kanuba0814/puzzle-arm/official_docs/README.md

# official_docs

该目录只放官方资料、论文原文和来源锁。不要把论坛总结、二手教程或未经核对的参数放入此目录。

- `competition/`：赛题原文
- `papers/`：ACT 与 LeRobot 论文
- `raspberry_pi/`：官方产品简报
- `datasheets/`：厂商规格书
- `INDEX.md`：人工阅读索引
- `sources.lock.json`：机器可读来源、版本、URL、哈希和状态

动态网页没有伪装成本地完整镜像。需要离线克隆的仓库必须在开发机上记录 commit 和 SHA256。
