kanuba0814/puzzle-arm/workspace/calibration/evidence/2026-07-31_first_hardware_motion/README.md

# 2026-07-31 首次真实硬件动作

同一台改装 SO-101 五轴机械臂完成了首次使能力矩与真实运动。全过程 Supervisor inactive，电磁铁保持关闭。

## 结果

1. 当前位置 bumpless hold：断力矩时先把五轴 `Goal_Position` 写成对应 `Present_Position`，再使能力矩 2 秒；五轴最大编码器漂移均为 0，随后断力矩。
2. 最小往返：`park → high_home → P上方60 mm → Q上方60 mm → P上方60 mm → high_home → park`。
3. 命令分辨率 1°、周期 0.1 s；观测到的最大跟随误差 `4.341246°`，低于本次 `6°` 中止阈值。
4. 各阶段最终最大误差 `2.637363°`；返回停放位最大误差 `1.054945°`。
5. production `MotionController` 随后完成 P高位（19/19 waypoints）、Q高位（7/7）、P返回（8/8）和 HOME（21/21），全部 `error_code=NONE`。
6. P 点随后完成 60/20/10/20/60 mm、每点停留 5 秒的低位观察；操作者确认 10 mm 过低或碰纸，因此拒绝作为自动安全高度。
7. P 点 20 mm 单独停留 10 秒后，操作者确认“高度合适，作为安全低位”；竞赛 PREGRASP/观察高度冻结为 20 mm，PICK 接触高度仍为 `UNKNOWN`。
8. 12 点快速巡航全部通过，但 5°/单样本到位门槛使终点在负载下提前判定，操作者观察到整体向机械臂方向缩 10–20 mm。
9. D 点精确保持将偏差显著缩小；随后使用“远离机械臂 3 mm、命令 pitch=-87.5°”负载补偿重复两次，实际姿态 `pitch=-90.03°`，操作者确认位置与垂直度均正常。
10. 最终已回到原停放区域并断力矩；未执行吸取或自动 Supervisor 流程。

## 现场教训

悬空阶段之间不能断力矩，否则重力会使关节下垂并破坏下一阶段的起点。实际 commissioning 应在一个受监控序列内持续保持力矩，最后先回到有支撑的停放位，再断力矩。

完整机器可读记录见本目录 JSON，特别是 `production_low_height_observation.json` 与 `production_precision_compensation.json`。数值来自舵机读回日志；低位和视觉对准结论包含明确标注的操作者现场观察。
