kanuba0814/puzzle-arm/docs/00_范围与冻结决策.md

# 00 范围与冻结决策

## 项目目标

在一次按键启动后，无人工干预地完成 E 题规定的碎片识别、搬运、拼接、结束指示，并适应正常室内照明。

## 赛题硬约束

- 工作面为纵向 A4 纸。
- 碎片初始位于上半区域，拼图在下半区域完成。
- 自备碎片为 4 片、同色、纯色、厚度不大于 2 mm。
- 现场碎片不大于 4 片，每片不大于 5 条边，每条边不小于 2 cm。
- 现场碎片由约 0.3 mm 镀锌薄铁片与纸片组成，总厚度不大于 2 mm、重量不大于 30 g。题面未进一步说明 30 g 是单片还是整组上限，工程验证按“任一被抓取碎片可达 30 g”这一保守条件执行。
- 目标矩形尺寸在 9 cm x 5 cm 至 12 cm x 9 cm 之间。
- 相邻碎片对应顶点距离均不大于 2 cm。
- 每项最长 2 分钟。
- 启动前摄像头被遮挡；移除遮挡并一键启动后全自动运行。
- 测试不得要求特殊照明。

## 已冻结架构

### 必做基线

- 顶置固定相机，eye-to-hand。
- OpenCV 完成标定、分割、轮廓、位姿、抓取点、放置复核。
- 几何/纹理拼图求解器输出目标位姿和顺序。
- SO-101 去掉夹爪后保留 5 个关节舵机。
- 机械臂大范围运动由 IK + 固定安全高度轨迹完成。
- 末端使用电磁吸头；电磁铁由独立 GPIO/MOSFET 状态机控制。
- 完成动作后重新拍照，失败则重新规划，不依赖开环假设。

### ACT 的固定职责

ACT 仅用于以下短程技能之一：

- 预抓取点附近最后几厘米的对准和下降；
- 预放置点附近的小范围位置与角度修正；
- 可选的失败恢复技能。

ACT 不负责：拼图求解、选择碎片、全局路径、电磁铁开关、安全限位、任务完成判定。

## 暂不采用

- SmolVLA 或更大 VLA 本地端到端控制；
- MoveIt 全套三维规划；
- 多相机首版；
- ACT 控制电磁铁开关；
- 首版复杂逆向退磁电路；
- 直接修改系统安装目录内的 LeRobot 源码。

## 关键决策门

1. 单片确定性抓放未达到 90% 成功率，不进入 ACT 数据采集。
2. 电磁铁在“纸层/结构形成的最坏有效间隙”下不能可靠吸取 30 g 保守测试片，立即换磁头或改末端。
3. Pi 5 上 ACT 推理 p95 延迟高于 500 ms、持续积压或造成控制不连续，比赛版本关闭 ACT。
4. 现场未知白色碎片几何求解未稳定，优先保证自备 50 分与现场白色 20 分，不牺牲已有功能追求花纹题。
