kanuba0814/puzzle-arm/docs/01_赛题需求追踪矩阵.md

# 01 赛题需求追踪矩阵

| 编号 | 题面要求 | 系统模块 | 验证方法 | 工程目标 |
|---|---|---|---|---|
| R1 | 自备 4 片从上半区移至下半区 | Vision、Planner、Control | 随机摆放后 20 次全流程 | 20/20 均完成搬运 |
| R2 | 自备碎片拼成正确矩形 | Template Solver、Placement | 20 次随机位置和角度 | 完整成功率 >= 95% |
| R3 | 相邻顶点距离 <= 2 cm | Vision Verify | 俯视测量顶点偏差 | 内部目标 <= 5 mm |
| R4 | 现场白色碎片不大于 4 片 | Geometry Solver | 多套模拟碎片盲测 | 20 套中 >= 18 套成功 |
| R5 | 现场扑克牌图案对应正确 | Texture Solver | 打印牌面碎片盲测 | 几何正确后纹理方案排名第一 |
| R6 | 单项 <= 2 分钟 | Supervisor、Trajectory | 统计端到端时长 | 目标 <= 90 s，预留 30 s |
| R7 | 一键启动、无人工干预 | Supervisor | 遮挡相机后启动 | 全流程无需键盘和鼠标 |
| R8 | 完成后声/光指示 | I/O | 完成与失败状态测试 | 明确区分成功、可恢复失败、终止失败 |
| R9 | 正常室内照明，无特殊照明 | Vision | 多个普通室内照明场景 | 不依赖临时补光或黑箱 |
| R10 | 碎片不重叠 | Solver、Verify | 多边形碰撞检测+图像复核 | 规划无重叠，落位后再检测 |
| R11 | 现场碎片每片至少一条外边 | Geometry Solver | 外边候选枚举 | 用于剪枝，不作为唯一假设 |
| R12 | 总厚度 <= 2 mm、重量 <= 30 g | End Effector | 等效测试片 | 通过纸层/间隙仍可靠吸放 |

## 评分优先级

1. 自备碎片搬运与拼接：50 分。
2. 现场白色碎片：20 分。
3. 现场扑克牌图案：30 分。
4. 设计报告：20 分。

任何后续功能不得破坏已经通过的上一层验收。

## 事实分类

- 表中“题面要求”来自正式 E 题 PDF。
- “工程目标”是项目内部验收阈值，不是组委会评分线。
- 对题面“重量不大于 30 g”的对象范围存在语义空间；硬件按单次抓取 30 g 的保守条件验证，最终解释仍以现场组委会为准。
