kanuba0814/puzzle-arm/docs/06_拼图求解器.md

# 06 拼图求解器

## 自备固定碎片

预先建立模板库：

- 标准轮廓与顶点顺序；
- 允许的等价旋转；
- 模板目标中心与目标角度；
- 推荐抓取点；
- 放置顺序。

运行时只做身份匹配和当前位姿估计，禁止用通用搜索替代已经确定的模板方案。

## 现场白色碎片

已知约束：碎片不大于 4 片、每片不大于 5 边、每条边不小于 2 cm、每片至少一条边属于目标矩形外边。规模很小，适合确定性枚举，而不是神经网络。

### 表示

每块碎片存储有向多边形：

- 顶点坐标；
- 边长；
- 内角/转角；
- 面积；
- 候选外边；
- 抓取点。

### 搜索

1. 枚举目标矩形尺寸候选，由总面积和边界组合约束剪枝。
2. 枚举碎片排列和离散朝向。
3. 将候选匹配边对齐，生成刚体变换。
4. 检查边长差、顶点误差、面积覆盖、碎片重叠和越界。
5. 检查所有碎片的外边约束。
6. 对完整方案按几何误差排序。

由于最多 4 片，分支限界或回溯足够，不需要近似大型优化器。

## 扑克牌图案

先生成几何可行候选，再计算纹理成本：

- 相邻边内侧窄条带的颜色/梯度差；
- 线条方向连续性；
- 花色轮廓和字符笔画连续性；
- 候选合成图的整体边界一致性。

不要首先依赖 ORB：白底牌面纹理稀疏，边缘窄条像素成本和轮廓连续性通常更直接。ORB 可作为补充证据。

## 放置顺序

- 优先放角块与边界明确的块。
- 优先放目标位置周围空间较大的块。
- 最后一块预留插入空间；如空间不足，采用从中心向外或先内部后边界的顺序。
- 每放一块重新识别，不沿用理想位姿。

## 求解器输出

每个 `PlacementPlan` 必须包含：

- `piece_id`
- `source: {frame: "table_mm", center_mm, yaw_deg}`
- `target: {frame: "table_mm", center_mm, yaw_deg}`（target yaw 为权威放置姿态）
- `order`、`geometry_score`、`texture_score`、`texture_status`
- `plan_confidence`、`source_timestamp_ns`、`equivalent_yaws_deg`
- `solver_version`

置信度不足时禁止机械臂动作。
