kanuba0814/puzzle-arm/docs/12_测试与验收计划.md

# 12 测试与验收计划

## 证据标签

- `synthetic-unit` / `synthetic-pixel`：程序生成或毫米几何测试，不能陈述为真机结果。
- `recorded-hardware`：带原始帧、标定 SHA256 的实拍回放。
- `pi5-benchmark`：仅 Pi 5 正式环境的延迟/RSS 记录。
- `blind-hardware`：冻结输入与独立 evaluator 的实体盲测。

## 分层测试

### T0 电气与通信

- 五个舵机 ID、方向、反馈、温度和电流读取。
- 电磁铁开启/关闭 100 次。
- GPIO 上电默认关闭。
- Pi、舵机和磁铁同时动作无重启、串口断连。

### T1 视觉

- 相机内参重投影误差记录。
- 20 个桌面网格点定位误差。
- 不同普通室内照明下的分割。
- 镀锌反光和白纸背景的最坏情况。

### T2 机械臂

- 确认拓扑为单台原 SO-101 follower 改装五轴，ID 1–5；拒绝 `gripper.pos`。
- 单独完成并备份 LeRobot 五轴电机 calibration 与 TCP/运动学 calibration。
- 运动学拟合至少 3 点，并保留至少 4 个未参与拟合的独立验收点。
- 内部工程门槛：holdout XY RMS <= 5 mm、XY max <= 8 mm、|Z|max <= 3 mm。
- 2026-07-31 accepted 基线实测为：XY RMS `2.480912 mm`、XY max `3.406456 mm`、|Z|max `2.458668 mm`；M/N/O/P 未参与拟合。
- production `MotionController` 已完成 HOME/P/Q 高位往返；P 点 60/20/10/20/60 mm 低位观察也已完成。
- 操作者确认 10 mm 过低或碰纸、20 mm 高度合适；竞赛 Z_SAFE=60 mm、PREGRASP=20 mm，PICK 接触高度仍为 `UNKNOWN`。
- 软限位采用同机机械端点内缩后的竞赛实用范围；完整自碰包络后置。
- 20 个网格点到达；任一路径点不可达时必须在首次发送前整体拒绝。
- 同点重复到达 30 次，保存目标与实际五轴读回；不能只记录目标寄存器。
- 每个低高度动作在电磁铁切换前必须连续稳定收敛或明确超时失败。
- 持片和空载轨迹分别验收。

### T3 电磁吸取

- 按 30 g 保守载荷和实物最坏有效磁隙制作等效结构；不得把“总厚度 2 mm”直接当成空气隙。
- 50 次连续抓取。
- 50 次连续释放。
- 偏心抓取和小碎片抓取。

### T4 单片闭环

- 随机位置和角度 40 次。
- 成功率目标 >= 95%。
- 记录抓取失败、掉落、释放失败、放置误差。

### T5 自备完整拼图

- 20 次随机不重叠摆放。
- 目标总时长 <= 90 s。
- 完整成功率目标 >= 95%。

### T6 现场白色模拟题

- 至少 20 套不同 2-4 片多边形。
- 几何求解与全流程分开统计。

### T7 扑克牌模拟题

- 多种牌面、切割和随机旋转。
- 先验证候选排序，再验证机械执行。

### T8 一键正式流程

- 摄像头遮挡。
- 随机摆片。
- 一键启动并移除遮挡。
- 无人工干预。
- 成功声光指示。

## 日志

每次测试保存：

- 原图、校正图、掩码、轮廓图；
- 求解候选和最终计划；
- 关节状态与动作；
- 磁铁事件；
- 状态机事件；
- 错误码；
- 总时间和各阶段时间。

## 冻结条件

正式版本冻结前至少完成：

- 自备完整流程连续 10 次成功；
- 现场白色模拟流程连续 5 次成功；
- 系统连续运行 1 小时无资源泄漏和温度异常；
- 断电重启后可恢复标定和配置；
- 所有关键文件有离线备份。
