kanuba0814/puzzle-arm/templates/dataset_episode_checklist.md

# ACT Episode 审查清单

- [ ] episode 起点属于定义的 PREGRASP/PREPLACE 分布
- [ ] 相机画面清晰、时间戳连续、无自动参数跳变
- [ ] 五轴字段顺序正确，无 `gripper.pos`
- [ ] action 与 observation 时间对齐
- [ ] 技能标签正确
- [ ] 完整成功，或明确归入 recovery 数据集
- [ ] 无人工遮挡、碰撞、串口异常和不可解释停顿
- [ ] 目标位置/角度覆盖信息已记录
- [ ] episode 不与验证集位置重复
- [ ] 数据集版本与标定 ID 已记录
