kanuba0814/puzzle-arm/.pi-subagents/artifacts/6ab54eb2-aecf-447e-8fad-cf6aa62a478c_reviewer_output.md

## Review

- **高：磁性 TCP 偏置/磁铁安装偏心。** 控制器验证的是关节和理论工具中心，不代表磁极中心到位。磁头相对腕轴偏心时，会产生稳定平面误差；若偏差方向随末端 yaw/腕部姿态旋转，基本可确认此项。
- **高：径向补偿或平面坐标变换存在符号、方向或重复补偿错误。** “固定向机械臂方向约 10 mm”具有明显的 `robot_base_mm` 径向特征，可能是 table→base 外参平移误差、轴方向约定错误，或补偿施加在错误坐标系。
- **中高：视觉参考点或 homography 局部偏差。** 检测轮廓质心不一定等于带铁中心；若视觉目标点本身已偏，则运动完全正确仍会落错。若误差随图像位置变化，应重点检查 homography、畸变矫正和标定平面高度；若仅不同形状变化，则优先检查“轮廓中心 vs 带铁中心”。

### 最快、可回退的单变量验证

仅在一次受控抓取中，将目标点沿“远离机械臂”的机器人基座径向平移 **10 mm**，其他变量全部保持不变，包括图像、姿态、接触高度、速度和磁铁时序。该偏移应作为有界、可置零的临时覆盖量，并先做 IK、路径及工作区检查。

- 若落点和吸附同时恢复：确认是平面定位链路的系统偏差，但尚不能区分 TCP、外参或径向补偿。
- 若误差方向随末端 yaw 改变：优先判定磁性 TCP/安装偏心。
- 若误差随工作区位置改变：优先判定 homography 或 table→base 变换。
- 若误差随纸片形状改变：优先判定视觉参考点错误。

### 推荐最小修复

先不要重做整套标定。将验证有效的偏移实现为**抓取专用、单位明确的 `robot_base_mm` 有界补偿**，默认可置零并记录日志。随后用少量不同位置/姿态落点区分根因：

1. 固定工具偏置：改为标定并应用磁极中心 TCP；
2. 固定基座径向偏差：修正 table→base 外参或补偿符号；
3. 图像位置相关：重标 homography/畸变；
4. 纸片相关：视觉直接输出带铁中心，不再使用轮廓质心。

本任务未提供或检查代码文件，因此文件路径和行号不适用；未修改文件、未运行命令。
