kanuba0814/puzzle-arm/.pi-subagents/artifacts/90ba758b-ad78-4d34-9417-3f001897be1d_advisor_output.md

All evidence gathered. Now let me pin down exact line numbers for citations before writing the report.
