kanuba0814/puzzle-arm/.pi-subagents/artifacts/2f1a0e34-86b2-4bc5-920d-480b2be4ca23_reviewer_output.md

## Review

- **Correct:** Production FK matches the fitter’s position formula and angle convention: physical angle is `direction * logical + zero_offset`, with identical cumulative shoulder/elbow/wrist pitch and tool-normal signs (`workspace/tools/fit_single_arm_kinematics.py:177-211`; `workspace/src/control/kinematics.py:219-258`).
- **Correct:** Holdout samples are excluded from parameter fitting and optimizer-start selection. `fit_model()` receives only `fit_points`, and candidate scoring uses only its residuals (`workspace/tools/fit_single_arm_kinematics.py:259-299, 319-322`). Holdouts are evaluated afterward (`:323-348`).
- **Correct:** The sheet/robot transform direction is algebraically sound. The fitted mapping is robot→sheet; the emitted primary transform correctly applies its transpose and inverse translation for sheet→robot (`workspace/tools/fit_single_arm_kinematics.py:215-243, 301-310, 400-432`). The JSON’s ±4.43177° rotations and translations are consistent.
- **Correct:** Fitter, report, calibration loader, and accepted artifact consistently use holdout limits of XY RMS ≤5 mm, XY max ≤8 mm, and |Z|max ≤3 mm (`workspace/tools/fit_single_arm_kinematics.py:26-28, 342-348, 466-471`; `workspace/src/control/calibration.py:14-16, 241-267`). Recorded holdout results pass them.
- **Correct:** J5’s fitted-contact median is used as the logical neutral. Given the frozen direction `-1`, offset `-82.153846°` makes the median logical J5 produce approximately zero physical roll, consistent with production semantics (`workspace/tools/fit_single_arm_kinematics.py:367-368`; accepted calibration `joint_mapping`).
- **Blocker:** The artifact is marked production `accepted` even though its own report explicitly labels four unresolved items as `non_metric_blockers_for_acceptance`, including unquantified hand-drawn placement uncertainty and a single magnet-extension measurement (`workspace/calibration/evidence/2026-07-31_single_arm_contacts_v2/fit_report.json:35-40`). The fitter nevertheless permits `--status accepted` based solely on the three metric thresholds (`workspace/tools/fit_single_arm_kinematics.py:342-348`) and the loader consequently authorizes real motion (`workspace/src/control/calibration.py:241-269`). Either these must be resolved, or reclassified as non-blocking limitations with a documented safety justification; as written, acceptance contradicts its own evidence.
- **Note:** Holdouts do not influence FK parameters or optimizer selection, but they are included when deriving production soft limits through `all_joints = fit + holdout` (`workspace/tools/fit_single_arm_kinematics.py:350-366`). Thus they are not completely untouched by final calibration generation, although this does not leak into the reported residuals.
- **Note:** The four holdouts are interior points from the same hand-drawn sheet and capture session. They demonstrate interpolation but do not quantify fixture/operator uncertainty or out-of-session repeatability (`workspace/calibration/evidence/2026-07-31_single_arm_contacts_v2/README.md:5-17, 29-31`).
- **Note:** Production tests verify loading and threshold gating, but do not replay the accepted artifact against the fitter report or verify evidence hashes (`workspace/tests/test_arm_calibration.py:54-66`). `require_accepted_geometry()` trusts embedded metrics rather than recomputing them.
