kanuba0814/puzzle-arm/.pi/todos/05ee3b2d.md

{
  "id": "05ee3b2d",
  "title": "完成通用拼图算法、Supervisor 与赛场 GUI 全栈",
  "tags": [
    "vision",
    "puzzle",
    "supervisor",
    "gui",
    "rpi",
    "safety"
  ],
  "status": "in_progress",
  "created_at": "2026-07-31T09:43:06.320Z"
}

以 `.taskman/plans/adopt-puzzle-vision-v2-2/{PLAN.md,context.md}` 为依据，使用隔离并行 worker：Terra:max 实现 vision/puzzle、Supervisor、部署；K3 实现 7 英寸正式 GUI。主控负责逐文件合并、审查、测试、Pi 部署与实机快速扫块。硬约束：红色基线不退化；PICK/PLACE UNKNOWN 时磁铁与自动抓放锁死；GPIO17/五轴顺序/accepted calibration 不变；generic/texture 默认关闭；不复制无许可证外部代码或素材。

## 里程碑 2026-07-31 全栈部署

- vision/puzzle/Supervisor/GUI/部署合同已合并；generic/texture 默认关闭，自动 PICK/PLACE 仍 fail-closed。
- 用户确认继电器控制链路已就绪：`/dev/gpiochip0`、BCM GPIO17、低电平触发；`magnet_enabled=true`，但 `automatic_pick_place_enabled=false` 且接触高度 UNKNOWN。
- Pi 软件自检 PASS；正式 GUI active/enabled，1024×600 三页与 fb0 像素检查通过，不持有串口/GPIO。
- 新鲜四片红块检测 PASS。
- 唯一一次磁铁关闭 `sweep-shortest` 未完成：Pi `xhci-hcd.1` 整个 USB host controller 死亡，机械臂串口返回 ENODEV 并消失；route 为空、magnet=false。证据：`workspace/calibration/evidence/2026-07-31_full_stack_deployment/`。
- 阻塞：现场先支撑机械臂并切断舵机电源，之后恢复 USB，先只读枚举/PARK 状态检查，再考虑重试巡检。不得自动重绑/重启/重试。

## 持久运动事故锁

- 用户已确认安装 `/etc/epuzzle/robot-motion.lock.json`（root:root 0644）。
- GUI/CLI 双层门禁：设备节点自行恢复也不解锁；巡检、PREGRASP、PARK、普通断力矩禁用，检测/Shadow/急停保留。
- Pi GUI/CLI 锁门禁测试 36/36；CLI `park` 实测 `FAIL / SUPERVISOR_LOCKED / magnet=false`。
- 解除锁必须完成 JSON 中 `clear_requires` 全部步骤并由现场操作者明确批准；程序无自动旁路。

## 恢复与巡检通过 2026-07-31 20:xx +08:00

- 现场操作者重启 Pi、补接舵机电源并手动删除事故锁，明确批准解除该次 xHCI 事故锁；程序未自动解锁。
- 只读恢复确认五轴枚举/校准一致；正式 PARK 生命周期 PASS，最终 Torque_Enable 五轴全 0。
- 首次恢复巡检因 deadline 时钟域混用 fail-closed；根因是 Supervisor `time.monotonic_ns()` 与 MotionController 默认 `time.time_ns()` 混用，已添加红绿回归并统一为 monotonic。
- PARK 过渡新增最终 4° 实际读回验收，途中 8° 跟随门槛不再能冒充正式 PARK 成功。
- 修复后 `sweep-shortest` PASS：路线 `red-1 -> red-2 -> red-0 -> red-3`，4 个中心均有实际五轴读回，最终 PARK 最大误差 3.516483°，magnet=false，USB 错误 0。
- 证据：`workspace/calibration/evidence/2026-07-31_usb_recovery_and_sweep/`。
- 剩余仍不解除：PICK/PLACE 接触高度 UNKNOWN、磁吸能力/热/带载验收、generic Gate C（concave/grid-4/盲测）。

## 部署自检与相机稳定路径收尾

- Sipeed MaixCAM identity 已按实机冻结：VID:PID `359f:2120`、serial `c9c28f4513595968`、capture index 0；`/dev/epuzzle-camera -> /dev/video0`。
- `detect_red_pieces.py` 与 Supervisor 默认改用 `/dev/epuzzle-camera`，仍兼容显式数字 index；稳定路径独立检测 4 片、1280×720 PASS。
- 完整 `epuzzle-selfcheck --json` 现为 `passed=true`。磁铁关闭巡检关键参数严格验收；37 个 deferred UNKNOWN 以 warning 保留，PICK/PLACE、磁吸带载、generic/texture 仍由对应门禁 fail-closed。
- GUI active、Supervisor inactive、magnet-safe active、串口/GPIO/camera 无 holder、当前启动 USB 错误 0。
