kanuba0814/puzzle-arm/.pi/todos/d45a43a8.md

{
  "id": "d45a43a8",
  "title": "重建单臂五轴确定性运动控制核心",
  "tags": [
    "control",
    "rpi",
    "safety"
  ],
  "status": "closed",
  "created_at": "2026-07-31T00:56:41.210Z"
}

按实际单臂（原 SO-101 follower 改装，ID1-5，无 gripper，电磁铁独立 GPIO17）完成确定性控制重建与实机验收。

## 完成项

- `MotionGoal(robot_base_mm) -> MotionResult` 深模块、配置驱动 FK/IK、全路径预检、实际位置收敛、严格五轴插件与标定质量门禁已完成。
- accepted 运动学、五轴电机标定、TCP、PARK、A4 homography 与 runtime manifest 已冻结并有证据哈希。
- bumpless 首次使能、PARK↔HOME 关节空间恢复、60/20 mm 高度、D 点精确补偿和红片中心巡检已实机验证。
- xHCI 故障后由现场操作者完成重启、供电恢复和事故锁人工解除；只读确认五轴与冻结标定一致。
- PARK 过渡新增最终 4° 实际读回门禁；MotionController deadline 统一为 `time.monotonic_ns()`，均有红绿回归。
- 修复后磁铁关闭 `sweep-shortest` 实机 PASS，路线 `red-1 -> red-2 -> red-0 -> red-3`，四个中心均有实际五轴读回。
- 最终 PARK 最大误差 3.516483°，Torque_Enable 五轴全 0，串口/GPIO无 holder，本次启动 USB 错误 0。
- 证据：`workspace/calibration/evidence/2026-07-31_usb_recovery_and_sweep/`。

PICK/PLACE 接触高度、磁吸带载/热验收和 generic Gate C 属于后续独立任务，不属于控制核心完成条件。
