kanuba0814/puzzle-arm/.taskman/plans/adopt-puzzle-vision-v2-2/context.md

# 外部拼图视觉算法吸收：规划上下文

## Intent

- 利用 `lvreng/puzzle-vision-simulator` 的优秀算法思想，补齐本项目尚未落地的通用视觉与拼图求解实现。
- 取其精华：圆角物理轮廓到虚拟直角、最多 4 片的确定性枚举、完整/部分边匹配、全局矩形评分、像素隔离测试。
- 去其糟粕：不搬运 1300 行单体脚本，不保留固定像素阈值、固定 10 cm×6 cm、运行时 `cut_mode`、静默纹理回退或缺少置信度的行为。
- 不破坏当前红色碎片检测、五轴控制、电磁铁安全和自备题确定性基线；新功能先离线、再 shadow、最后按 Gate C/E 启用。

## Decisions

- **独立重实现，不复制源码或素材。** 外部仓库标签 `v2.2.0-vision-rounded-card` 指向提交 `fbd9c1cbb9b621c0a54101cc421cc43d54926222`，仓库未提供 LICENSE；只吸收公开算法思想和经验证行为。
- **两个深模块、两个公共接口。** `vision.observe_pieces(...) -> VisionResult` 与 `puzzle.solve_puzzle(...) -> PuzzleSolveResult` 是调用方和测试共同使用的 seam；分割、圆角、边描述、候选搜索等保持私有实现。
- **统一在校正后的桌面尺度工作。** 形态学核、圆角弦长、边长容差等由 mm 或 `px_per_mm` 推导，不照搬外部像素常数。
- **同时保留物理轮廓和虚拟几何。** 物理轮廓用于抓取、纹理和诊断；虚拟直角多边形用于几何求解。不得用凸包无条件抹掉凹边。圆角虚拟化由显式材料 profile 控制，白色金属片 profile 默认关闭。
- **一个观察可携带多个显式坐标字段，但每个字段自行声明 frame/unit。** 顶层位姿使用 `table_mm`；物理轮廓使用嵌套的 `rectified_px` 对象，禁止让一个裸 `frame=table_mm` 暗示像素点也是毫米。
- **运行时不接收切割拓扑真值。** `cut_mode` 只允许测试生成器内部使用；生产求解器统一枚举完整边、端点锚定部分边、带有界连续偏移的内部部分边和合法图结构。
- **目标矩形尺寸必须推断或来自自备模板。** 现场题在官方 90×50 mm 至 120×90 mm 范围内搜索，不固定 100×60 mm。
- **几何先行，纹理只重排几何可行候选。** 未知现场牌面采用接缝窄条、颜色/梯度/线条连续性；已知自备牌面才允许启用独立的参考图特征配准 adapter。
- **不使用“完整牌面恰有 4 个圆角”作为硬选择规则。** 在扑克牌 profile 中它只能作为诊断或弱先验，不能把真实切割顶点强行改成圆角。
- **显式处理歧义。** 对等分矩形、对称碎片和最佳/次佳分数接近的情况返回等价类或 `SOLVER_AMBIGUOUS`，不得伪造唯一答案；最佳/次佳比较必须在等价类去重之后进行。
- **只允许 SE(2) 正旋转。** 禁止镜像解；若碎片背面朝上或表面不符合 profile，视觉层必须拒绝而不是用反射“拼好”。
- **接触/无缝贴合是可观测性问题。** 先尝试用阈值稳定性、颈部/分水岭和可见接缝分离；证据不足时返回计数歧义或 merged-blob 错误，不假装识别成功。
- **现有红色路径保持默认。** 新通用检测/求解由配置关闭，先离线回放和 shadow；通过 Gate C 后才允许白色现场题调用，Gate E 后才允许扑克牌调用。

## Constraints

- 赛题事实以 `official_docs/competition/E题_拼图装置.pdf` 为准：碎片数量不大于 4、每片不超过 5 边、边长不小于 20 mm、每片至少一条目标外边、目标矩形文字范围为 90×50 mm 至 120×90 mm、最长 120 s。当前工程夹具覆盖 2/3/4 片；现场数量下限不是已确认的题面事实。
- 项目优先级固定：安全与确定性基线 > 自备 50 分 > 白色 20 分 > 扑克牌 30 分 > ACT。
- `vision` 只输出观察；`puzzle` 只输出计划；只有 Supervisor 能切换全局状态和控制电磁铁。
- 跨模块字段必须带 frame 和单位；`PieceObservation` 使用 `table_mm`，不得输出裸像素位姿给控制层。
- 接口变更必须同步 `data_contracts/`、`docs/10_接口与数据契约.md` 和测试。
- 所有验证数字必须来自日志；合成测试、开发机测试、Pi 5 基准和实机测试必须明确区分。
- 当前 `workspace/src/vision/red_piece_detector.py` 是已用路径；`workspace/src/puzzle/` 尚无生产实现。
- 当前 A4 单应证据为 RMS 0.257541 mm、最大 1.029862 mm；这是标定证据，不等于新视觉/求解算法精度。
- ACT 保持关闭；本计划不扩大到机械臂 IK、电磁铁或部署发布。

## Open questions

- **不阻塞：校正图尺度。** 以 2–3 px/mm 为候选，通过 Pi 5 精度/延迟基准冻结，计划中不预先捏造最优值。
- **不阻塞：通用白色/印刷牌的最佳分割 profile。** 先实现背景自适应亮度基线，再用真实 holdout 决定是否需要 HSV/Lab 多假设融合。
- **阻塞现场启用确认：碎片是否保证纸面/印刷面朝上。** 题面未明确，保持 `UNKNOWN`；未确认前加入金属背面拒绝路径，不允许镜像求解。
- **阻塞无条件计数保证：现场是否保证碎片之间存在可见间隙，以及现场碎片数量下限。** 完全无缝接触在单幅俯视图中可能不可辨识；计划要求检测/拒绝，不能声称总能分割。
- **不阻塞离线实现：目标尺寸文字范围按宽 90–120 mm、高 50–90 mm 的 1 mm 网格并枚举方向交换；最终解释仍待现场规则确认。**
- **阻塞 Gate E、但不阻塞白色几何：真实扑克牌盲测集尚未采集。** 需至少多个不同牌面、切割和旋转，且调参与冻结 holdout 分离。
- **阻塞真机启用、但不阻塞离线实现：正式 PICK/PLACE 接触高度与正式 `table_mm -> robot_base_mm` 变换仍为 `UNKNOWN`。** 本计划在 shadow 阶段不发送动作。

## Discarded options

- **直接 vendor 外部仓库或复制 `puzzle_sim.py`。** 拒绝：无明确许可证，且生成、渲染、视觉、求解、CLI 混在单体脚本中，破坏本项目架构。
- **固定 10 cm×6 cm 目标。** 拒绝：只覆盖官方尺寸范围中的一个点。
- **由 UI/调用方传 `common`、`concave`、`t_junction` 等模式。** 拒绝：现场没有拓扑真值，会把仿真信息泄漏进生产求解。
- **普通模式先取凸包、凹形模式特判。** 拒绝：未知现场凹片会被不可逆抹平。
- **以 SIFT 对已知 Joker 参考图作为现场扑克牌主算法。** 拒绝：现场完整参考图未知；SIFT 仅保留为已知模板的可选 adapter。
- **纹理失败后静默退回几何并继续动作。** 拒绝：必须记录原因；花纹题若歧义未解除应停止，而不是报告成功。
- **面积大小直接映射为 confidence。** 拒绝：置信度必须综合分割稳定性、轮廓完整性、多边形拟合、抓取净空和候选分数间隔，并由 holdout 校准。
- **一开始接 Supervisor 真机。** 拒绝：先离线回放、Pi 基准和 shadow，避免破坏已通过的控制基线。

## Blast radius

- 本计划不删除、重命名或缩窄现有符号。
- `detect_red_pieces`、`RedPieceObservation`、`workspace/tools/detect_red_pieces.py` 和当前 GUI 调用保持兼容，直到新接口通过 shadow；若后续迁移/删除，必须另立计划并对每个导出符号做全仓引用证明。
