kanuba0814/puzzle-arm/.pi-subagents/artifacts/outputs/013ccd5f-fe0b-4486-9ffa-56d395305815/docs/22_树莓派5系统镜像官方依据.md

# 22_树莓派5系统镜像官方依据

> 任务范围：只依据 Raspberry Pi 官方 docs/下载站/pi-gen、Debian 官方资料、Hugging Face LeRobot v0.6.0 官方文档/源码/PyPI。
>
> 统一访问日期：2026-07-29（按任务要求记录）。

## 结论摘要

对“Raspberry Pi 5 8GB + 64GB SD + Raspberry Pi OS Lite 64-bit Trixie + LeRobot v0.6.0”的官方依据核对结果如下：**OS 选型、Debian Trixie / Python 3.13、Pi 5 供电散热、CSI 相机、GPIO/串口、headless 首启、systemd 硬化、LeRobot 0.6.0 commit 绑定、torch 2.7.1 与 torchvision 0.22.1 的 arm64/cp313 wheel**均可在一手资料中找到直接或间接依据。**“OpenCV 4.13”无官方 PyPI 发布依据；SO-101/SR-ARM101 去夹爪五轴、电磁铁 GPIO/MOSFET 具体接线、顶置 UVC 具体型号兼容性**在限定来源内仍属 **UNKNOWN/需实机验证**。

## 逐项核对

### 1. 主板与镜像基线

1. **Raspberry Pi 5 8GB 有官方产品型号依据，适合作为镜像目标**。Raspberry Pi 官方产品页/产品简报覆盖 Raspberry Pi 5 产品线；本任务指定的 8GB 容量属于官方销售规格。  
   官方 URL：<https://www.raspberrypi.com/products/raspberry-pi-5/>  
   官方 URL：<https://pip-assets.raspberrypi.com/categories/892-raspberry-pi-5/documents/RP-008348-DS-4-raspberry-pi-5-product-brief.pdf>  
   访问日期：2026-07-29

2. **Raspberry Pi OS Lite 是官方命令行版，Trixie 是当前官方大版本依据**。Raspberry Pi OS 官方文档说明 Lite 为 command-line only；Debian 13 Trixie 是当前 Raspberry Pi OS 所基于的 Debian 大版本。  
   官方 URL：<https://www.raspberrypi.com/documentation/computers/os.html>  
   官方 URL：<https://www.raspberrypi.com/software/operating-systems/>  
   访问日期：2026-07-29

3. **64-bit / arm64 是本任务应采用的架构表达**。Debian 官方对 CPU 术语使用 “64-bit ARM (AArch64)”，但软件仓库/包架构名使用 **arm64**；因此镜像、APT、wheelhouse、systemd 部署文档都应以 **arm64** 为准。  
   官方 URL：<https://www.debian.org/releases/trixie/index>  
   官方 URL：<https://www.debian.org/News/2025/20250809.en.html>  
   访问日期：2026-07-29

### 2. Python / Debian / 兼容性

1. **Debian 13 Trixie 官方自带 Python 3.13，满足“Python >=3.12”且更接近上限**。Debian 官方新闻与包页面确认 trixie 提供 python3.13；包页列出 arm64 架构。  
   官方 URL：<https://www.debian.org/News/2025/20250809.en.html>  
   官方 URL：<https://packages.debian.org/trixie/python3.13>  
   访问日期：2026-07-29

2. **LeRobot v0.6.0 官方要求 Python >=3.12，因此在 Trixie / Python 3.13 上“版本下限”成立**。LeRobot 安装文档、PyPI 元数据、v0.6.0 对应源码 pyproject.toml 都写明 `requires-python >=3.12`。  
   官方 URL：<https://huggingface.co/docs/lerobot/en/installation>  
   官方 URL：<https://pypi.org/project/lerobot/0.6.0/>  
   官方 URL：<https://github.com/huggingface/lerobot/blob/30da8e687a6dfc617fcd94afc367ac7071c376ce/pyproject.toml>  
   访问日期：2026-07-29

3. **但“Python 3.13 上整套依赖全部可用”不能仅由 LeRobot 官方文档完全担保，需要逐包核对 wheel**。在限定来源内，torch 2.7.1 与 torchvision 0.22.1 可确认有 cp313/aarch64 wheel；OpenCV 4.13 不能确认。故 **Python 3.13 + LeRobot 0.6.0 具备较强官方依据，但不是零风险**。  
   官方 URL：<https://pypi.org/pypi/torch/2.7.1/json>  
   官方 URL：<https://pypi.org/pypi/torchvision/0.22.1/json>  
   官方 URL：<https://pypi.org/pypi/opencv-python-headless/json>  
   官方 URL：<https://pypi.org/pypi/opencv-python/json>  
   访问日期：2026-07-29

### 3. LeRobot 版本与 ACT

1. **LeRobot v0.6.0 与 commit `30da8e687a6dfc617fcd94afc367ac7071c376ce` 可以官方对齐**。GitHub 官方 release `v0.6.0` 指向 `30da8e6`；该 commit 下 pyproject 版本号为 `0.6.0`；PyPI `lerobot 0.6.0` 上传日期与 release 日期一致。  
   官方 URL：<https://github.com/huggingface/lerobot/releases/tag/v0.6.0>  
   官方 URL：<https://github.com/huggingface/lerobot/tree/30da8e687a6dfc617fcd94afc367ac7071c376ce>  
   官方 URL：<https://pypi.org/project/lerobot/0.6.0/>  
   访问日期：2026-07-29

2. **ACT 在 LeRobot 0.6.0 中是官方可选策略，不是基础镜像必须默认启用的组件**。LeRobot 官方 ACT 文档说明 ACT 为一个 policy；安装文档显示核心安装与训练/特定机器人 extra 分离。因此“ACT 默认关闭”是**合理的工程默认**，但这不是 Raspberry Pi / Debian / LeRobot 的官方强制要求。  
   官方 URL：<https://huggingface.co/docs/lerobot/en/act>  
   官方 URL：<https://huggingface.co/docs/lerobot/en/installation>  
   访问日期：2026-07-29

### 4. Headless：用户、SSH、网络

1. **Headless 首启可由 Raspberry Pi Imager 官方预配置用户名、SSH、网络**。Raspberry Pi 官方 getting started 文档明确支持通过 Imager 在写盘前配置 hostname、用户、SSH、网络。  
   官方 URL：<https://www.raspberrypi.com/documentation/computers/getting-started.html>  
   官方 URL：<https://www.raspberrypi.com/software/>  
   访问日期：2026-07-29

2. **传统 headless 回退法仍有官方依据：`ssh` + `userconf.txt`**。官方文档说明若未通过 Imager 预配置，可在 bootfs 放置空文件 `ssh` 并用 `userconf.txt` 写入 `username:encrypted-password`；密码哈希可用 `openssl passwd -6`。  
    官方 URL：<https://www.raspberrypi.com/documentation/computers/getting-started.html>  
    访问日期：2026-07-29

3. **NetworkManager 是 Raspberry Pi OS Bookworm 以来的默认网络栈，Trixie 沿用该方向；同时 Trixie 新增 cloud-init / Netplan 首启路径**。官方新闻说明 2025-11-24 之后的 Trixie 镜像引入 cloud-init，boot 分区包含 `user-data` / `network-config` / `meta-data`，并逐步替代旧 `firstrun.sh` 定制流程；旧 `ssh` + `userconf.txt` 仍可用。  
    官方 URL：<https://www.raspberrypi.com/news/cloud-init-on-raspberry-pi-os/>  
    官方 URL：<https://www.raspberrypi.com/documentation/computers/getting-started.html>  
    官方 URL：<https://www.raspberrypi.com/documentation/computers/os.html>  
    访问日期：2026-07-29

4. **镜像侧建议：优先采用 Imager / cloud-init 预置用户、SSH、公钥和网络，不再依赖旧式 `wpa_supplicant.conf` boot hack**。在限定官方来源内，Trixie 的方向是 cloud-init + Netplan + NetworkManager；旧方法仅作 fallback。  
    官方 URL：<https://www.raspberrypi.com/news/cloud-init-on-raspberry-pi-os/>  
    官方 URL：<https://www.raspberrypi.com/documentation/computers/getting-started.html>  
    访问日期：2026-07-29

### 5. Pi 5 供电、散热、相机、GPIO、串口

 1. **Pi 5 官方推荐 27W USB-C 供电；若只用 5V/3A，USB 外设电流会受限**。官方文档说明 Pi 5 推荐 27W USB-C PSU；5A@5V 时下游 USB 可到 1.6A，若用 3A 电源则限制到 600mA。对 UVC 摄像头、USB 转串口、风扇等外设组合，这条是硬约束。  
    官方 URL：<https://www.raspberrypi.com/documentation/computers/raspberry-pi.html>  
    官方 URL：<https://www.raspberrypi.com/documentation/computers/getting-started.html>  
    访问日期：2026-07-29

 2. **Pi 5 热设计必须纳入镜像验收：80–85°C 开始渐进降频，85°C 触发更强节流**。官方文档给出温控阈值；因此长时间推理、OpenCV、录像、训练都应默认配主动散热或至少实测热余量。  
    官方 URL：<https://www.raspberrypi.com/documentation/computers/raspberry-pi.html>  
    访问日期：2026-07-29

 3. **官方 CSI 相机支持有直接依据；Pi 5 使用 22-pin 相机连接体系，仍兼容官方相机文档链路**。Raspberry Pi 相机文档覆盖 CSI 相机接法与使用；Pi 5 官方文档说明旗舰型自 Pi 5 起采用新的 22-pin camera/display connector 体系。若选 Pi Camera 路线，官方依据充分。  
    官方 URL：<https://www.raspberrypi.com/documentation/accessories/camera.html>  
    官方 URL：<https://www.raspberrypi.com/documentation/computers/raspberry-pi.html>  
    访问日期：2026-07-29

 4. **“顶置 UVC 摄像头”在限定来源内缺少针对具体型号的官方兼容清单，因此只能判定为 Linux/UVC 常规路径，具体设备需实机验证**。Raspberry Pi 官方资料更偏向 CSI/libcamera；未在本次限定来源内拿到具体 UVC 型号兼容白名单。  
    官方 URL：<https://www.raspberrypi.com/documentation/computers/getting-started.html>  
    官方 URL：<https://www.raspberrypi.com/documentation/accessories/camera.html>  
    访问日期：2026-07-29  
    结论：**UNKNOWN（需实机验证）**

 5. **GPIO 与串口有官方依据，但电磁铁 GPIO/MOSFET 具体电路不在限定来源内**。Pi 5 官方资料可确认 GPIO/UART 能力与主串口映射；Pi 5 的 `/dev/serial0` 指向主 UART（Pi 5 上通常为 `ttyAMA10`），且主 UART 默认更偏向调试口而非老型号的 GPIO14/15 直出语义。  
    官方 URL：<https://www.raspberrypi.com/documentation/computers/io-controllers.html>  
    官方 URL：<https://www.raspberrypi.com/documentation/computers/raspberry-pi.html>  
    官方 URL：<https://www.raspberrypi.com/documentation/configuration/config-txt/memory.md>  
    访问日期：2026-07-29

 6. **GPIO 直接驱动电磁铁没有官方依据，必须通过外部驱动级（如 MOSFET/续流）实现；但具体器件、栅极电平、续流二极管参数在本任务允许来源内均为 UNKNOWN**。本次只能确认“Pi 5 有 GPIO”；不能从允许来源推出某一电磁铁驱动电路已经被官方认证可直接复用。  
    官方 URL：<https://www.raspberrypi.com/documentation/computers/raspberry-pi.html>  
    访问日期：2026-07-29  
    结论：**UNKNOWN（需按实物电磁铁参数做电气设计与台架验证）**

### 6. systemd 与安全硬化

 1. **Debian trixie 官方 manpage 为 systemd 服务硬化提供直接依据**。可用硬化项包括 `NoNewPrivileges=`, `ProtectSystem=`, `ProtectHome=`, `PrivateTmp=`, `CapabilityBoundingSet=`, `SystemCallFilter=`, `DynamicUser=`。对上位机服务，这些选项可作为默认模板。  
    官方 URL：<https://manpages.debian.org/trixie/systemd/systemd.exec.5.en.html>  
    官方 URL：<https://manpages.debian.org/trixie/systemd/systemd.service.5.en.html>  
    访问日期：2026-07-29

 2. **推荐的镜像安全基线（有官方 manpage 依据）**：
    - `NoNewPrivileges=yes`
    - `ProtectSystem=strict`
    - `ProtectHome=yes` 或 `read-only`
    - `PrivateTmp=yes`
    - 最小化 `CapabilityBoundingSet=`
    - 若程序支持，再考虑 `DynamicUser=yes` / `Type=notify`

    但这些是**可由官方机制支撑的工程建议**，并非针对本项目的现成官方 unit 文件。GPIO、串口、相机、日志写目录会影响最终 hardening 取值，故仍需联调验证。  
    官方 URL：<https://manpages.debian.org/trixie/systemd/systemd.exec.5.en.html>  
    官方 URL：<https://manpages.debian.org/trixie/systemd/systemd.service.5.en.html>  
    访问日期：2026-07-29

### 7. wheel / 依赖可用性 / 离线 wheelhouse

 1. **torch 2.7.1 在官方 PyPI 元数据中可确认存在 `cp313` + `manylinux_2_28_aarch64` wheel**。这是 Trixie/Python 3.13/arm64 组合的重要正面依据。已检到文件名：`torch-2.7.1-cp313-cp313-manylinux_2_28_aarch64.whl`。  
    官方 URL：<https://pypi.org/pypi/torch/2.7.1/json>  
    访问日期：2026-07-29

 2. **torchvision 0.22.1 在官方 PyPI 元数据中也可确认存在 `cp313` + `manylinux_2_28_aarch64` wheel**。已检到文件名：`torchvision-0.22.1-cp313-cp313-manylinux_2_28_aarch64.whl`。  
    官方 URL：<https://pypi.org/pypi/torchvision/0.22.1/json>  
    访问日期：2026-07-29

 3. **“OpenCV 4.13”当前没有拿到官方 PyPI 发布依据，应视为不成立而非默认成立**。在官方 PyPI 项目级 JSON 中，本次未确认存在 `opencv-python(-headless)` 的 4.13 版本；因此不能把“OpenCV 4.13”写成已被官方源支持的镜像约束。  
    官方 URL：<https://pypi.org/pypi/opencv-python/json>  
    官方 URL：<https://pypi.org/pypi/opencv-python-headless/json>  
    访问日期：2026-07-29  
    判定：**高风险偏差**

 4. **LeRobot 0.6.0 的 `feetech` extra 有官方安装入口，但 “Feetech wheel 在 arm64/Python 3.13 可用” 仍未完全坐实**。安装文档能证明 `.[feetech]` / `lerobot[feetech]` 是官方支持路径；但限定来源下未拿到完整的 arm64/cp313 Feetech wheel 证据链。  
    官方 URL：<https://huggingface.co/docs/lerobot/en/installation>  
    官方 URL：<https://pypi.org/project/feetech-servo-sdk/>  
    访问日期：2026-07-29  
    结论：**部分 UNKNOWN（需先拉 wheelhouse 再在实机 cold install 验证）**

 5. **离线 wheelhouse 有官方来源基础，但锁定结果必须由目标平台实测**。理由是 PyPI 官方提供发行文件与元数据；torch / torchvision / lerobot 可先下载入 wheelhouse。是否能做到“全离线一次安装成功”，仍取决于未完全坐实的 OpenCV/Feetech 依赖闭包。  
    官方 URL：<https://pypi.org/project/lerobot/0.6.0/>  
    官方 URL：<https://pypi.org/pypi/torch/2.7.1/json>  
    官方 URL：<https://pypi.org/pypi/torchvision/0.22.1/json>  
    官方 URL：<https://pypi.org/pypi/opencv-python-headless/json>  
    访问日期：2026-07-29

### 8. 镜像下载、哈希、写盘校验、首次扩容

 1. **官方镜像应从 Raspberry Pi OS 下载站获取，并以页面公布的 SHA256 为准**。Raspberry Pi 官方 OS 下载页列出每个镜像的 file integrity hash。  
    官方 URL：<https://www.raspberrypi.com/software/operating-systems/>  
    访问日期：2026-07-29

 2. **官方写盘工具首选 Raspberry Pi Imager，且官方文档明确要求完成 Verify 步骤**。这可作为写盘验收项。  
    官方 URL：<https://www.raspberrypi.com/software/>  
    官方 URL：<https://www.raspberrypi.com/documentation/computers/getting-started.html>  
    访问日期：2026-07-29

 3. **首次扩容通常由 Raspberry Pi OS 自动完成；一般不应把手工扩容当作标准操作步骤**。官方文档说明在大多数情况下 Raspberry Pi OS 会在首次启动时自动扩展文件系统；手工扩容更多针对非 Raspberry Pi OS 或异常场景。  
    官方 URL：<https://www.raspberrypi.com/documentation/computers/os.html>  
    官方 URL：<https://www.raspberrypi.com/documentation/computers/configuration.html>  
    访问日期：2026-07-29

### 9. 与项目目标逐项对照

| 目标项 | 官方核对结论 |
| --- | --- |
| Raspberry Pi 5 8GB | **成立** |
| 64GB SD | **可用但非官方硬性要求；容量选择属工程决策** |
| Raspberry Pi OS Lite 64-bit Trixie | **成立** |
| Python >=3.12 | **成立；Trixie 为 Python 3.13** |
| LeRobot v0.6.0 @ `30da8e6...` | **成立** |
| ACT 默认关闭 | **工程默认合理，但非官方硬要求** |
| headless 用户/SSH | **成立** |
| NetworkManager | **成立** |
| cloud-init/Netplan on Trixie | **成立** |
| Pi 5 供电散热 | **成立** |
| Pi Camera | **成立** |
| 顶置 UVC | **UNKNOWN（需实机验证）** |
| GPIO / 串口能力 | **成立** |
| 电磁铁 GPIO/MOSFET 具体设计 | **UNKNOWN（需电气设计验证）** |
| torch 2.7.1 aarch64 cp313 | **成立** |
| torchvision 0.22.1 aarch64 cp313 | **成立** |
| OpenCV 4.13 | **不成立/未证实** |
| LeRobot/Feetech arm64 cp313 一次性离线安装 | **部分 UNKNOWN** |
| 离线 wheelhouse | **可做，但需闭包实测** |
| 镜像哈希 / 写盘校验 / 首次扩容 | **成立** |
| SO-101/SR-ARM101 去夹爪五轴 | **限定来源内不足，需实机/项目资料确认** |

## 建议落地口径

1. **镜像基线可写为**：Raspberry Pi 5 8GB / Raspberry Pi OS Lite 64-bit (Debian 13 Trixie) / arm64 / Python 3.13。
2. **首启策略可写为**：优先 Raspberry Pi Imager 预置用户、SSH、公钥、网络；Trixie 新镜像优先 cloud-init；保留 `ssh` + `userconf.txt` 回退路径。
3. **依赖基线可写为**：LeRobot 0.6.0（commit `30da8e687a6dfc617fcd94afc367ac7071c376ce`）、torch 2.7.1、torchvision 0.22.1；**不要把 OpenCV 4.13 写成已获官方依据**。
4. **安全基线可写为**：systemd 服务默认启用 `NoNewPrivileges=yes`、`ProtectSystem=strict`、`PrivateTmp=yes` 等，再按 GPIO/串口/相机访问需求放宽。
5. **硬件表述需保守**：SO-101/SR-ARM101 去夹爪五轴、电磁铁驱动级、UVC 型号兼容性必须标记为 **UNKNOWN/待实机验证**，不得写成官方已确认。

## 来源筛选

### Kept

- Raspberry Pi OS docs（<https://www.raspberrypi.com/documentation/computers/os.html>）— 官方 OS 版本、Lite 定义、首次扩容路径。
- Raspberry Pi getting started（<https://www.raspberrypi.com/documentation/computers/getting-started.html>）— Imager、SSH、`userconf.txt`、写盘 Verify。
- Raspberry Pi OS downloads / software（<https://www.raspberrypi.com/software/operating-systems/>，<https://www.raspberrypi.com/software/>）— 官方镜像下载与哈希入口。
- Raspberry Pi hardware/camera/io docs（<https://www.raspberrypi.com/documentation/computers/raspberry-pi.html>，<https://www.raspberrypi.com/documentation/accessories/camera.html>，<https://www.raspberrypi.com/documentation/computers/io-controllers.html>）— Pi 5 供电散热/相机/UART。
- Raspberry Pi cloud-init news（<https://www.raspberrypi.com/news/cloud-init-on-raspberry-pi-os/>）— Trixie 首启新机制。
- pi-gen（<https://github.com/RPi-Distro/pi-gen>）— 官方镜像构建来源。
- Debian trixie/release/package/manpages（<https://www.debian.org/releases/trixie/index>，<https://packages.debian.org/trixie/python3.13>，<https://manpages.debian.org/trixie/systemd/systemd.exec.5.en.html>）— Python 3.13、systemd 硬化官方依据。
- LeRobot docs/release/source/PyPI（<https://huggingface.co/docs/lerobot/en/installation>，<https://github.com/huggingface/lerobot/releases/tag/v0.6.0>，<https://pypi.org/project/lerobot/0.6.0/>）— 版本、Python 要求、ACT、commit 锁定。
- PyPI JSON for torch/torchvision/opencv — 发行文件与 wheel 可用性元数据。

### Dropped

- Raspberry Pi forum / 社区帖子 — 非本任务允许的一手来源。
- 第三方博客、教程、Ubuntu/Arch 社区经验贴 — 非官方一手来源。
- 非目标版本 LeRobot / 非 v0.6.0 文档 — 避免版本漂移。

## UNKNOWN 与实机验证清单

1. **SO-101 / SR-ARM101 去夹爪五轴**：限定来源内未形成完整官方机械配置证据链，需结合实物 BOM、舵机拓扑、项目侧数据契约确认。
2. **电磁铁 GPIO/MOSFET 驱动电路**：需按实际电磁铁电流、电压、续流设计、EMI、共地与回扫情况做台架验证。
3. **顶置 UVC 摄像头具体型号**：需验证枚举、供电、分辨率/FPS、V4L2 节点、长时间稳定性。
4. **Feetech 相关依赖在 arm64/Python 3.13 的完整离线闭包**：需先生成 wheelhouse 再在断网 Pi 5 上 cold install。
5. **OpenCV 替代版本**：既然 4.13 未证实，应改成“以官方已发布版本为准”，并在目标平台做 import/摄像头/编解码验证。
6. **64GB SD 实际 endurance 与写放大**：官方来源能证明可用 microSD，但无法替代特定卡型号的寿命/性能实测。

## 残余风险

1. **高风险**：文档目标若仍写“OpenCV 4.13”，会与官方可证发布状态冲突。
2. **中风险**：Trixie 的 cloud-init/Netplan 与旧 `userconf.txt` 流程并存，自动化脚本若混用可能导致首启配置漂移。
3. **中风险**：Pi 5 若使用非 27W 官方供电，UVC 摄像头/USB 外设/风扇并挂时可能触发欠压或 USB 电流限制。
4. **中风险**：systemd `ProtectSystem=strict` / `DynamicUser=` 可能影响 GPIO、串口、相机设备访问与日志落盘，需要逐项放行。
5. **中风险**：LeRobot 0.6.0 虽支持 Python >=3.12，但完整依赖闭包在 arm64/cp313 上仍需用最终 wheelhouse 做一次断网冷安装验证。
6. **中风险**：电磁铁驱动级、电源回扫、地线噪声未在限定来源内得到现成官方方案，必须台架验证后再固化到镜像默认服务。
