kanuba0814/puzzle-arm/pi_puzzle/celibrater/E题视觉标定板_A4_ChArUco_8x11_16mm_小尺寸对比版.pdf

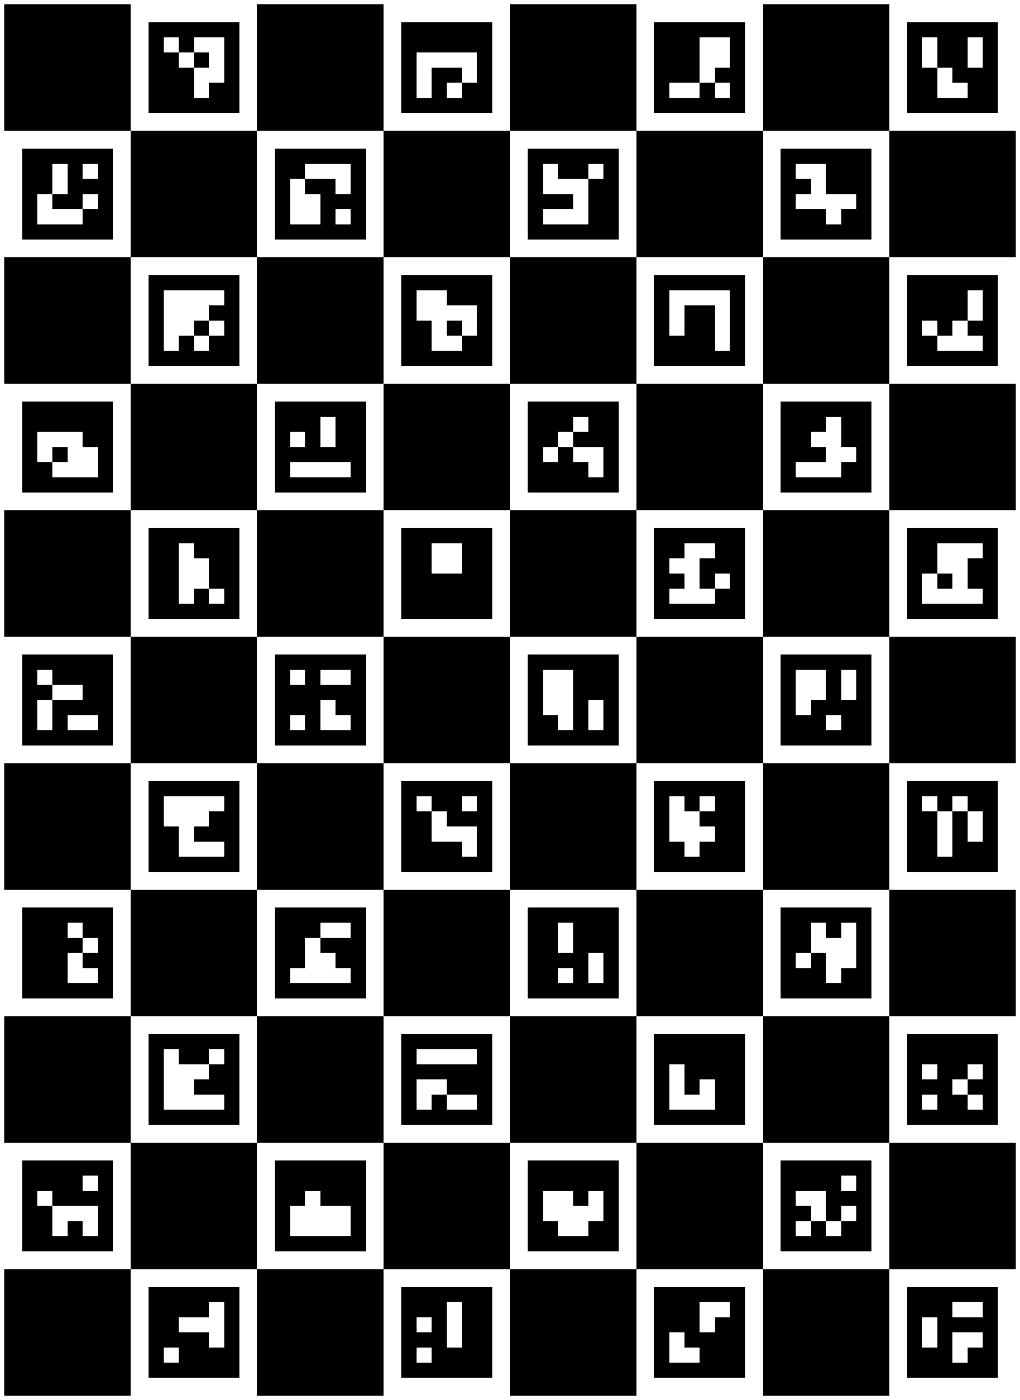
[picture p2: figure]

## ChArUco 8x11 | square 16.00 mm | marker 11.50 mm | DICT_4X4_50

Compact comparison version - print at 100% / Actual size / no fit-to-page

Board physical size: 128.00 x 176.00 mm | same 70 ChArUco corners as the 22 mm version
0 | 50 mm | 100 mm
