kanuba0814/puzzle-arm/pi_puzzle/celibrater/E题视觉标定板_A4_ChArUco_8x11_22mm.pdf

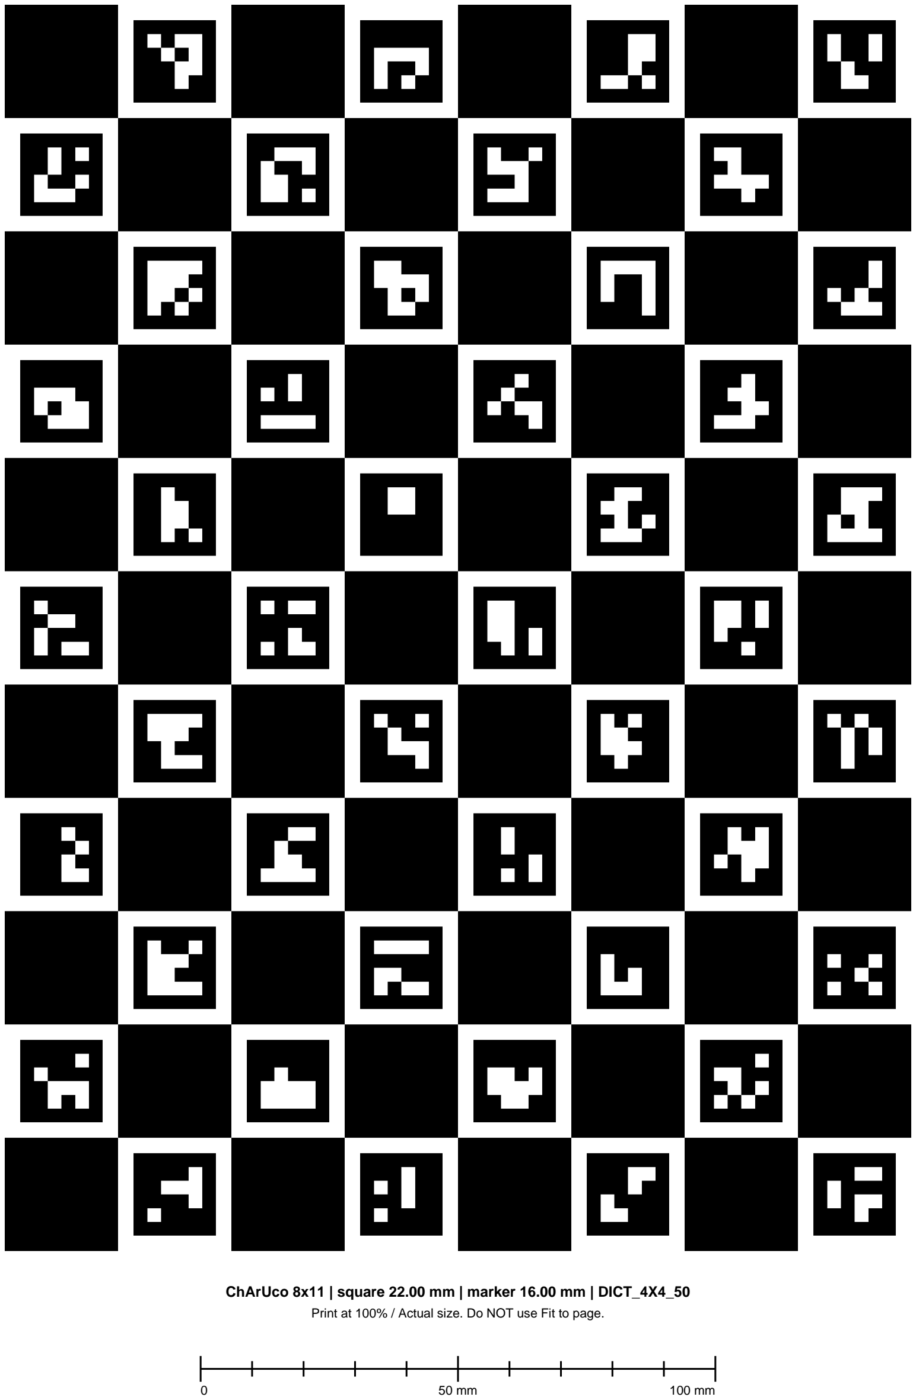
[picture p3: page 1]

### ChArUco 8x11 | square 22.00 mm | marker 16.00 mm | DICT_4X4_50

Print at 100% / Actual size. Do NOT use Fit to page.

0 | 50 mm | 100 mm
