kanuba0814/puzzle-arm/workspace/datasets/README.md

# datasets

此目录的文件必须记录来源、版本、时间和 SHA256；不得只按“最新”命名。
