kanuba0814/puzzle-arm/pi_puzzle/workspace/src/policy/README.md

# policy

ACT 数据契约、processor、训练配置和 Pi 推理适配；必须可完全关闭。

接口以 `docs/10_接口与数据契约.md` 和 `data_contracts/` 为准。
