kanuba0814/puzzle-arm/START_HERE.md

# START HERE

## 先读

1. `official_docs/competition/E题_拼图装置.pdf`
2. `docs/00_范围与冻结决策.md`
3. `docs/01_赛题需求追踪矩阵.md`
4. `docs/13_96小时执行计划.md`
5. `docs/19_决策门与停止条件.md`
6. `AGENTS.md`

## 首日只做五件事

- 核对五个舵机的完整标签、电压、ID 和供电；
- 固定相机、机械臂基座、A4 纸和背景；
- 完成相机内参与桌面单应标定；
- 完成五轴低速控制和安全高度动作；
- 用实物最坏磁隙验证电磁吸取和机械释放。

在单片确定性闭环稳定前，不采集 ACT 数据，不开发扑克牌纹理，不做异步推理。

## 第一个可运行里程碑

`SCAN -> 单片识别 -> 抓取点 -> 坐标转换 -> PREGRASP -> PICK -> 磁铁吸取 -> Z_SAFE -> PLACE -> 释放 -> 视觉复核`

通过条件见 `docs/19_决策门与停止条件.md` 的 Gate A。
