kanuba0814/puzzle-arm/docs/05_OpenCV视觉流水线.md

# 05 OpenCV 视觉流水线

## 目标输出

每块碎片输出：轮廓、二值掩码、桌面坐标中心、抓取点、主方向、顶点、边描述、纹理裁剪、置信度和时间戳。

## 标定

### 相机内参

- 使用棋盘格或 ChArUco。
- 保存相机矩阵、畸变系数、图像分辨率和标定日期。
- 固定焦距后不得重新自动对焦。

### 图像到桌面

- 在工作台固定四个以上标志点。
- 计算图像平面到桌面毫米坐标的单应矩阵。
- 每次上电检查标志点重投影误差，超阈值则禁止启动。

### 桌面到机械臂

- 让末端接触至少 4 个分散标定点。
- 拟合二维刚体/仿射变换；若残差存在系统性畸变，使用更多网格点做修正表。
- 独立测量电磁铁中心相对腕部旋转轴偏移。

## 采集策略

- 扫描和验证时机械臂停止并退出关键区域。
- 固定曝光、增益、白平衡。
- 使用深色、无纹理、哑光背景提高镀锌片与白纸的分割稳定性；不得依赖特殊照明。
- 采集多帧并检查画面稳定后再求解。

## 处理流程

1. 去畸变。
2. 根据标志点透视校正成统一俯视尺寸。
3. 限制 ROI 为 A4 区域。
4. 背景差分或颜色/亮度组合分割。
5. 形态学开闭运算，去除孔洞和孤立噪声。
6. 连通域和面积过滤。
7. 轮廓提取与多边形逼近。
8. 对二值掩码做距离变换，求抓取点。
9. 计算方向和边描述。
10. 输出置信度与诊断图。

## 方向估计

- `minAreaRect` 或 PCA 只作为初始方向。
- 最终方向由模板轮廓或拼图求解器确定。
- 对称碎片必须记录可等价旋转集合，避免把 180 度等价姿态当成错误。

## 视觉验收目标

- 桌面坐标重复性：静态目标 30 次标准差 <= 1 mm。
- 网格点绝对定位误差：工作区内目标 <= 3 mm。
- 碎片漏检/误检：模拟正式场景 100 帧无持续错误。
- 机械臂完全退出后再做最终放置判定。

这些数值是内部工程目标，不是题面评分阈值。
