kanuba0814/puzzle-arm/docs/13_96小时执行计划.md

# 13 96 小时执行计划

本计划按三人并行，ACT 为增强项，不允许拖慢基线。

## 0-4 小时：冻结与硬件清点

共同：

- 阅读赛题原文并冻结需求矩阵。
- 检查 SO-101 舵机标签、电压版本、ID 和供电。
- 确认相机、Pi 5、电磁铁、MOSFET、顶出结构材料。
- 固定 LeRobot v0.6.0 环境和仓库分支。

退出条件：所有硬件有实物状态，未知项列入 `BLOCKERS`。

## 4-12 小时：三条主线并行

视觉：完成相机固定、内参、A4 透视校正、单片分割和毫米坐标。

控制：完成五轴插件、setup/calibrate、低速关节测试和 HOME/Z_SAFE。

机械：完成底座、相机支架、电磁吸头、MOSFET 和释放结构。

退出条件：视觉能输出抓取点；机械臂能安全到达工作区；磁铁能吸放测试片。

## 12-24 小时：单片确定性闭环

- 完成桌面到机械臂标定。
- 完成 IK 和关键位姿轨迹。
- 完成磁铁状态机和视觉验证。
- 随机单片抓放 20 次。

硬门：成功率低于 80% 时不得进入完整拼图和 ACT，先修基础误差。

## 24-36 小时：自备 50 分功能

- 建立 4 片模板库。
- 固定放置顺序。
- 完成完整流程、结束指示、2 分钟计时。
- 完成 10 次随机全流程。

目标：自备题连续 5 次成功，时间小于 90 秒。

## 36-52 小时：现场白色 20 分功能

- 多边形简化与边描述。
- 白色碎片组合搜索。
- 碰撞、越界和外边约束。
- 制作多套模拟现场碎片。
- 完成求解器离线盲测和实机流程。

## 52-64 小时：扑克牌 30 分功能

- 边缘纹理条带提取。
- 几何候选上的纹理评分。
- 多牌面模拟测试。
- 若 6 小时内无稳定收益，冻结白色功能，不破坏已有流程。

## 36-64 小时并行增强：ACT 数据

仅在单片确定性抓放已经稳定后进行：

- 记录 local_grasp 和 local_place 小 episode。
- 先各 50 条做数据审查。
- GPU 主机短训练并检查维度、过拟合和推理。
- 不在 Pi 上训练。

## 64-74 小时：ACT 接入决策

- Pi 5 安装固定环境并跑真实输入基准。
- 测 p50/p95、内存、温度、连续运行。
- 只在性能与成功率均优于确定性控制时启用 ACT。
- 否则正式版关闭 ACT，但保留实验分支。

## 74-86 小时：系统可靠性

- 30 次以上全流程。
- 按失败类型修复，不做无目标调参。
- 电源扰动、遮挡、掉落、释放失败、重启测试。
- 锁定机械位置和相机参数。

## 86-92 小时：报告与测量数据

- 整理框图、算法、公式、测试表和照片。
- 报告中的指标必须来自测试日志。
- 完成题目规定的设计报告结构。

## 92-96 小时：冻结和备份

- 只修阻塞性问题。
- 建立正式 release tag。
- 保存离线依赖、checkpoint、标定、配置和恢复说明。
- 进行最终遮挡相机的一键完整演练。
