kanuba0814/puzzle-arm/docs/14_三人分工与交接.md

# 14 三人分工与交接（已废弃）

> **状态：DEPRECATED。** 本文件是早期组织草案，不再作为架构、接口、权限或验收依据。实际单臂控制重构见 `docs/23_单臂运动控制重构.md`；接口以 `docs/10_接口与数据契约.md` 为准。

## A：视觉与拼图算法

负责：

- 相机标定、透视校正、分割、轮廓和抓取点。
- 固定模板、白色几何求解、扑克牌纹理评分。
- 放置复核和诊断图。

交付接口：`PieceObservation[]` 和 `PlacementPlan[]`。

## B：机械臂控制与 LeRobot/ACT

负责：

- 五轴插件、标定、关节总线和安全过滤。
- IK、关键位姿、轨迹和 Supervisor 接口。
- 数据采集、ACT 训练、Pi 推理基准。

交付接口：`MotionGoal -> MotionResult`，以及稳定的五轴数据契约。

## C：机械、电气、测试和报告

负责：

- 底座、相机架、末端吸头、顶出结构。
- 电磁铁驱动、电源、声光指示、急停。
- 试片制作、重复性测试、日志汇总和报告材料。

交付接口：通过验收的硬件和测试记录。

## 集成规则

- 每 4 小时一次集成点，不进行持续口头同步替代文档。
- 模块输入输出按 `docs/10_接口与数据契约.md`。
- 任何坐标和角度必须带单位和坐标系。
- 每个人只能在自己模块内修改；跨模块修改必须由对应负责人确认。
- 主分支始终保持可运行，实验功能使用独立分支和开关。

## 每次交接必须包含

- 当前 commit；
- 启动方式；
- 已通过测试；
- 已知失败；
- 输入输出样例；
- 回退方法。
