kanuba0814/puzzle-arm/docs/15_风险登记表.md

# 15 风险登记表

| 风险 | 概率 | 影响 | 早期信号 | 处置 |
|---|---|---|---|---|
| 电磁铁隔纸吸力不足 | 中 | 高 | 抬升时滑落 | 按实物最坏有效磁隙/30 g 保守载荷试验；换小间隙磁路或更强磁头 |
| 剩磁无法释放 | 高 | 高 | 断电后碎片跟随 | 机械顶出环；低速剥离；不依赖断电 |
| SO-101 回差导致放置偏差 | 高 | 中 | 同一点从不同方向误差不同 | 固定接近方向；视觉复核；局部修正 |
| 镀锌反光分割失败 | 中 | 高 | 轮廓断裂、闪烁 | 固定曝光；哑光背景；多帧稳定；几何过滤 |
| Pi 5 ACT 推理过慢 | 中高 | 中 | p95 >500 ms、积压 | ACT 非阻塞；关闭 ACT 回退 IK |
| 五轴插件与六轴数据不一致 | 中 | 高 | checkpoint shape mismatch | 全新 ID、全新数据集、schema 测试 |
| 现场未知碎片无几何解 | 中 | 高 | 候选均越界或重叠 | 检查轮廓简化；多阈值重提取；保留原始轮廓 |
| 扑克牌纹理稀疏 | 高 | 中 | 多候选纹理分数接近 | 几何先验、边条带、全图重建评分 |
| 相机/纸张位置移动 | 中 | 高 | 标志点误差突增 | 刚性固定；启动自检；超阈值拒绝运行 |
| 舵机过流或串口断连 | 中 | 高 | 温升、掉线、Pi 重启 | 独立供电、降速、监测、自动抬升与终止 |
| 时间超 2 分钟 | 中 | 高 | 单片平均 >20 s | 并行计算；缩短安全路径；目标 90 s |
| ACT 数据质量差 | 高 | 中 | 训练损失下降但实机失败 | 逐 episode 审查；按位置划分验证；补纠正数据 |

## 风险处理原则

先修机械、电源、标定和确定性控制，再考虑用模型补偿。模型不能修复吸头无法释放、坐标系错误或供电不稳。
