kanuba0814/puzzle-arm/docs/16_设计报告提纲.md

# 16 设计报告提纲

按照题目评分项组织，不写成开发日记。

## 摘要

说明任务、总体方案、关键指标和实测结果。

## 1 方案论证

- 机械臂与其他平面机构比较。
- 电磁铁、夹爪、吸盘比较。
- 纯确定性控制、OpenCV+ACT 混合方案比较。
- 最终采用可降级架构的理由。

## 2 理论分析与计算

- 相机模型和单应变换。
- 抓取点距离变换。
- 多边形边匹配和刚体变换。
- 坐标系转换和机械臂运动学。
- 电磁吸力的最坏条件测试方法。

## 3 电路设计

- Pi、电机、电磁铁供电框图。
- MOSFET、续流和保护。
- 声光指示与急停。

## 4 程序设计

- 系统框图。
- 状态机。
- 视觉和拼图求解流程。
- 五轴 LeRobot 接口。
- ACT 的局部职责和回退路径。

## 5 测试方案与结果

至少包含：

- 视觉定位误差；
- 机械臂重复定位；
- 抓取/释放成功率；
- 放置误差；
- 各模式总时间；
- 全流程成功率；
- ACT 开启/关闭对比；
- 普通室内照明测试。

## 6 结果分析

- 主要误差来源。
- 失败类型占比。
- ACT 是否实际提高成功率。
- 系统限制和改进方向。

所有图表必须来自保存的日志和测试记录，不使用无法复现的估计值。
