kanuba0814/puzzle-arm/docs/19_决策门与停止条件.md

# 19 决策门与停止条件

## Gate A：机械闭环

进入条件：单片视觉定位可用。

通过：确定性单片抓放 20 次成功率 >= 90%，无碰撞和掉电。

未通过：停止 ACT、拼图纹理和界面工作，集中修标定、吸头和轨迹。

## Gate B：自备题

通过：连续 5 次完整拼图成功，单次 <= 90 s。

未通过：现场未知题只做离线算法，不接实机。

## Gate C：白色现场题

通过：离线白色盲测至少 20 套中 ≥18 套几何解正确，且实机连续 5 次成功。

未通过：冻结自备题版本，避免破坏已有得分。

## Gate D：ACT

通过必须同时满足：

- Pi p95 推理 <= 500 ms；
- ACT 局部技能成功率显著高于确定性基线；
- 无新增安全失败；
- 关闭 ACT 可立即回退。

否则正式版关闭 ACT。

## Gate E：扑克牌

只有白色现场题稳定后进入。若纹理模块在规定时间内没有稳定提升候选排序，停止开发，保留几何功能。

## 正式冻结

- 禁止更换相机位置、背景、机械臂基座和末端。
- 禁止升级 LeRobot、PyTorch、OpenCV。
- 只允许修复可复现阻塞问题。
