kanuba0814/puzzle-arm/docs/21_工作分解与依赖表.md

# 21 工作分解与依赖表

| ID | 工作项 | 依赖 | 负责人 | 交付物 | 通过条件 |
|---|---|---|---|---|---|
| H01 | 实物型号与供电核对 | 无 | 机械/电气 | 硬件清点记录 | 五舵机标签、电压、ID、供电均明确 |
| H02 | 电磁吸头和顶出机构 | H01 | 机械/电气 | 末端总成 | 最坏有效磁隙下 50 次吸放通过 |
| V01 | 顶置相机固定和内参 | 无 | 视觉 | 相机标定文件 | 重投影误差记录且画面参数冻结 |
| V02 | A4 单应标定 | V01 | 视觉 | table homography | 网格点绝对误差达到内部阈值 |
| V03 | 碎片分割与抓取点 | V02 | 视觉 | PieceObservation | 反光/普通照明测试通过 |
| C01 | 五轴 LeRobot 插件 | H01 | 控制 | robot plugin | setup/calibrate/read/write 通过 |
| C02 | IK 与安全高度轨迹 | C01 | 控制 | MotionGoal 执行器 | 20 网格点无碰撞可达 |
| I01 | 桌面到机械臂标定 | V02,C02 | 集成 | 坐标转换 | 单片到达误差达到内部阈值 |
| I02 | 单片确定性闭环 | V03,H02,I01 | 集成 | 单片抓放流程 | Gate A 通过 |
| P01 | 自备模板求解 | V03 | 视觉/拼图 | 固定 PlacementPlan | 身份与姿态盲测通过 |
| I03 | 自备完整拼图 | I02,P01 | 集成 | 50 分基线 | Gate B 通过 |
| P02 | 现场白色几何求解 | V03 | 拼图 | 通用几何 Solver | Gate C 离线部分通过 |
| I04 | 现场白色实机 | I03,P02 | 集成 | 20 分增强 | Gate C 实机部分通过 |
| P03 | 扑克牌纹理排序 | P02 | 拼图 | texture scorer | 独立候选排序显著优于几何并列 |
| A01 | 五轴数据契约与录制 | I02,C01 | ACT | 数据集样例 | 维度、键名、时间戳审查通过 |
| A02 | ACT 局部抓取训练 | A01 | ACT | grasp checkpoint | 未见位置测试优于基线或停止 |
| A03 | Pi 5 推理基准 | A02 | ACT | benchmark log | Gate D 性能条件通过 |
| A04 | ACT 局部接入 | A03,I03 | 集成 | 可开关增强 | Gate D 全部条件通过 |
| R01 | 设计报告数据闭环 | 各测试 | 报告 | 报告和附件 | 每个数字可追溯到日志 |

工作项状态只能是：`BLOCKED / READY / ACTIVE / VERIFY / DONE / DROPPED`。
