kanuba0814/puzzle-arm/templates/daily_status.md

# 每次集成状态

- 时间：
- 当前正式 commit：
- 可运行主流程：
- 已通过测试：
- 新增失败：
- BLOCKERS：
- 下一集成点前任务：
- 当前正式版 ACT：关闭 / 开启
- 回退 commit：
