kanuba0814/puzzle-arm/templates/task_card.md

# 任务卡

- Task ID：
- 负责人：
- 状态：BLOCKED / READY / ACTIVE / VERIFY / DONE / DROPPED
- 依赖：
- 输入接口：
- 输出接口：
- 完成定义：
- 测试方法：
- 风险与回退：
- 交付 commit：
