kanuba0814/puzzle-arm/.pi-subagents/artifacts/7c42e291-eeb7-4892-bdd2-599057441e4f_reviewer_output.md

## Review

- **Correct:** Multi-piece solving uses original measured polygons before applying translation-only spacing (`workspace/src/integration/_adapter_123.py:225-236`, `workspace/src/puzzle/solver.py:694-708`). The layout then independently verifies Euclidean pair clearance, centering, and bounds (`workspace/src/puzzle/discrete_layout.py:330-365`). Deterministic synthetic tests pass, and no new third-party dependency was added.
- **Blocker (high):** The required 5 mm minimum is configurable below 5 mm. `PuzzleOptions` and the live CLI accept any nonnegative value (`workspace/src/puzzle/solver.py:82-90`, `workspace/tools/live_detect_123.py:68-71,121-123`), while `workspace/tests/test_discrete_layout.py:117-126` explicitly approves a zero-gap layout. Reproduction returned `SOLVED` with `minimum_pair_clearance_mm=0.0`. This violates “every final polygon pair must have at least 5 mm clearance.”
- **Blocker (high):** Single-piece solutions bypass `plan_discrete_layout` (`workspace/src/puzzle/solver.py:756-759`) and merely place the supplied reference center at the TargetRegion center (`workspace/src/puzzle/solver.py:395-415`). They neither validate final polygon bounds nor center the polygon bounding box. A 100×60 piece in a 50×50 target returned `SOLVED`; the existing test’s off-center source `(20,20)` at `workspace/tests/test_puzzle_solver_synthetic.py:57-64` would also produce a final polygon centered at `(135,84)`, not TargetRegion center `(105,74)`.
- **Blocker (high):** The adapter is incompatible with its own observation type. It constructs `PieceObservation` using `pick_point_table_mm` (`workspace/src/integration/_adapter_123.py:163-170`) but later reads `grip_point_table_mm` and directly accesses it (`workspace/src/integration/_adapter_123.py:308,334-336`). Passing that produced observation to `solve_puzzle_123` raises `AttributeError` instead of preserving grip semantics or failing closed. The synthetic adapter test masks this by defining a different `grip_point_table_mm` field and leaving it `None` (`workspace/tools/test_adapter_123.py:37-63`).
- **Note (medium):** The claimed original measured-geometry regression is not attested by scoped tests. `workspace/tools/test_adapter_123.py:81-85` generates synthetic guillotine pieces only; no captured measured polygon fixture or non-centroid grip case is exercised.

No files were edited and no Pi/hardware access occurred.
