kanuba0814/puzzle-arm/.pi-subagents/artifacts/81422c7e-860a-4881-9f82-22977616a825_batch-grill-me_1_input.md

# Task for batch-grill-me

基于当前项目目标，产出设计“wrist_roll 末端姿态锁死运动框架”前必须向现场操作者确认的高价值问题。背景：五轴 SO101，wrist_roll 为 ID5 单圈 STS3215，末端磁吸，当前 FK yaw=pan+wrist_roll 但实测 roll 物理方向与 FK 假设相反；用户要‘末端姿态锁死’，可能涉及整段路径恒定 yaw/pitch、抓取最后30mm垂直。问题需按：锁什么姿态、何时锁、允许的等价角/绕线、电缆/机械限位、安全失败语义、速度/精度、测试验收 分类；优先提供可选项而非泛泛提问。不要改文件，不要执行硬件。

## Acceptance Contract
Acceptance level: attested
Completion is not accepted from prose alone. End with a structured acceptance report.

Criteria:
- criterion-1: Return a concise result and residual risks when applicable

Required evidence: manual-notes, residual-risks

Finish with a fenced JSON block tagged `acceptance-report` in this shape:
Use empty arrays when no items apply; array fields contain strings unless object entries are shown.
`criteriaSatisfied[].status` must be exactly one of: satisfied, not-satisfied, not-applicable.
`commandsRun[].result` must be exactly one of: passed, failed, not-run.
`manualNotes` and `notes` are optional strings; an empty string means no note and does not satisfy `manual-notes` evidence.
```acceptance-report
{
  "criteriaSatisfied": [
    {
      "id": "criterion-1",
      "status": "satisfied",
      "evidence": "specific proof"
    }
  ],
  "changedFiles": [
    "src/file.ts"
  ],
  "testsAddedOrUpdated": [
    "test/file.test.ts"
  ],
  "commandsRun": [
    {
      "command": "command",
      "result": "passed",
      "summary": "short result"
    }
  ],
  "validationOutput": [
    "validation output or concise summary"
  ],
  "residualRisks": [
    "none"
  ],
  "noStagedFiles": true,
  "diffSummary": "short description of the diff",
  "reviewFindings": [
    "blocker: file.ts:12 - issue found, or no blockers"
  ],
  "manualNotes": "anything else the parent should know"
}
```
