kanuba0814/puzzle-arm/.pi-subagents/artifacts/81422c7e-860a-4881-9f82-22977616a825_researcher_0_input.md

# Task for researcher

研究“5 自由度 SO-101 类机械臂的 wrist_roll/末端 yaw 姿态锁死运动框架”，只使用高可信一手来源（官方文档、标准、官方 GitHub 源码/论文作者仓库）。重点调查：1) 任务空间姿态约束/Cartesian path；2) SO(3)/SE(3) 插值与角度解包；3) 连续/单圈 revolute joint 的 winding 与反馈误差；4) differential IK / Jacobian 伺服与奇异性；5) constrained planning；6) 时间参数化（Ruckig 等）；7) 如何在资源有限的 Raspberry Pi 上做确定性轻量实现。必须明确哪些算法适用于本项目 5DoF 平面模型，哪些不适用；列出 MoveIt、OMPL、Pinocchio、Drake、Ruckig、ROS angles/joint trajectory controller 等一手链接和关键接口。将中文研究报告写入 /home/gxxl/nudec-re101/docs/research/wrist_roll_pose_lock_open_source.md，避免改其他文件。不要执行硬件、SSH 或任何运动命令。

---
Update progress at: /home/gxxl/nudec-re101/.pi-subagents/artifacts/progress/81422c7e-860a-4881-9f82-22977616a825/progress.md

---
**Output:**
Write your findings to exactly this path: /home/gxxl/nudec-re101/.pi-subagents/artifacts/outputs/81422c7e-860a-4881-9f82-22977616a825/docs/research/wrist_roll_pose_lock_open_source.md
This path is authoritative for this run.
Ignore any other output filename or output path mentioned elsewhere, including output destinations in the base agent prompt, system prompt, or task instructions.

## Acceptance Contract
Acceptance level: checked
Completion is not accepted from prose alone. End with a structured acceptance report.

Criteria:
- criterion-1: Return concrete findings with file paths and severity when applicable

Required evidence: changed-files, tests-added, commands-run, residual-risks, no-staged-files

Finish with a fenced JSON block tagged `acceptance-report` in this shape:
Use empty arrays when no items apply; array fields contain strings unless object entries are shown.
`criteriaSatisfied[].status` must be exactly one of: satisfied, not-satisfied, not-applicable.
`commandsRun[].result` must be exactly one of: passed, failed, not-run.
`manualNotes` and `notes` are optional strings; an empty string means no note and does not satisfy `manual-notes` evidence.
```acceptance-report
{
  "criteriaSatisfied": [
    {
      "id": "criterion-1",
      "status": "satisfied",
      "evidence": "specific proof"
    }
  ],
  "changedFiles": [
    "src/file.ts"
  ],
  "testsAddedOrUpdated": [
    "test/file.test.ts"
  ],
  "commandsRun": [
    {
      "command": "command",
      "result": "passed",
      "summary": "short result"
    }
  ],
  "validationOutput": [
    "validation output or concise summary"
  ],
  "residualRisks": [
    "none"
  ],
  "noStagedFiles": true,
  "diffSummary": "short description of the diff",
  "reviewFindings": [
    "blocker: file.ts:12 - issue found, or no blockers"
  ],
  "manualNotes": "anything else the parent should know"
}
```
