kanuba0814/puzzle-arm/.pi-subagents/artifacts/90ba758b-ad78-4d34-9417-3f001897be1d_advisor_input.md

# Task for advisor

只读独立审计当前工作区的机械臂启动及单片 grasp_fsm 运动路径。用户反馈“慢且卡、启动冗余动作”。不要改文件、不要 SSH/Pi/硬件。基于 workspace/src/control/motion_controller.py、workspace/src/integration/park_sequence.py、workspace/src/integration/supervisor.py、workspace/tools/run_assembly_4pieces.py 与 2026-08-01 evidence 日志，回答：1) 可量化的卡顿根因；2) 哪些启动/路径动作可安全合并或删除，哪些是硬约束不能删；3) 推荐最小安全改动与验收指标。给出文件/行或符号证据，特别警惕不能绕过 PICK/PLACE、安全高度、PARK 和真实读回门禁。

---
**Output:**
Write your findings to exactly this path: /home/gxxl/nudec-re101/.pi-subagents/artifacts/outputs/90ba758b-ad78-4d34-9417-3f001897be1d/.pi-subagents/advisor-motion-analysis.md
This path is authoritative for this run.
Ignore any other output filename or output path mentioned elsewhere, including output destinations in the base agent prompt, system prompt, or task instructions.

## Acceptance Contract
Acceptance level: attested
Completion is not accepted from prose alone. End with a structured acceptance report.

Criteria:
- criterion-1: Return concrete findings with file paths and severity when applicable

Required evidence: review-findings, residual-risks

Finish with a fenced JSON block tagged `acceptance-report` in this shape:
Use empty arrays when no items apply; array fields contain strings unless object entries are shown.
`criteriaSatisfied[].status` must be exactly one of: satisfied, not-satisfied, not-applicable.
`commandsRun[].result` must be exactly one of: passed, failed, not-run.
`manualNotes` and `notes` are optional strings; an empty string means no note and does not satisfy `manual-notes` evidence.
```acceptance-report
{
  "criteriaSatisfied": [
    {
      "id": "criterion-1",
      "status": "satisfied",
      "evidence": "specific proof"
    }
  ],
  "changedFiles": [
    "src/file.ts"
  ],
  "testsAddedOrUpdated": [
    "test/file.test.ts"
  ],
  "commandsRun": [
    {
      "command": "command",
      "result": "passed",
      "summary": "short result"
    }
  ],
  "validationOutput": [
    "validation output or concise summary"
  ],
  "residualRisks": [
    "none"
  ],
  "noStagedFiles": true,
  "diffSummary": "short description of the diff",
  "reviewFindings": [
    "blocker: file.ts:12 - issue found, or no blockers"
  ],
  "manualNotes": "anything else the parent should know"
}
```
