kanuba0814/puzzle-arm/.pi-subagents/artifacts/b7cad63c-7dab-442c-9ad9-4758163a85cd_reviewer_input.md

# Task for reviewer

对当前机械臂“慢、卡、启动冗余动作”做只读安全审计。不得修改任何文件；不得 SSH、同步或访问 Pi，禁止任何硬件动作。阅读 workspace/src/control/motion_controller.py、workspace/src/integration/park_sequence.py、workspace/src/integration/runtime_adapter.py、workspace/src/integration/supervisor.py、workspace/tools/run_assembly_4pieces.py，以及 2026-08-01 evidence 日志。核验先前建议：PARK 步进 1°→4°、transit_cartesian_step_mm=25、删除每片 1 秒 sleep、收紧 5°/30s 诊断参数。请按“安全可做 / 不该做 / 证据与验证”输出，给出文件与符号引用。

---
**Output:**
Write your findings to exactly this path: /home/gxxl/nudec-re101/.pi-subagents/artifacts/outputs/b7cad63c-7dab-442c-9ad9-4758163a85cd/.pi-subagents/gpt56-sol-motion-audit.md
This path is authoritative for this run.
Ignore any other output filename or output path mentioned elsewhere, including output destinations in the base agent prompt, system prompt, or task instructions.

## Acceptance Contract
Acceptance level: attested
Completion is not accepted from prose alone. End with a structured acceptance report.

Criteria:
- criterion-1: Return concrete findings with file paths and severity when applicable

Required evidence: review-findings, residual-risks

Finish with a fenced JSON block tagged `acceptance-report` in this shape:
Use empty arrays when no items apply; array fields contain strings unless object entries are shown.
`criteriaSatisfied[].status` must be exactly one of: satisfied, not-satisfied, not-applicable.
`commandsRun[].result` must be exactly one of: passed, failed, not-run.
`manualNotes` and `notes` are optional strings; an empty string means no note and does not satisfy `manual-notes` evidence.
```acceptance-report
{
  "criteriaSatisfied": [
    {
      "id": "criterion-1",
      "status": "satisfied",
      "evidence": "specific proof"
    }
  ],
  "changedFiles": [
    "src/file.ts"
  ],
  "testsAddedOrUpdated": [
    "test/file.test.ts"
  ],
  "commandsRun": [
    {
      "command": "command",
      "result": "passed",
      "summary": "short result"
    }
  ],
  "validationOutput": [
    "validation output or concise summary"
  ],
  "residualRisks": [
    "none"
  ],
  "noStagedFiles": true,
  "diffSummary": "short description of the diff",
  "reviewFindings": [
    "blocker: file.ts:12 - issue found, or no blockers"
  ],
  "manualNotes": "anything else the parent should know"
}
```
