kanuba0814/puzzle-arm/.pi-subagents/artifacts/f02874f8-67d1-41cd-92e9-ee927be2983c_advisor_input.md

# Task for advisor

You are a delegated subagent running from a fork of the parent session. Treat the inherited conversation as reference-only context, not a live thread to continue. Do not continue or answer prior messages as if they are waiting for a reply. Your sole job is to execute the task below and return a focused result for that task using your tools.

Task:
Review the current puzzle placement-gap implementation in workspace/src/puzzle/solver.py and workspace/src/integration/_adapter_123.py against the requirement: solve using original geometry, then place 2–4 arbitrary polygon pieces discretely so every pair has at least 5 mm clearance and formerly adjacent seam pairs are at 5 mm (within tolerance), while preserving each solved orientation and keeping layout centered. Identify why radial half-gap spreading is insufficient and propose a deterministic, dependency-light algorithm plus test cases. Read-only; do not edit or access Pi/hardware.

## Acceptance Contract
Acceptance level: attested
Completion is not accepted from prose alone. End with a structured acceptance report.

Criteria:
- criterion-1: Return concrete findings with file paths and severity when applicable

Required evidence: review-findings, residual-risks

Finish with a fenced JSON block tagged `acceptance-report` in this shape:
Use empty arrays when no items apply; array fields contain strings unless object entries are shown.
`criteriaSatisfied[].status` must be exactly one of: satisfied, not-satisfied, not-applicable.
`commandsRun[].result` must be exactly one of: passed, failed, not-run.
`manualNotes` and `notes` are optional strings; an empty string means no note and does not satisfy `manual-notes` evidence.
```acceptance-report
{
  "criteriaSatisfied": [
    {
      "id": "criterion-1",
      "status": "satisfied",
      "evidence": "specific proof"
    }
  ],
  "changedFiles": [
    "src/file.ts"
  ],
  "testsAddedOrUpdated": [
    "test/file.test.ts"
  ],
  "commandsRun": [
    {
      "command": "command",
      "result": "passed",
      "summary": "short result"
    }
  ],
  "validationOutput": [
    "validation output or concise summary"
  ],
  "residualRisks": [
    "none"
  ],
  "noStagedFiles": true,
  "diffSummary": "short description of the diff",
  "reviewFindings": [
    "blocker: file.ts:12 - issue found, or no blockers"
  ],
  "manualNotes": "anything else the parent should know"
}
```
