kanuba0814/puzzle-arm/.pi-subagents/artifacts/46661215-9dc5-4cd4-a78a-cd7b05b59a30_advisor_1_input.md

# Task for advisor

[Read from: /home/gxxl/nudec-re101/.taskman/plans/adopt-puzzle-vision-v2-2/PLAN.md, /home/gxxl/nudec-re101/.taskman/plans/adopt-puzzle-vision-v2-2/context.md, /home/gxxl/nudec-re101/docs/05_OpenCV视觉流水线.md, /home/gxxl/nudec-re101/docs/06_拼图求解器.md, /home/gxxl/nudec-re101/docs/10_接口与数据契约.md, /home/gxxl/nudec-re101/docs/19_决策门与停止条件.md, /home/gxxl/nudec-re101/configs/parameter_registry.yaml]

Perform a read-only architecture and algorithm feasibility critique of .taskman/plans/adopt-puzzle-vision-v2-2/PLAN.md and context.md. Focus on deep-module seams, coordinate/frame correctness, robust rounded-corner detection, complete/partial-edge enumeration without cut_mode, target rectangle inference under official dimensions, ambiguity/confidence calibration, texture seam scoring, combinatorial performance on Raspberry Pi 5, and staged safe integration. Identify any technically unsound acceptance criteria, missing preconditions, or places where implementation agents could misinterpret the plan. Give exact amendments. Do not edit files.

---
**Output:**
Write your findings to exactly this path: /home/gxxl/nudec-re101/.pi-subagents/artifacts/outputs/46661215-9dc5-4cd4-a78a-cd7b05b59a30/architecture-critique.md
This path is authoritative for this run.
Ignore any other output filename or output path mentioned elsewhere, including output destinations in the base agent prompt, system prompt, or task instructions.

## Acceptance Contract
Acceptance level: attested
Completion is not accepted from prose alone. End with a structured acceptance report.

Criteria:
- criterion-1: Return concrete findings with file paths and severity when applicable

Required evidence: review-findings, residual-risks

Finish with a fenced JSON block tagged `acceptance-report` in this shape:
Use empty arrays when no items apply; array fields contain strings unless object entries are shown.
`criteriaSatisfied[].status` must be exactly one of: satisfied, not-satisfied, not-applicable.
`commandsRun[].result` must be exactly one of: passed, failed, not-run.
`manualNotes` and `notes` are optional strings; an empty string means no note and does not satisfy `manual-notes` evidence.
```acceptance-report
{
  "criteriaSatisfied": [
    {
      "id": "criterion-1",
      "status": "satisfied",
      "evidence": "specific proof"
    }
  ],
  "changedFiles": [
    "src/file.ts"
  ],
  "testsAddedOrUpdated": [
    "test/file.test.ts"
  ],
  "commandsRun": [
    {
      "command": "command",
      "result": "passed",
      "summary": "short result"
    }
  ],
  "validationOutput": [
    "validation output or concise summary"
  ],
  "residualRisks": [
    "none"
  ],
  "noStagedFiles": true,
  "diffSummary": "short description of the diff",
  "reviewFindings": [
    "blocker: file.ts:12 - issue found, or no blockers"
  ],
  "manualNotes": "anything else the parent should know"
}
```
