kanuba0814/puzzle-arm/.pi-subagents/artifacts/487261f7-db3d-49b5-84ac-155c02aaf614_worker_0_input.md

# Task for worker

[Read from: /tmp/nudec-re101-terra-workers/algorithm/context.md, /tmp/nudec-re101-terra-workers/algorithm/plan.md]

你是主要算法代码执行者。请直接在当前隔离副本实现 `.taskman/plans/adopt-puzzle-vision-v2-2/PLAN.md` 与 `context.md` 中当前能够软件完成的 Phase 0–3，并以根目录 `IMPLEMENTATION_CONTEXT.md` 为代码级合同。目标是高质量、可维护、深模块实现，不是空壳：保留现有红色检测行为；实现通用 `vision.observe_pieces`（物理轮廓、虚拟几何、多阈值稳定分割、显式拒绝、圆角 profile 门、最大净空抓取点及 typed diagnostics）；实现 `puzzle.solve_puzzle` 的 1–4 片确定性几何求解、SE(2) 正旋转、完整/部分边候选、目标矩形推断、统一 penalty、等价/歧义/预算；更新严格 JSON Schema、registry、文档；加入固定种子原创合成夹具、红色回放及足够的算法/契约测试和离线分析工具。不得复制外部仓源码/素材；不得修改 control/robot_plugin/policy/apps；generic/texture 默认关闭，UNKNOWN 不捏造。开发机 base 无 cv2，可用 `export PATH=/home/gxxl/miniconda3/bin:$PATH && conda run -n yolo ...` 验证视觉。不要启动子代理。完成后运行 ruff、compileall、适用 unittest，并报告：改动文件、验收证据、未通过 Gate、残余风险。

---
Update progress at: /home/gxxl/nudec-re101/.pi-subagents/artifacts/progress/487261f7-db3d-49b5-84ac-155c02aaf614/progress.md

---
**Output:**
Write your findings to exactly this path: /tmp/nudec-re101-terra-workers/algorithm/HANDOFF.md
This path is authoritative for this run.
Ignore any other output filename or output path mentioned elsewhere, including output destinations in the base agent prompt, system prompt, or task instructions.

## Acceptance Contract
Acceptance level: checked
Completion is not accepted from prose alone. End with a structured acceptance report.

Criteria:
- criterion-1: Implement the requested change without widening scope
- criterion-2: Return evidence sufficient for an independent acceptance review

Required evidence: changed-files, tests-added, commands-run, residual-risks, no-staged-files

Review gate: required by reviewer.

Finish with a fenced JSON block tagged `acceptance-report` in this shape:
Use empty arrays when no items apply; array fields contain strings unless object entries are shown.
`criteriaSatisfied[].status` must be exactly one of: satisfied, not-satisfied, not-applicable.
`commandsRun[].result` must be exactly one of: passed, failed, not-run.
`manualNotes` and `notes` are optional strings; an empty string means no note and does not satisfy `manual-notes` evidence.
```acceptance-report
{
  "criteriaSatisfied": [
    {
      "id": "criterion-1",
      "status": "satisfied",
      "evidence": "specific proof"
    },
    {
      "id": "criterion-2",
      "status": "satisfied",
      "evidence": "specific proof"
    }
  ],
  "changedFiles": [
    "src/file.ts"
  ],
  "testsAddedOrUpdated": [
    "test/file.test.ts"
  ],
  "commandsRun": [
    {
      "command": "command",
      "result": "passed",
      "summary": "short result"
    }
  ],
  "validationOutput": [
    "validation output or concise summary"
  ],
  "residualRisks": [
    "none"
  ],
  "noStagedFiles": true,
  "diffSummary": "short description of the diff",
  "reviewFindings": [
    "blocker: file.ts:12 - issue found, or no blockers"
  ],
  "manualNotes": "anything else the parent should know"
}
```
