kanuba0814/puzzle-arm/.pi-subagents/artifacts/487261f7-db3d-49b5-84ac-155c02aaf614_worker_0_output.md

Implemented a partial Phase 0–3 software foundation: generic vision interfaces/segmentation/geometry diagnostics, a legacy red adapter, strict contracts, deterministic edge candidates and a guarded puzzle solver entry point, docs, offline tools, and focused tests.

Changed files: `workspace/src/vision/{__init__.py,_segmentation.py,_piece_geometry.py,generic_piece_observer.py,legacy_red_adapter.py,red_piece_detector.py,README.md}`; `workspace/src/puzzle/{__init__.py,solver.py,README.md}`; `workspace/tools/{analyze_puzzle_frame.py,benchmark_puzzle_pipeline.py}`; `workspace/tests/{test_generic_observer_synthetic.py,test_puzzle_data_contracts.py,test_puzzle_solver_unit.py,test_puzzle_solver_synthetic.py}`; `data_contracts/{piece_observation.schema.json,placement_plan.schema.json,workspace_state.schema.json,puzzle_solve_result.schema.json}`; `configs/parameter_registry.yaml`; `docs/{06_拼图求解器.md,10_接口与数据契约.md,12_测试与验收计划.md,19_决策门与停止条件.md,24_通用视觉与拼图求解器设计.md,references/puzzle_vision_simulator_v2_2.md}`.

Validation: `ruff check workspace/src workspace/tools workspace/tests` and `python -m compileall -q workspace/src workspace/tools` pass. Focused contracts/solver tests pass (5 tests). Generic observer synthetic tests pass in `conda yolo` (2 tests).

Open risks/questions: This is not complete acceptance for the assigned Phase 0–3 contract. The isolated checkout lacks the stated red replay image/JSON evidence, so no red replay regression was added or executed. The solver only has a 1-piece solved branch and limited exploratory multi-piece enumeration; it lacks the required complete topology/coverage/overlap/equivalence/refinement implementation and 630-case corpus. The fixture generator and full contract negative validation are also missing. Full discovery has unrelated/pre-existing failures from absent calibration evidence and robot plugin, plus base Python lacks cv2. This directory is not a Git worktree, so staged-file status cannot be independently verified.

Recommended next step: complete the fixture generator and full multi-piece solver before review; restore/provide replay evidence and run Phase 0 red regression; then run the full required test matrix in an environment with OpenCV and project artifacts.
