kanuba0814/puzzle-arm/.pi-subagents/artifacts/487261f7-db3d-49b5-84ac-155c02aaf614_worker_1_input.md

# Task for worker

[Read from: /tmp/nudec-re101-terra-workers/supervisor/context.md, /tmp/nudec-re101-terra-workers/supervisor/plan.md]

你是主要 Supervisor/机器人集成代码执行者。请直接在当前隔离副本按根目录 `IMPLEMENTATION_CONTEXT.md`、计划文档和现有控制基线，实现 production integration 深模块及测试。必须包括：SupervisorConfig/State/ErrorCode/Result；唯一状态切换；严格 fail-closed 抓放门禁；视觉/计划时效；JSONL runtime events；PARK↔HOME 关节空间安全 mover；全排列最短巡检 planner；整段发送前 IK 预检；快速 sweep 采用首点 60→20mm、随后 20mm 连续经过所有块、末点升60并回 HOME/PARK（不要每点升降），每中心 actual readback 记录，磁铁恒关；shadow plan seam；未来磁吸 FSM 接口但 PICK/PLACE UNKNOWN 时绝不 set_enabled(True)；急停/恢复。实现 `workspace/tools/supervisor_run.py` 薄 CLI 并保留 legacy 工具。不可修改 control/robot_plugin/磁铁上限/GPIO17。用 FakeRobot/ManualClock 写完整测试，验证 n≤4 最短路、全段预检零动作、时效、门禁、事件单调、恢复。不要启动子代理。完成后跑 ruff/compileall/unittest并报告改动和残余实机 Gate。

---
Update progress at: /home/gxxl/nudec-re101/.pi-subagents/artifacts/progress/487261f7-db3d-49b5-84ac-155c02aaf614/progress.md

---
**Output:**
Write your findings to exactly this path: /tmp/nudec-re101-terra-workers/supervisor/HANDOFF.md
This path is authoritative for this run.
Ignore any other output filename or output path mentioned elsewhere, including output destinations in the base agent prompt, system prompt, or task instructions.

## Acceptance Contract
Acceptance level: checked
Completion is not accepted from prose alone. End with a structured acceptance report.

Criteria:
- criterion-1: Implement the requested change without widening scope
- criterion-2: Return evidence sufficient for an independent acceptance review

Required evidence: changed-files, tests-added, commands-run, residual-risks, no-staged-files

Review gate: required by reviewer.

Finish with a fenced JSON block tagged `acceptance-report` in this shape:
Use empty arrays when no items apply; array fields contain strings unless object entries are shown.
`criteriaSatisfied[].status` must be exactly one of: satisfied, not-satisfied, not-applicable.
`commandsRun[].result` must be exactly one of: passed, failed, not-run.
`manualNotes` and `notes` are optional strings; an empty string means no note and does not satisfy `manual-notes` evidence.
```acceptance-report
{
  "criteriaSatisfied": [
    {
      "id": "criterion-1",
      "status": "satisfied",
      "evidence": "specific proof"
    },
    {
      "id": "criterion-2",
      "status": "satisfied",
      "evidence": "specific proof"
    }
  ],
  "changedFiles": [
    "src/file.ts"
  ],
  "testsAddedOrUpdated": [
    "test/file.test.ts"
  ],
  "commandsRun": [
    {
      "command": "command",
      "result": "passed",
      "summary": "short result"
    }
  ],
  "validationOutput": [
    "validation output or concise summary"
  ],
  "residualRisks": [
    "none"
  ],
  "noStagedFiles": true,
  "diffSummary": "short description of the diff",
  "reviewFindings": [
    "blocker: file.ts:12 - issue found, or no blockers"
  ],
  "manualNotes": "anything else the parent should know"
}
```
