kanuba0814/puzzle-arm/.pi-subagents/artifacts/487261f7-db3d-49b5-84ac-155c02aaf614_worker_2_input.md

# Task for worker

[Read from: /tmp/nudec-re101-terra-workers/gui/context.md, /tmp/nudec-re101-terra-workers/gui/plan.md]

你是正式赛场 GUI 的专项实现者。请直接在当前隔离副本，依据根目录 `IMPLEMENTATION_CONTEXT.md`、当前 `workspace/apps/pick_place_page.py`、fb0/evdev helper 和计划文档，设计并实现一整套优秀、稳重、1024×600 的中文 7 英寸触屏界面。要求：不花哨但像正式设备；常驻顶栏状态色块+全局急停；首页、运行页、诊断页三页且信息不拥挤；显式 PageState（IDLE/RUNNING/FAULT/ESTOP）；结构化 result/status JSON 驱动，不解析 stdout 最后一行；运行中置灰动作；超时/耗时/进度；高亮选中碎片与中心/角度；快速最短巡检入口；红色基线入口；通用拼图 shadow 入口；PICK/PLACE UNKNOWN 时正式抓放按钮隐藏或锁定且解释清楚；急停无 sudo/systemctl，ESTOP 锁存和明确复位；页面自身不常驻串口/GPIO；中文字体缺失上屏报错；保留离屏 `--screenshot`。GUI 应调用未来 `workspace/tools/supervisor_run.py`，若暂不存在需定义清晰命令/结果文件合同并用测试 fake。新增 headless 截图、布局、按钮状态、结果 JSON、急停、触摸测试。不要改 control/robot_plugin/puzzle算法，不启动子代理。完成后跑可用 GUI 测试、ruff、compileall，并产出截图到 `/tmp/nudec-re101-terra-workers/gui/gui-preview.png`。

---
Update progress at: /home/gxxl/nudec-re101/.pi-subagents/artifacts/progress/487261f7-db3d-49b5-84ac-155c02aaf614/progress.md

---
**Output:**
Write your findings to exactly this path: /tmp/nudec-re101-terra-workers/gui/HANDOFF.md
This path is authoritative for this run.
Ignore any other output filename or output path mentioned elsewhere, including output destinations in the base agent prompt, system prompt, or task instructions.

## Acceptance Contract
Acceptance level: checked
Completion is not accepted from prose alone. End with a structured acceptance report.

Criteria:
- criterion-1: Implement the requested change without widening scope
- criterion-2: Return evidence sufficient for an independent acceptance review

Required evidence: changed-files, tests-added, commands-run, residual-risks, no-staged-files

Review gate: required by reviewer.

Finish with a fenced JSON block tagged `acceptance-report` in this shape:
Use empty arrays when no items apply; array fields contain strings unless object entries are shown.
`criteriaSatisfied[].status` must be exactly one of: satisfied, not-satisfied, not-applicable.
`commandsRun[].result` must be exactly one of: passed, failed, not-run.
`manualNotes` and `notes` are optional strings; an empty string means no note and does not satisfy `manual-notes` evidence.
```acceptance-report
{
  "criteriaSatisfied": [
    {
      "id": "criterion-1",
      "status": "satisfied",
      "evidence": "specific proof"
    },
    {
      "id": "criterion-2",
      "status": "satisfied",
      "evidence": "specific proof"
    }
  ],
  "changedFiles": [
    "src/file.ts"
  ],
  "testsAddedOrUpdated": [
    "test/file.test.ts"
  ],
  "commandsRun": [
    {
      "command": "command",
      "result": "passed",
      "summary": "short result"
    }
  ],
  "validationOutput": [
    "validation output or concise summary"
  ],
  "residualRisks": [
    "none"
  ],
  "noStagedFiles": true,
  "diffSummary": "short description of the diff",
  "reviewFindings": [
    "blocker: file.ts:12 - issue found, or no blockers"
  ],
  "manualNotes": "anything else the parent should know"
}
```
