kanuba0814/puzzle-arm/.pi-subagents/artifacts/487261f7-db3d-49b5-84ac-155c02aaf614_worker_3_input.md

# Task for worker

[Read from: /tmp/nudec-re101-terra-workers/deploy/context.md, /tmp/nudec-re101-terra-workers/deploy/plan.md]

你是部署/运维代码执行者。请直接在当前隔离副本，依据根目录 `IMPLEMENTATION_CONTEXT.md` 和计划文档，修复赛场交付中会导致静默失败的部署代码，但不要构建/刷写镜像、不要 SSH。范围：新增安全的 `epuzzle-gui.service` 并接入 target；让 supervisor unit 对未来 canonical entrypoint 一致；完善 start script 与服务权限，不用 sudo；修正 selfcheck/preflight 对当前冻结标定文件名、版本与 feature-gate 的检查，不能通过删除检查或把 UNKNOWN 假装成实测来变绿；在 arm64 requirements/README 中冻结 pygame/GUI 依赖的可重复方案（若不能确认 wheel 可用则保留明确 build/target import Gate，不造假）；更新部署文档和离线回退说明；为 shell/unit/selfcheck 加能在开发机运行的静态/单元测试。不得碰算法/control/robot_plugin/apps页面实现，不得启用磁铁、不执行远程副作用。不要启动子代理。完成后跑 shellcheck可用替代、ruff/compileall/测试，并报告哪些仍需 Pi 实机验证。

---
Update progress at: /home/gxxl/nudec-re101/.pi-subagents/artifacts/progress/487261f7-db3d-49b5-84ac-155c02aaf614/progress.md

---
**Output:**
Write your findings to exactly this path: /tmp/nudec-re101-terra-workers/deploy/HANDOFF.md
This path is authoritative for this run.
Ignore any other output filename or output path mentioned elsewhere, including output destinations in the base agent prompt, system prompt, or task instructions.

## Acceptance Contract
Acceptance level: checked
Completion is not accepted from prose alone. End with a structured acceptance report.

Criteria:
- criterion-1: Implement the requested change without widening scope
- criterion-2: Return evidence sufficient for an independent acceptance review

Required evidence: changed-files, tests-added, commands-run, residual-risks, no-staged-files

Review gate: required by reviewer.

Finish with a fenced JSON block tagged `acceptance-report` in this shape:
Use empty arrays when no items apply; array fields contain strings unless object entries are shown.
`criteriaSatisfied[].status` must be exactly one of: satisfied, not-satisfied, not-applicable.
`commandsRun[].result` must be exactly one of: passed, failed, not-run.
`manualNotes` and `notes` are optional strings; an empty string means no note and does not satisfy `manual-notes` evidence.
```acceptance-report
{
  "criteriaSatisfied": [
    {
      "id": "criterion-1",
      "status": "satisfied",
      "evidence": "specific proof"
    },
    {
      "id": "criterion-2",
      "status": "satisfied",
      "evidence": "specific proof"
    }
  ],
  "changedFiles": [
    "src/file.ts"
  ],
  "testsAddedOrUpdated": [
    "test/file.test.ts"
  ],
  "commandsRun": [
    {
      "command": "command",
      "result": "passed",
      "summary": "short result"
    }
  ],
  "validationOutput": [
    "validation output or concise summary"
  ],
  "residualRisks": [
    "none"
  ],
  "noStagedFiles": true,
  "diffSummary": "short description of the diff",
  "reviewFindings": [
    "blocker: file.ts:12 - issue found, or no blockers"
  ],
  "manualNotes": "anything else the parent should know"
}
```
