kanuba0814/puzzle-arm/.pi-subagents/artifacts/576beac6-c80d-4ae6-94ea-047c9e675aa0_reviewer_input.md

# Task for reviewer

Final read-only review of .taskman/plans/adopt-puzzle-vision-v2-2/PLAN.md and context.md after amendments. Cross-check AGENTS.md, docs/00_范围与冻结决策.md, docs/01_赛题需求追踪矩阵.md, docs/02_系统总体架构.md, docs/05_OpenCV视觉流水线.md, docs/06_拼图求解器.md, docs/10_接口与数据契约.md, docs/12_测试与验收计划.md, docs/19_决策门与停止条件.md, configs/parameter_registry.yaml, data_contracts/piece_observation.schema.json, data_contracts/placement_plan.schema.json, workspace/src/vision/red_piece_detector.py. Evaluate: repo priorities/safety, external-algorithm strengths correctly adopted, flaws excluded, phase dependencies executable, acceptance criteria falsifiable, interface/frame semantics coherent, and scope not overreaching. Report only blockers or major amendments still needed; explicitly say APPROVED if none. Do not edit files.

---
**Output:**
Write your findings to exactly this path: /home/gxxl/nudec-re101/.pi-subagents/artifacts/outputs/576beac6-c80d-4ae6-94ea-047c9e675aa0/final-plan-review.md
This path is authoritative for this run.
Ignore any other output filename or output path mentioned elsewhere, including output destinations in the base agent prompt, system prompt, or task instructions.

## Acceptance Contract
Acceptance level: attested
Completion is not accepted from prose alone. End with a structured acceptance report.

Criteria:
- criterion-1: Return concrete findings with file paths and severity when applicable

Required evidence: review-findings, residual-risks

Finish with a fenced JSON block tagged `acceptance-report` in this shape:
Use empty arrays when no items apply; array fields contain strings unless object entries are shown.
`criteriaSatisfied[].status` must be exactly one of: satisfied, not-satisfied, not-applicable.
`commandsRun[].result` must be exactly one of: passed, failed, not-run.
`manualNotes` and `notes` are optional strings; an empty string means no note and does not satisfy `manual-notes` evidence.
```acceptance-report
{
  "criteriaSatisfied": [
    {
      "id": "criterion-1",
      "status": "satisfied",
      "evidence": "specific proof"
    }
  ],
  "changedFiles": [
    "src/file.ts"
  ],
  "testsAddedOrUpdated": [
    "test/file.test.ts"
  ],
  "commandsRun": [
    {
      "command": "command",
      "result": "passed",
      "summary": "short result"
    }
  ],
  "validationOutput": [
    "validation output or concise summary"
  ],
  "residualRisks": [
    "none"
  ],
  "noStagedFiles": true,
  "diffSummary": "short description of the diff",
  "reviewFindings": [
    "blocker: file.ts:12 - issue found, or no blockers"
  ],
  "manualNotes": "anything else the parent should know"
}
```
