kanuba0814/puzzle-arm/.pi-subagents/artifacts/fdde5f22-1c7f-434f-884d-69e94f77d191_reviewer_1_input.md

# Task for reviewer

[Read from: /tmp/epuzzle-live-gui-20260731]

只读检查 /tmp/epuzzle-live-gui-20260731 中 GUI A4 标定、camera_backend.py、vision.py、gui_calibration.py、gui_fb.py、gui_backend.py 的实际 API。重点回答：怎样从当前相机安全抓一帧并输出红色碎片中心 table_mm/yaw，homography 的方向/单位是什么，哪个页面最适合加正式抓取/旋转/放置操作，运行中进程有哪些资源冲突。列出精确符号/行范围；不要修改文件。

## Acceptance Contract
Acceptance level: attested
Completion is not accepted from prose alone. End with a structured acceptance report.

Criteria:
- criterion-1: Return concrete findings with file paths and severity when applicable

Required evidence: review-findings, residual-risks

Finish with a fenced JSON block tagged `acceptance-report` in this shape:
Use empty arrays when no items apply; array fields contain strings unless object entries are shown.
`criteriaSatisfied[].status` must be exactly one of: satisfied, not-satisfied, not-applicable.
`commandsRun[].result` must be exactly one of: passed, failed, not-run.
`manualNotes` and `notes` are optional strings; an empty string means no note and does not satisfy `manual-notes` evidence.
```acceptance-report
{
  "criteriaSatisfied": [
    {
      "id": "criterion-1",
      "status": "satisfied",
      "evidence": "specific proof"
    }
  ],
  "changedFiles": [
    "src/file.ts"
  ],
  "testsAddedOrUpdated": [
    "test/file.test.ts"
  ],
  "commandsRun": [
    {
      "command": "command",
      "result": "passed",
      "summary": "short result"
    }
  ],
  "validationOutput": [
    "validation output or concise summary"
  ],
  "residualRisks": [
    "none"
  ],
  "noStagedFiles": true,
  "diffSummary": "short description of the diff",
  "reviewFindings": [
    "blocker: file.ts:12 - issue found, or no blockers"
  ],
  "manualNotes": "anything else the parent should know"
}
```
