kanuba0814/puzzle-arm/docs/references/puzzle_vision_simulator_v2_2.md

# puzzle-vision-simulator v2.2 参考冻结

- URL: `https://github.com/lvreng/puzzle-vision-simulator`
- tag: `v2.2.0-vision-rounded-card`
- commit: `fbd9c1cbb9b621c0a54101cc421cc43d54926222`
- 许可证：参考时未发现 LICENSE；本仓未 vendor 其源码、测试或 Joker 素材。

本项目仅独立实现可公开描述的设计思想：尺度感知多阈值分割、物理轮廓与虚拟几何分离、完整/部分边候选以及统一 penalty。所有夹具由本仓程序生成。
