kanuba0814/puzzle-arm/.pi-subagents/artifacts/progress/b7277d7e-e5fd-4cc3-9c36-b7e1cb34ddfd/progress.md

# oracle 进度

- [x] 读取 PLAN.md / context.md / AGENTS.md / 全局规则
- [x] 审计 vision(red_piece_detector)、puzzle(空)、integration(空)、control 边界
- [x] 审计 data_contracts、parameter_registry、docs/01,05,06,10,12,13,18,19,23
- [x] 审计 GUI(pick_place_page、gui_fb、gui_backend、Tkinter gui_app)
- [x] 审计 deployment/raspberry_pi(build-image.sh、requirements、overlay systemd/udev/selfcheck)
- [x] 交叉核对同轮 algorithm.md / gui.md / supervisor.md 三份上下文产物
- [x] 发现整理：Gate 口径、契约漂移、auto-stack inert、镜像缺 pygame、estop sudo 等
- [ ] 写出 oracle.md 终稿（P0/P1、Gate 延后、seam、扫块算法、GUI 流、验收合同、部署回退）
- [x] oracle.md 终稿已写出（181 行），含 P0/P1、延后 Gate、seam、扫块算法、GUI 流、验收合同、部署回退、3 项待主代理决策
