kanuba0814/puzzle-arm/docs/17_BOM与采购核对.md

# 17 BOM 与采购核对

## 已知主件

- Raspberry Pi 5 8GB。
- SO-101 follower 五关节。
- 可用于训练的 leader/其他遥操作设备，需确认。
- 顶置相机。

## 必须准备

- 适配实际电压版本的 SO-101 电源。
- Pi 5 5.1 V / 5 A 供电与主动散热。
- 电磁铁，必须按实物最坏有效磁隙和 30 g 保守试片实测选型；不得把碎片总厚度直接当成空气隙。
- 逻辑电平 MOSFET、栅极电阻、下拉、续流/TVS、保险。
- 弹簧、非磁性顶出环或剥离片。
- 底板、相机支架、A4 固定夹具。
- 普通室内光下稳定的背景材料。
- 急停或快速断电开关。
- 蜂鸣器/LED 完成指示。

## 测试材料

- 0.3 mm 左右镀锌薄铁片。
- 按正式碎片结构组合纸层；记录金属到磁头表面的实际有效间隙。
- 30 g 最坏重量试片。
- 自备题 4 片纯色碎片。
- 多套不大于 4 片、不大于 5 边的现场模拟碎片。
- 多种白底扑克牌图案打印件。
- 标定棋盘格或 ChArUco 板。

## 采购前必须核对

- 舵机型号是 ST-3215-C001 还是 ST-3215-C018。
- 电磁铁在目标间隙下的实测吸力，而非裸接触标称值。
- 相机是否能关闭自动曝光和自动白平衡。
- 控制板与 Pi 的 USB/UART 接口稳定性。
