kanuba0814/puzzle-arm/mechanism/camera_stand/exports/assembly.step

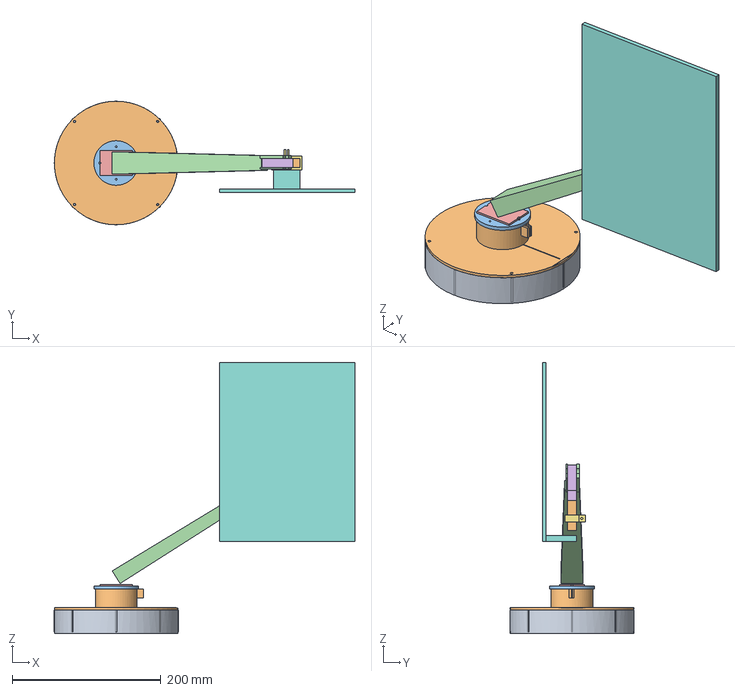
[picture p4: CAD file, 2026-07-31]
mechanism/camera_stand/exports/assembly.step
404.9 x 167.2 x 365.1 mm
