kanuba0814/puzzle-arm/cad/camBridgeLite.SLDPRT

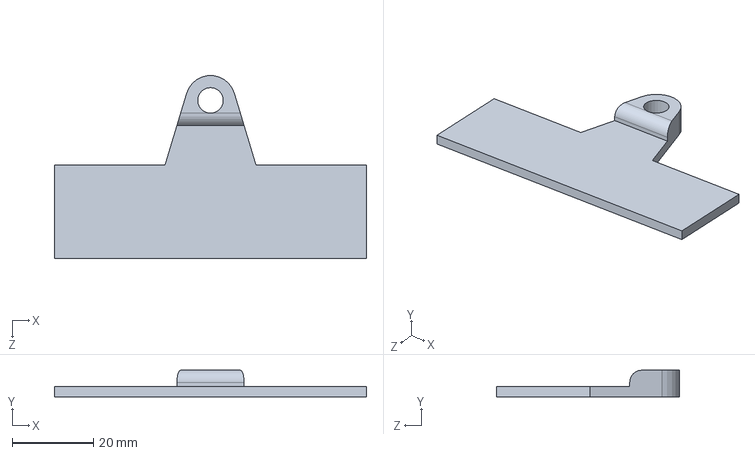
[picture p5: CAD file, 2026-07-31]
cad/camBridgeLite.SLDPRT
77.0 x 6.60 x 45.1 mm
