kanuba0814/puzzle-arm/mechanism/camera_stand/exports/p2_base_top.step

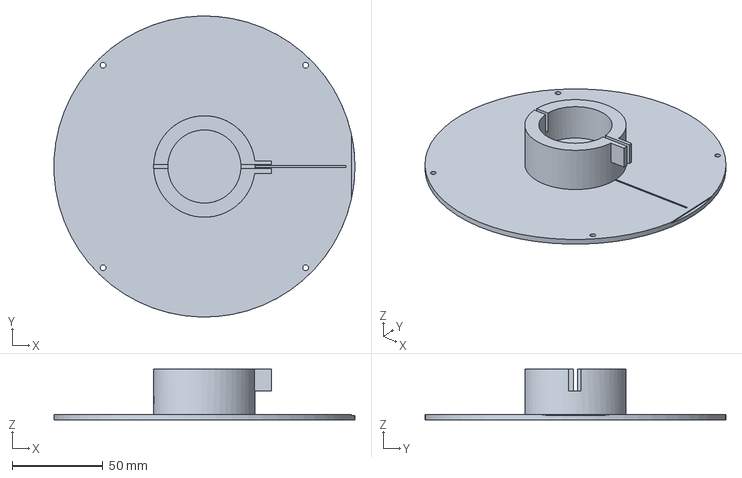
[picture p6: CAD file, 2026-07-31]
mechanism/camera_stand/exports/p2_base_top.step
166.1 x 166.1 x 28.0 mm
