kanuba0814/puzzle-arm/cad/boardCam.SLDPRT

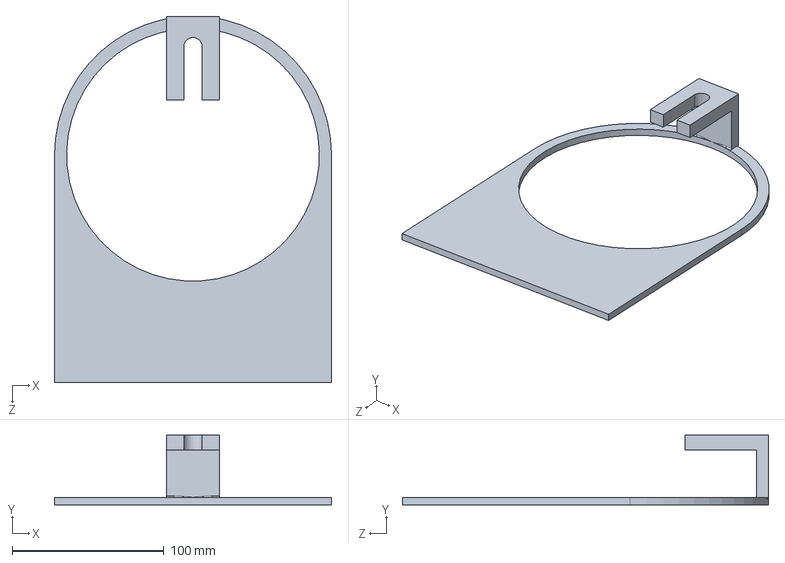
[picture p7: CAD file, 2026-07-31]
cad/boardCam.SLDPRT
182.3 x 46.0 x 241.2 mm
