kanuba0814/puzzle-arm/mechanism/camera_stand/exports/p7_a4_jig.step

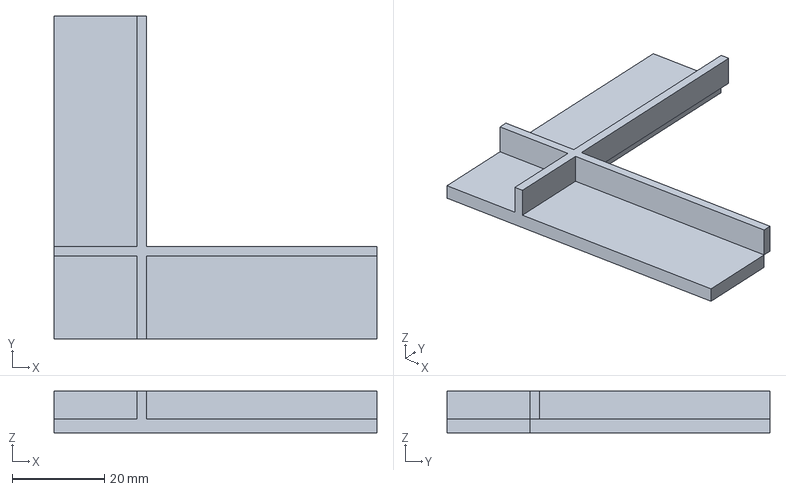
[picture p8: CAD file, 2026-07-31]
mechanism/camera_stand/exports/p7_a4_jig.step
70.0 x 70.0 x 9.00 mm
