kanuba0814/puzzle-arm/cad/camBridge.SLDPRT

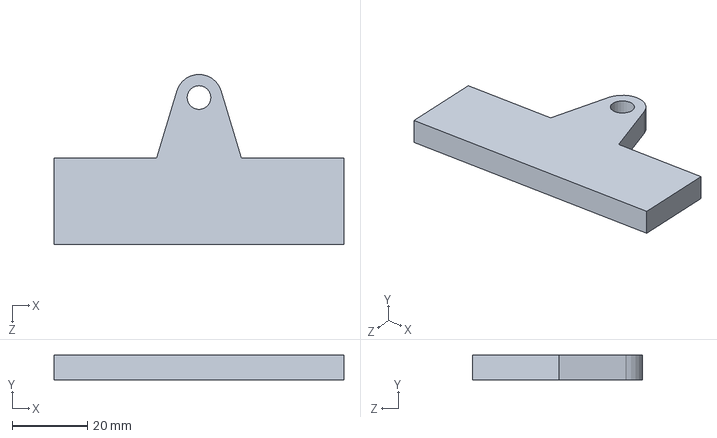
[picture p9: CAD file, 2026-07-31]
cad/camBridge.SLDPRT
77.0 x 6.60 x 45.1 mm
