kanuba0814/puzzle-arm/mechanism/camera_stand/exports/p3_yaw_rotor.step

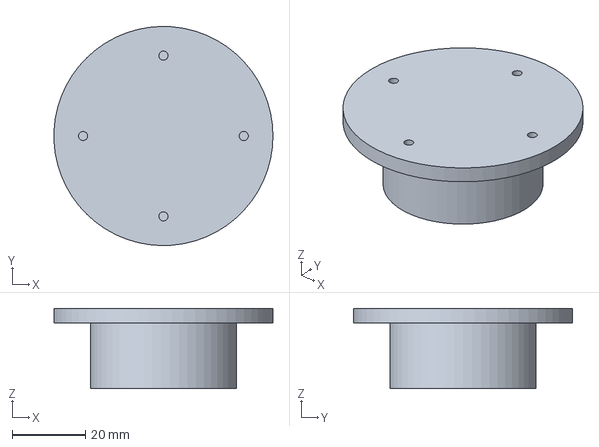
[picture p10: CAD file, 2026-07-31]
mechanism/camera_stand/exports/p3_yaw_rotor.step
60.0 x 60.0 x 22.0 mm
