kanuba0814/puzzle-arm/cad/cambuidge.SLDPRT

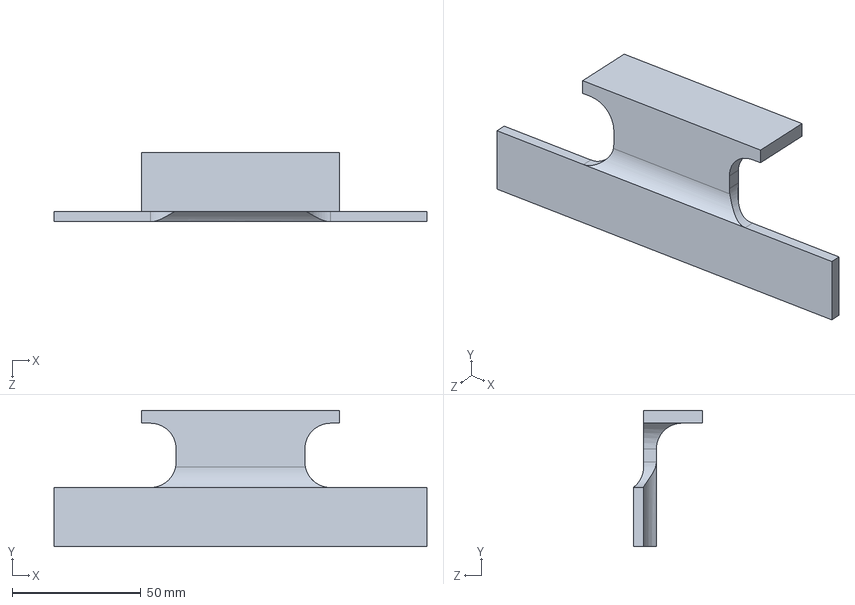
[picture p11: CAD file, 2026-07-31]
cad/cambuidge.SLDPRT
145.0 x 53.0 x 27.0 mm
