kanuba0814/puzzle-arm/mechanism/camera_stand/exports/p5_tip_elbow.step

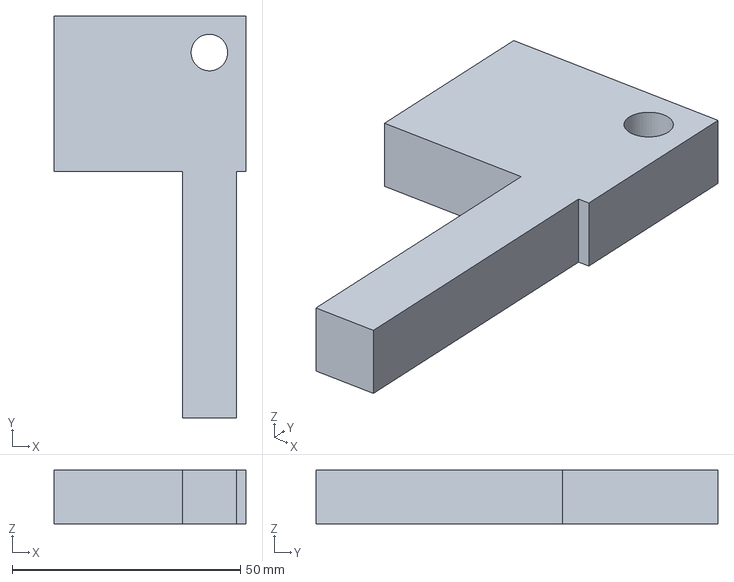
[picture p12: CAD file, 2026-07-31]
mechanism/camera_stand/exports/p5_tip_elbow.step
42.0 x 88.0 x 11.8 mm
