kanuba0814/puzzle-arm/cad/hand.SLDPRT

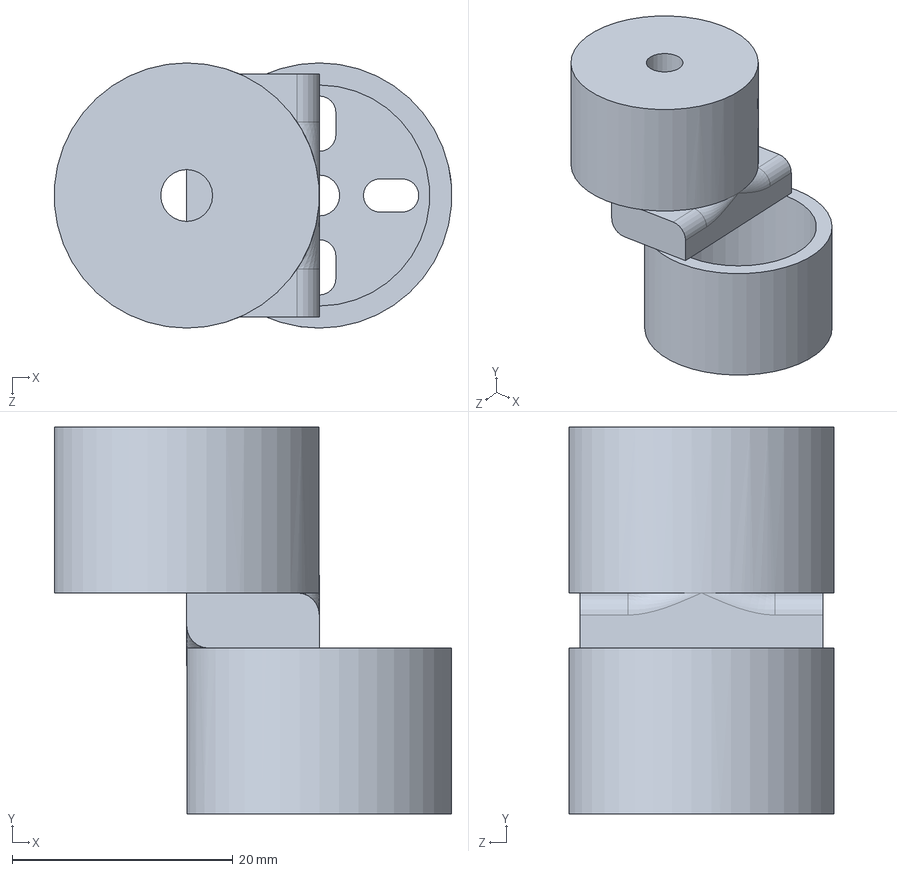
[picture p13: CAD file, 2026-07-31]
cad/hand.SLDPRT
35.9 x 35.0 x 24.0 mm
