kanuba0814/puzzle-arm/mechanism/camera_stand/exports/p4_boom.step

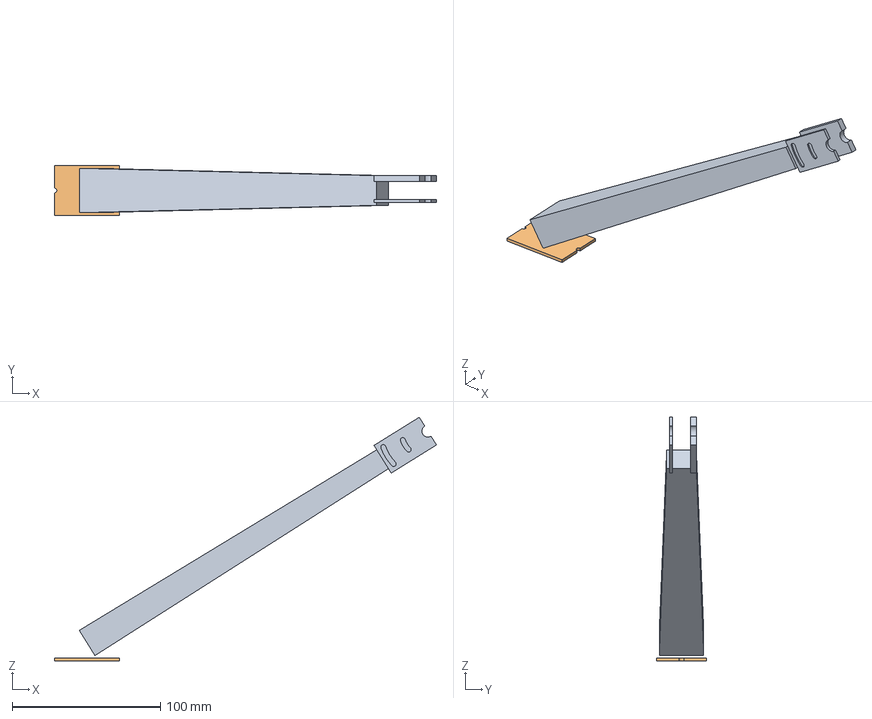
[picture p14: CAD file, 2026-07-31]
mechanism/camera_stand/exports/p4_boom.step
257.8 x 34.0 x 164.3 mm
