kanuba0814/puzzle-arm/cad/零件1.SLDPRT

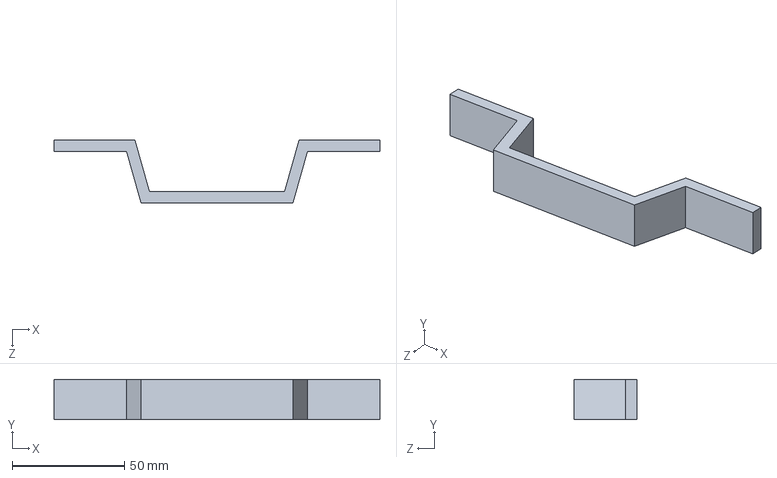
[picture p15: CAD file, 2026-07-31]
cad/零件1.SLDPRT
145.0 x 18.0 x 28.0 mm
