kanuba0814/puzzle-arm/mechanism/camera_stand/exports/p9b_fit_plug.step

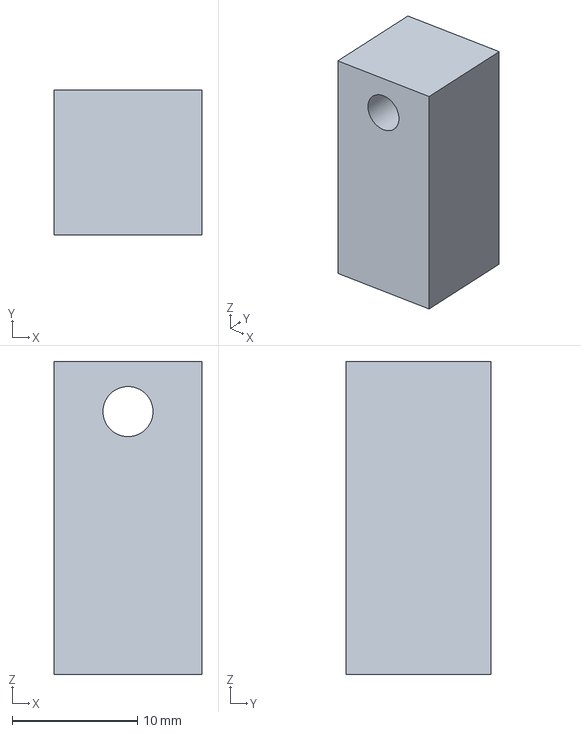
[picture p16: CAD file, 2026-07-31]
mechanism/camera_stand/exports/p9b_fit_plug.step
11.8 x 11.6 x 25.0 mm
