kanuba0814/puzzle-arm/cad/handV2.SLDPRT

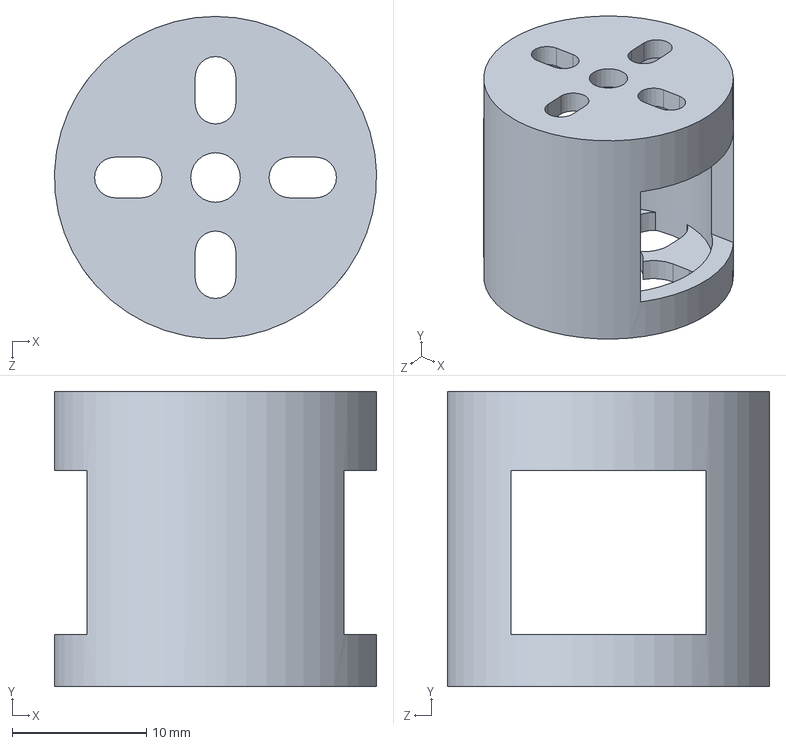
[picture p17: CAD file, 2026-07-31]
cad/handV2.SLDPRT
24.0 x 22.0 x 24.0 mm
