kanuba0814/puzzle-arm/mechanism/camera_stand/exports/p6_clamp_band.step

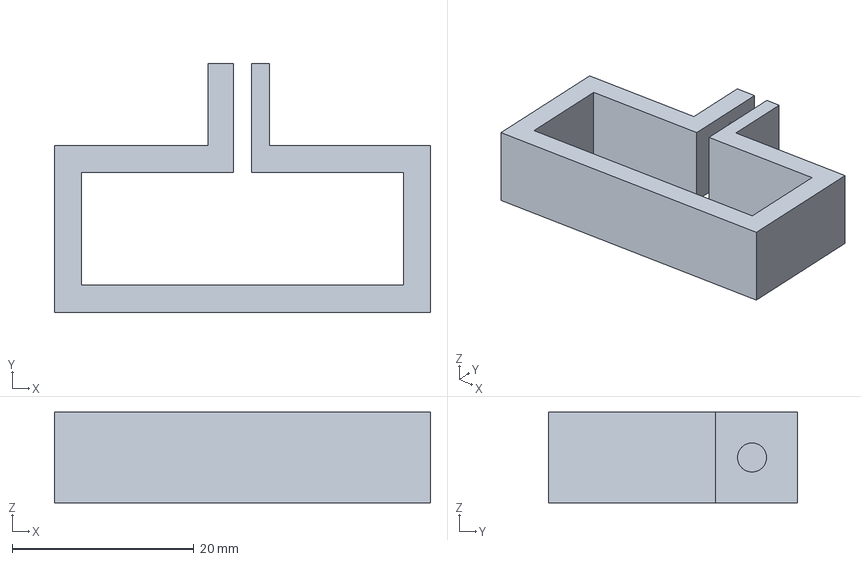
[picture p18: CAD file, 2026-07-31]
mechanism/camera_stand/exports/p6_clamp_band.step
41.4 x 27.4 x 10.0 mm
