kanuba0814/puzzle-arm/mechanism/camera_stand/exports/p9a_fit_coupon.step

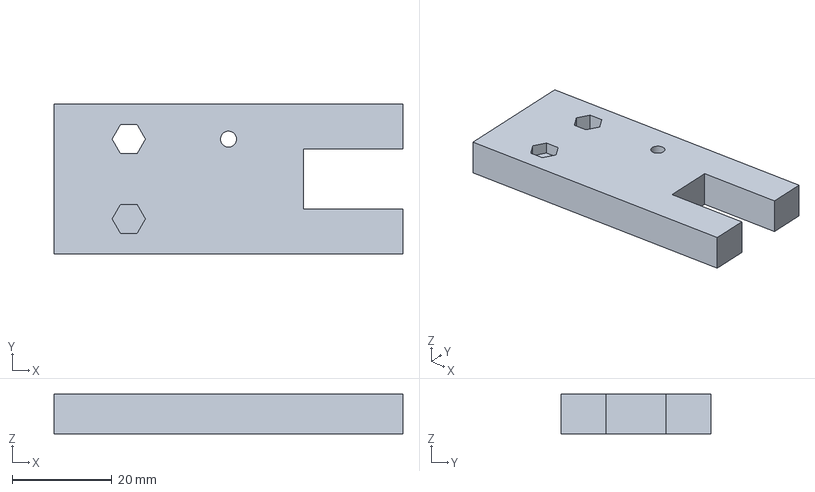
[picture p19: CAD file, 2026-07-31]
mechanism/camera_stand/exports/p9a_fit_coupon.step
70.0 x 30.0 x 8.00 mm
