kanuba0814/puzzle-arm/mechanism/camera_stand/exports/p8_cable_clip.step

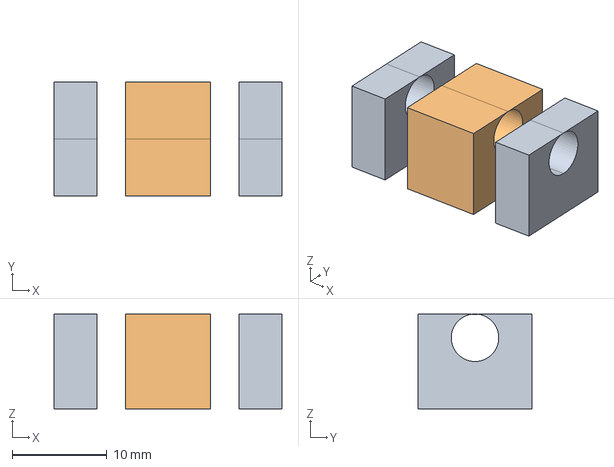
[picture p20: CAD file, 2026-07-31]
mechanism/camera_stand/exports/p8_cable_clip.step
24.0 x 12.0 x 10.0 mm
