kanuba0814/puzzle-arm/mechanism/camera_stand/exports/p1_base_tub.step

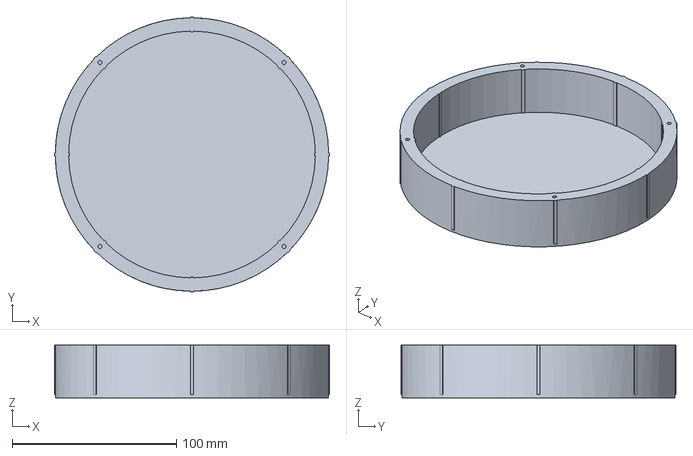
[picture p21: CAD file, 2026-07-31]
mechanism/camera_stand/exports/p1_base_tub.step
167.2 x 167.2 x 32.0 mm
