kanuba0814/puzzle-arm/(list of files, cad)

Other CAD files:
cad/boardCam.STL
cad/camBridge.STL
cad/camBridgeLite.STL
cad/cambuidge.STL
cad/hand.STL
cad/handV2.STL
mechanism/camera_stand/exports/p1_base_tub.stl
mechanism/camera_stand/exports/p2_base_top.stl
mechanism/camera_stand/exports/p3_yaw_rotor.stl
mechanism/camera_stand/exports/p4_boom.stl
mechanism/camera_stand/exports/p5_tip_elbow.stl
mechanism/camera_stand/exports/p6_clamp_band.stl
mechanism/camera_stand/exports/p7_a4_jig.stl
mechanism/camera_stand/exports/p8_cable_clip.stl
mechanism/camera_stand/exports/p9a_fit_coupon.stl
mechanism/camera_stand/exports/p9b_fit_plug.stl
