kanuba0814/puzzle-arm/mechanism/camera_stand/renders/assembly_front.png

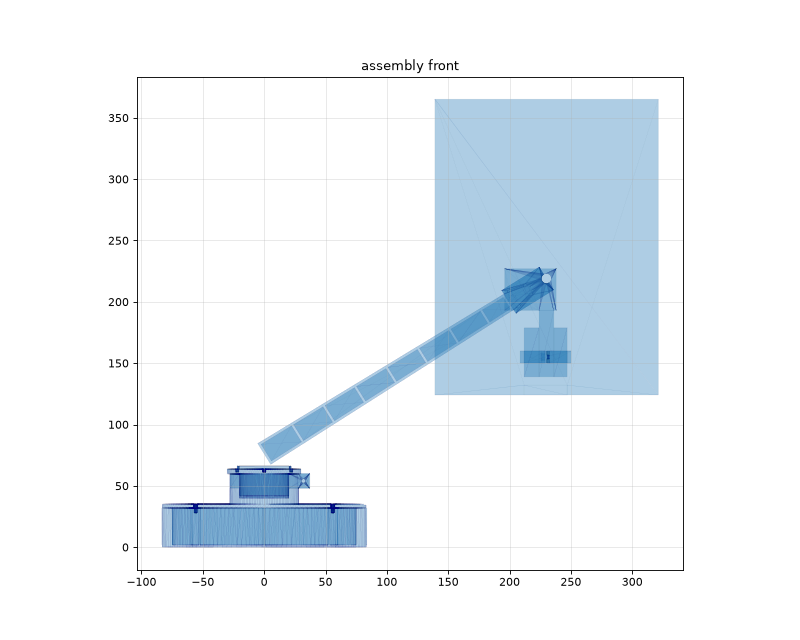
mechanism/camera_stand/renders/assembly_front.png
