kanuba0814/puzzle-arm/mechanism/camera_stand/renders/assembly_side.png

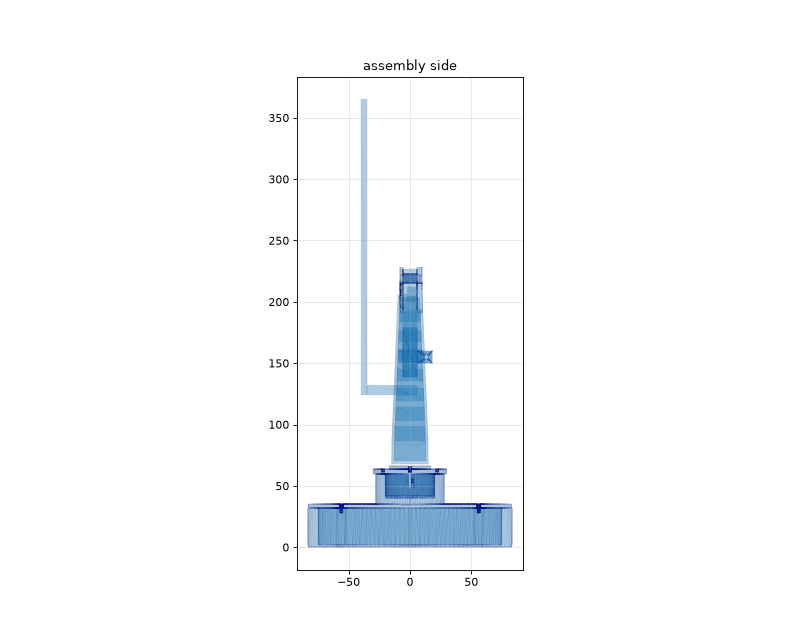
mechanism/camera_stand/renders/assembly_side.png
