kanuba0814/puzzle-arm/mechanism/camera_stand/renders/assembly_top.png

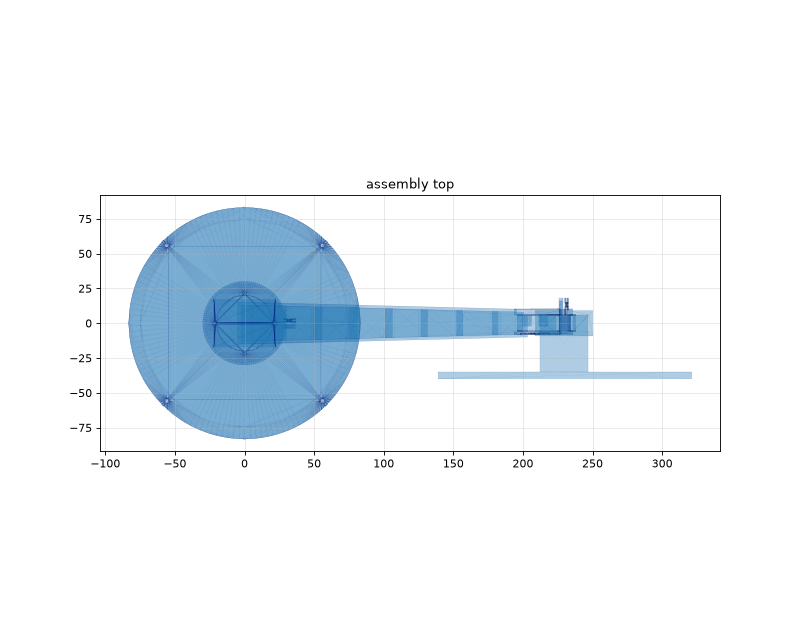
mechanism/camera_stand/renders/assembly_top.png
