kanuba0814/puzzle-arm/workspace/calibration/evidence/2026-08-01_green_assembly/green_frame.jpg

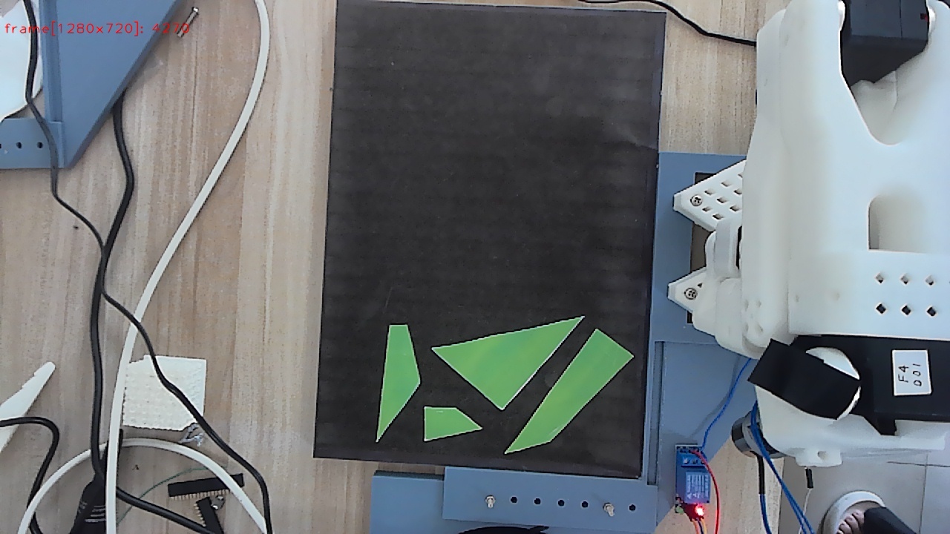
workspace/calibration/evidence/2026-08-01_green_assembly/green_frame.jpg
