kanuba0814/puzzle-arm/workspace/calibration/evidence/2026-07-31_red_piece_center_sweep/README.md

# 2026-07-31 红色碎片中心重复与巡检

- 视觉：GUI 新标定的 1280×720 UVC A4 homography，像素→`table_mm`。
- 场景：黑色 A4 工作区上 4 个红色碎片。
- 动作：磁铁关闭；精确终点模式；20 mm PREGRASP 高度。
- 选中碎片 `red-0` 重复到达 2 次：五轴最大差 `0.263736°`，生产 FK 重算 XY 差 `1.104762 mm`。
- 4 个碎片中心全部扫过：顺序 `red-0 → red-3 → red-2 → red-1`。
- 最终回正式 PARK；力矩关闭，磁铁关闭。

文件：

- `repeat_and_sweep.json`：完整五轴读回和 FK 重放。
- `summary.json`：机器可读摘要。
