kanuba0814/puzzle-arm/workspace/calibration/fixtures/single_arm_contact_sheet_hand_draw_v1.md

# 单臂触点纸手工绘制简图 v1

> 仅作为 provisional 采点治具；最终是否可接受由独立 holdout 指标决定。

使用 A4 纸，以左下角为 `(0,0)`，x 向右、y 向上，单位均为 mm。所有坐标必须分别从同一左边/下边测量，不得逐段累加。

```text
y=250      A(35,250)       B(105,250)       D(175,250)

y=210             M(70,210)       N(140,210)       HOLDOUT

y=170      E(35,170)       F(105,170)       G(175,170)

y=120             O(70,120)       P(140,120)       HOLDOUT

y=80       H(35,80)        I(105,80)

(0,0) = A4 左下角
```

每个中心画一个 20×20 mm 正方形，即中心左右、上下各 10 mm。20 mm 圆形磁铁放下时，应同时与正方形四边中点相切，四角保持可见。

绘制后复核：

- 任一目标正方形边长：20 mm；
- A→B：70 mm；
- B→D：70 mm；
- A→E：80 mm；
- M/N/O/P 明确标记为 `HOLDOUT`；
- 纸张固定在刚性平面，采完前不得移动；
- 电磁铁全程断电。
