kanuba0814/puzzle-arm/workspace/calibration/fixtures/single_arm_contact_sheet_v1.pdf

# SO-101 TCP CONTACT SHEET v1 — PRINT AT 100%

20.00 mm exact circle / 26.00 mm guide · magnet OFF · origin: bottom-left

A

35,250 FIT

B

105,250 FIT

D

175,250 FIT M

70,210 HOLDOUT

N

140,210 HOLDOUT E

35,170 FIT

F

105,170 FIT

G

175,170 FIT

O

70,120 HOLDOUT

P

140,120 HOLDOUT H

35,80 FIT

I

105,80 FIT

VERIFY THIS LINE = 100.00 mm sheet origin (0,0) is bottom-left page corner
