kanuba0814/puzzle-arm/templates/calibration_record.md

# 标定记录

- 日期/时间：
- 操作者：
- Git commit：
- 设备 ID：
- 相机型号与设备路径：
- 图像分辨率：
- 自动曝光/白平衡/对焦状态：
- 机械臂 robot ID：
- 舵机型号与供电：

## 相机内参

- 标定板：
- 有效图像数：
- RMS 重投影误差：
- 文件路径与 SHA256：

## 桌面单应

- `table_mm` 原点与轴定义：
- 标志点坐标：
- 网格点误差统计：

## 机械臂转换

- 基座相对 A4 纸位置：
- 拟合模型：刚体 / 仿射 / 查表修正
- 残差统计：
- 末端工具中心偏移：

## 结论

- 通过/不通过：
- 适用配置：
- 已知限制：
