kanuba0814/puzzle-arm/templates/experiment_log.md

# 实验日志

- 假设：
- 可证伪条件：
- 单一改变量：
- 固定条件：
- 数据集/碎片集：
- 评价指标：
- 结果：
- 结论：接受 / 拒绝 / 数据不足
- 对正式分支的影响：
