kanuba0814/puzzle-arm/templates/test_record.md

# 测试记录

- 测试 ID：
- 日期/时间：
- 执行人：
- Git commit：
- 配置版本：
- 标定 ID：
- 赛题模式：自备 / 白色 / 扑克牌 / 单片

## 条件

- 照明与背景：
- 碎片集合：
- 初始摆放方法：
- ACT：关闭 / 开启，checkpoint：

## 结果

- 成功/失败：
- 总耗时：
- 抓取重试次数：
- 放置修正次数：
- 最大顶点偏差：
- 错误码：

## 证据文件

- 原图：
- 诊断图：
- 状态机日志：
- 关节日志：
- 视频：

## 分析与动作

- 失败根因：
- 下一步修改：
- 是否需要回归：
