kanuba0814/puzzle-arm/docs/experiments/servo_speed_tuning_20260801.md

# 舵机提速第一阶段记录

日期：2026-08-01

## 目标

在不改变五轴顺序、最大关节步长、PICK/PLACE 严格闭环和电磁铁安全边界的前提下，减少拼图运动时间。

## 本次提交

第一阶段只采用保守的分档速度，并增加非终点路点最小保持时间，防止宽跟随容差在舵机尚未启动时误判到位。

| 速度档 | Goal_Velocity | 代码换算值（非实测） | 用途 |
|---|---:|---:|---|
| EMPTY_NORMAL | 250 | 约 44°/s | 高位空载巡航 |
| EMPTY_SLOW | 150 | 约 26°/s | 空载接近 |
| HOLDING_SLOW | 100 | 约 18°/s | 持物、PICK/PLACE 前后 |

路点 dwell：`0.15 / 0.20 / 0.30s`；终点仍使用正式关节容差，PICK/PLACE 不使用宽跟随容差。

Goal_Velocity 在速度档变化时写入一次，同一档的后续 waypoint 不重复写入。

## 验收状态

- 软件单元测试：待部署前运行。
- Pi 软件自检：待部署后运行。
- PARK→HOME→PARK 实机往返：待现场明确动作授权后运行。
- 单片抓放成功率：本提交不宣称已验证；当前无吸附/释放传感器。

## 风险

当前实测舵机供电约 4.8–4.9V，带载 wrist_flex 下垂风险仍存在。因此本阶段不提高 `HOLDING_SLOW`，也不同时提高 `Acceleration`。
