kanuba0814/puzzle-arm/docs/experiments/live_v3/frame.jpg

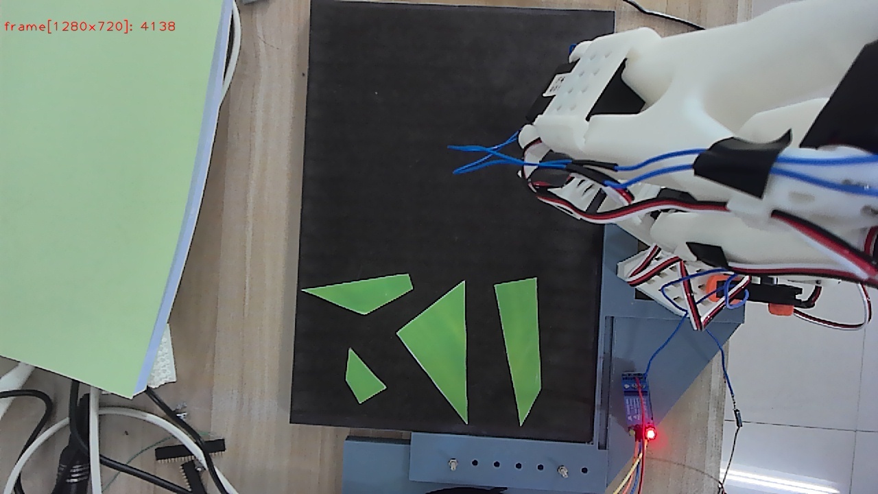
docs/experiments/live_v3/frame.jpg
