kanuba0814/puzzle-arm/docs/experiments/test_log_20260801/frame.jpg

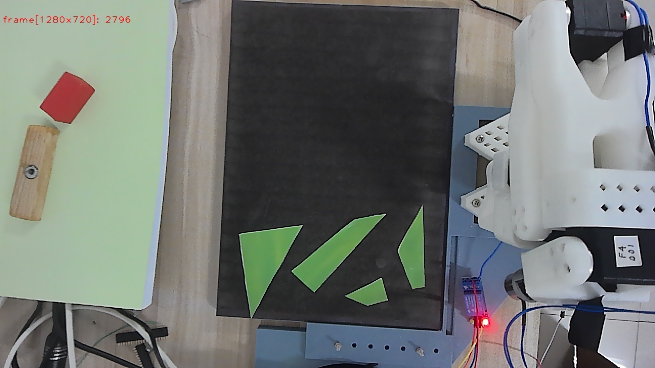
docs/experiments/test_log_20260801/frame.jpg
