kanuba0814/puzzle-arm/docs/experiments/v10_logs/frame.jpg

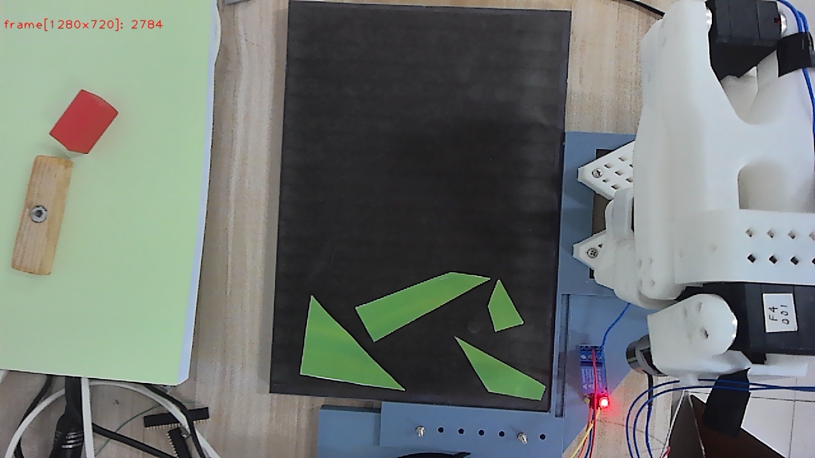
docs/experiments/v10_logs/frame.jpg
