kanuba0814/puzzle-arm/workspace/calibration/evidence/2026-07-31_full_stack_deployment/gui_home.png

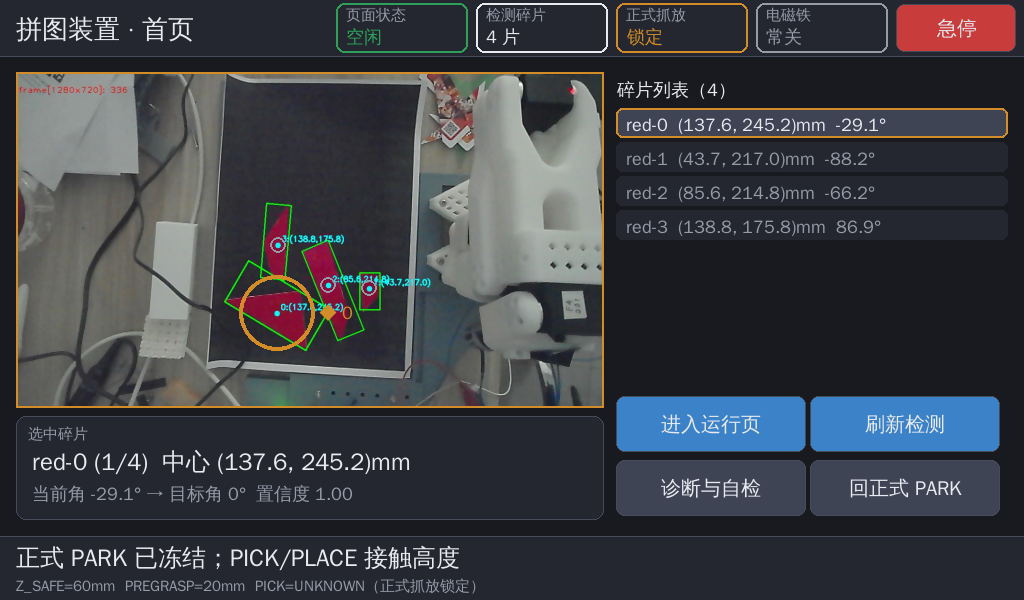
workspace/calibration/evidence/2026-07-31_full_stack_deployment/gui_home.png
