kanuba0814/puzzle-arm/workspace/calibration/evidence/2026-07-31_gui_a4_workspace/formal_pick_place_page.png

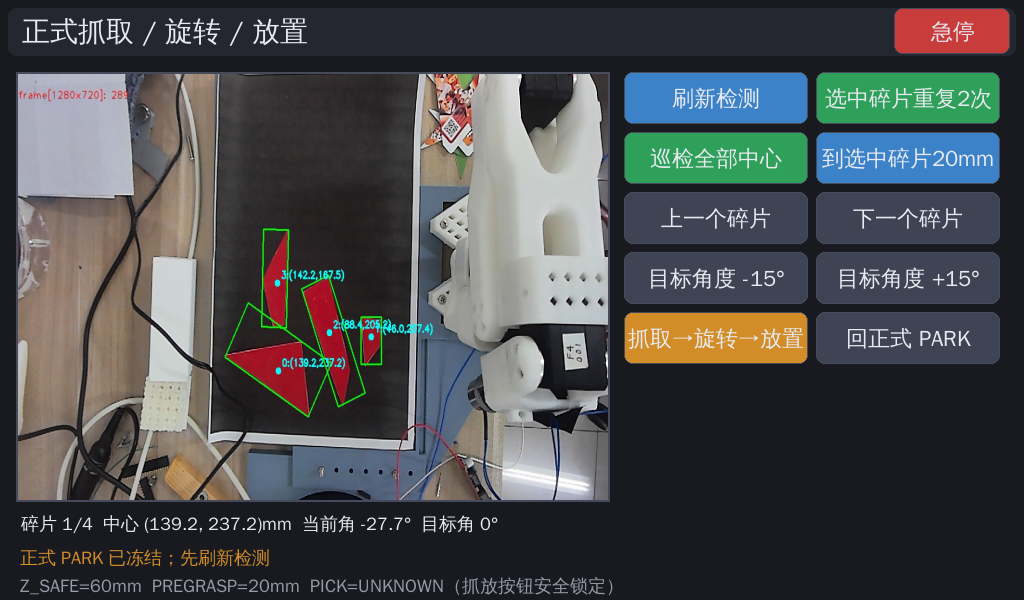
workspace/calibration/evidence/2026-07-31_gui_a4_workspace/formal_pick_place_page.png
