kanuba0814/puzzle-arm/workspace/calibration/evidence/2026-07-31_gui_a4_workspace/latest_annotated.jpg

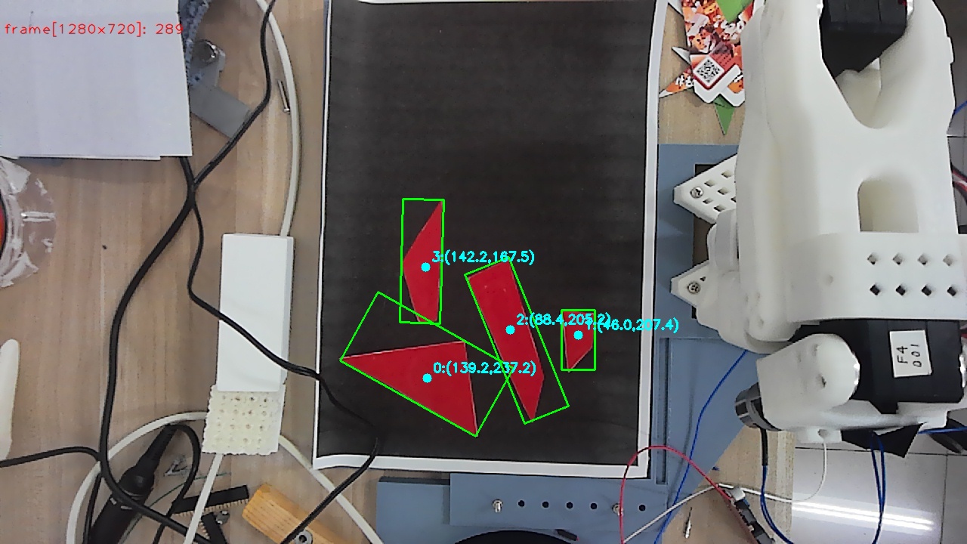
workspace/calibration/evidence/2026-07-31_gui_a4_workspace/latest_annotated.jpg
