kanuba0814/puzzle-arm/workspace/calibration/evidence/2026-07-31_gui_a4_workspace/red_pieces_mask.png

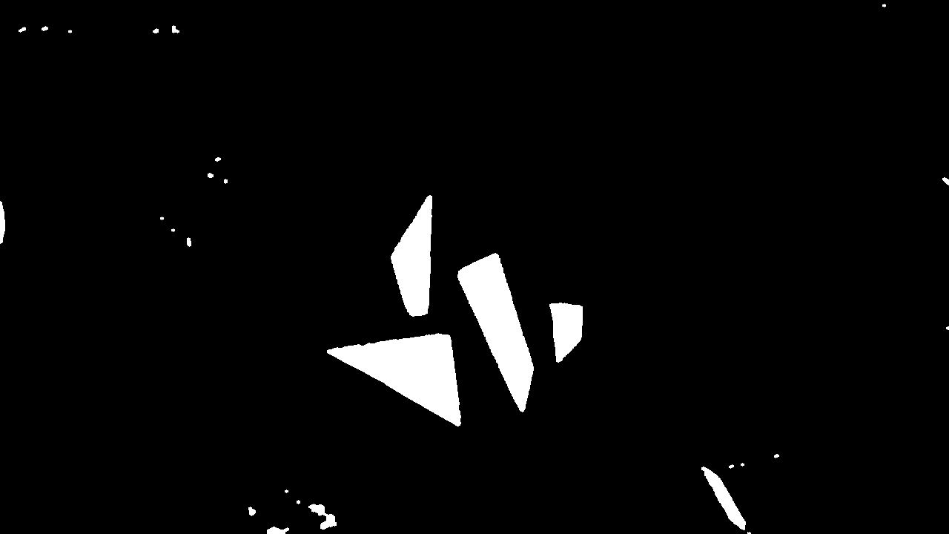
workspace/calibration/evidence/2026-07-31_gui_a4_workspace/red_pieces_mask.png
