kanuba0814/puzzle-arm/workspace/calibration/evidence/2026-07-31_tcp_measurement/front_coaxial_view.jpg

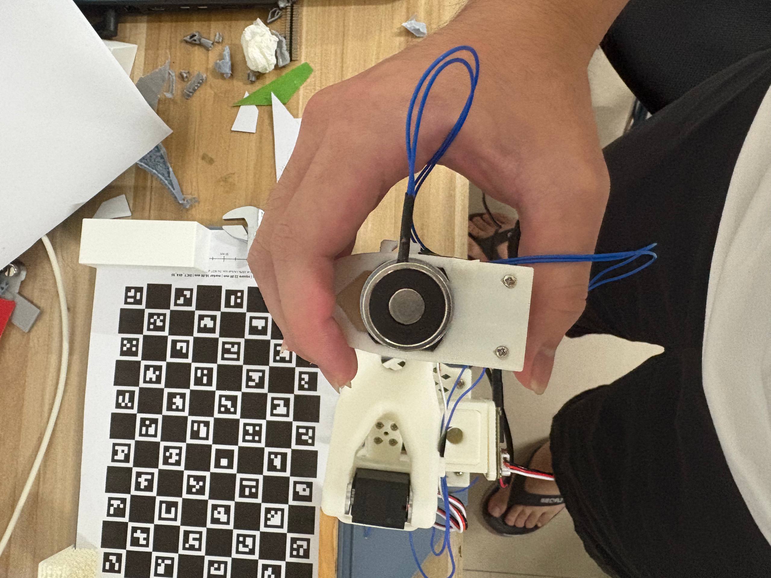
workspace/calibration/evidence/2026-07-31_tcp_measurement/front_coaxial_view.jpg
