kanuba0814/puzzle-arm/workspace/calibration/evidence/2026-07-31_tcp_measurement/side_caliper_40.17mm.jpg

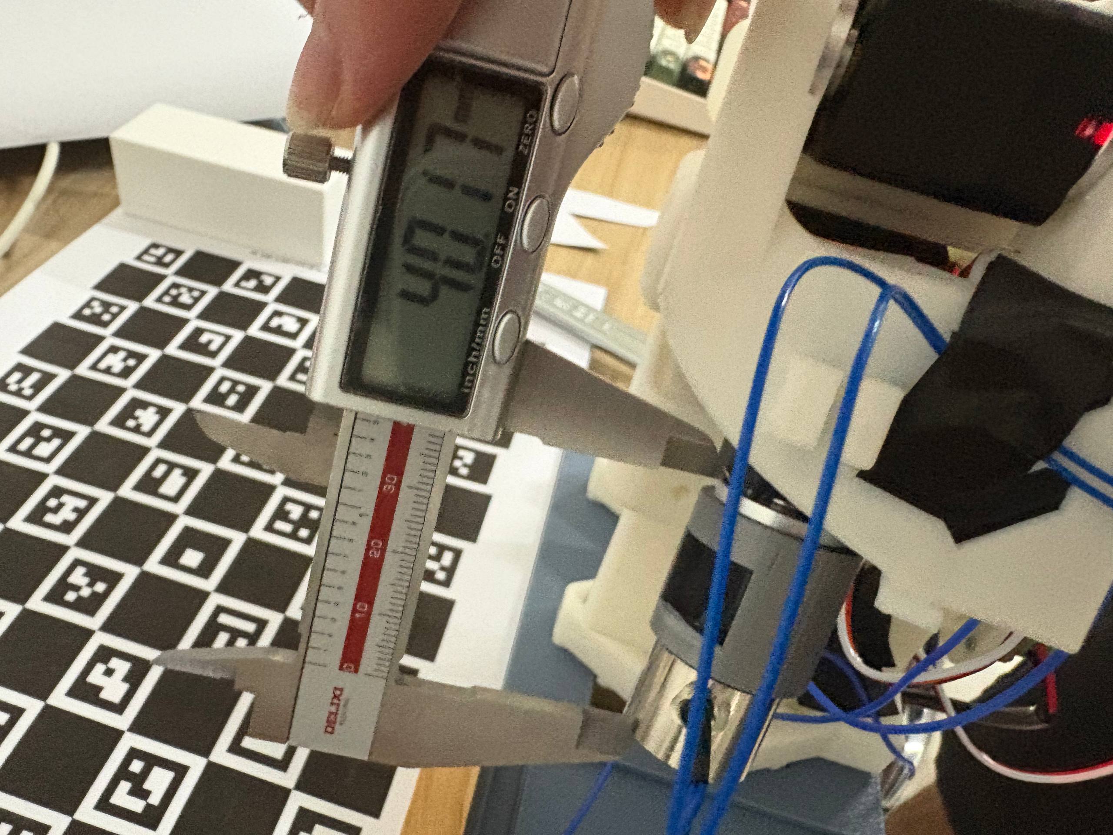
workspace/calibration/evidence/2026-07-31_tcp_measurement/side_caliper_40.17mm.jpg
