kanuba0814/puzzle-arm/workspace/calibration/evidence/2026-07-31_usb_recovery_and_sweep/mask.png

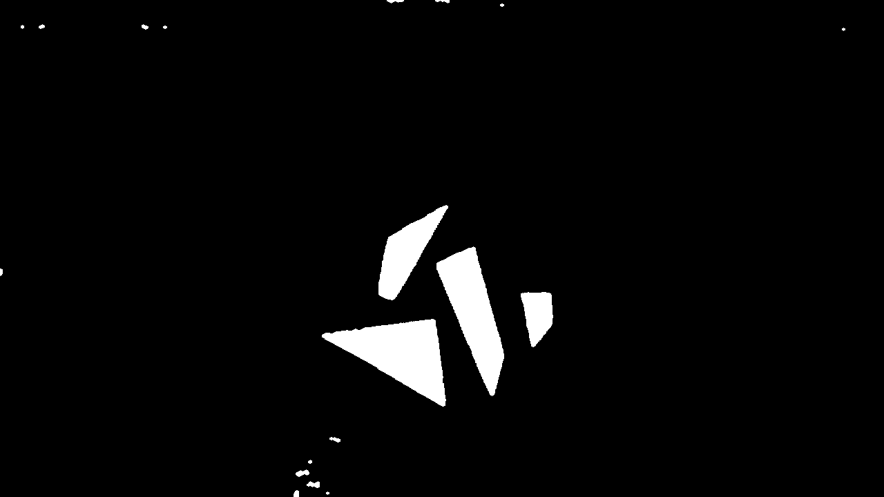
workspace/calibration/evidence/2026-07-31_usb_recovery_and_sweep/mask.png
