kanuba0814/puzzle-arm/workspace/calibration/evidence/2026-08-01_camera_recalibration/current_after_calibration.jpg

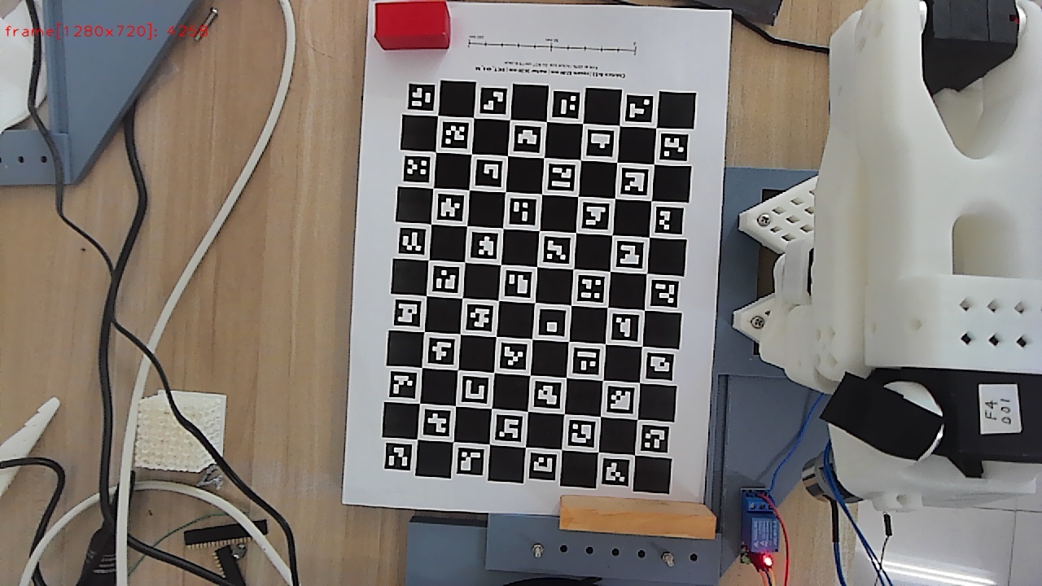
workspace/calibration/evidence/2026-08-01_camera_recalibration/current_after_calibration.jpg
