kanuba0814/puzzle-arm/workspace/calibration/evidence/2026-08-01_card_123_retry/vision_frame.jpg

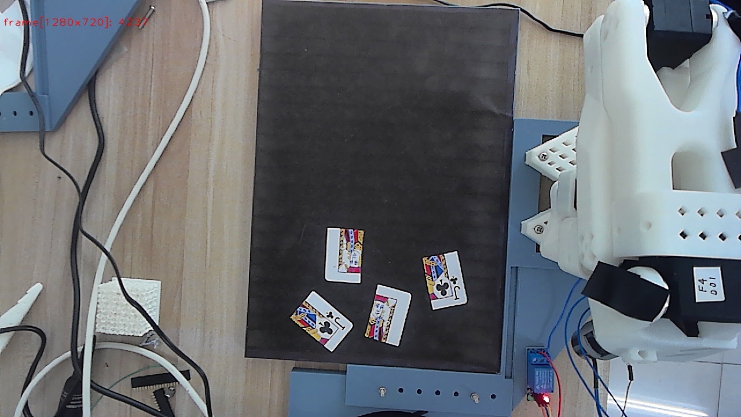
workspace/calibration/evidence/2026-08-01_card_123_retry/vision_frame.jpg
