kanuba0814/puzzle-arm/workspace/calibration/evidence/2026-08-01_green_retry/green_vision_solver_calibration_overlay.jpg

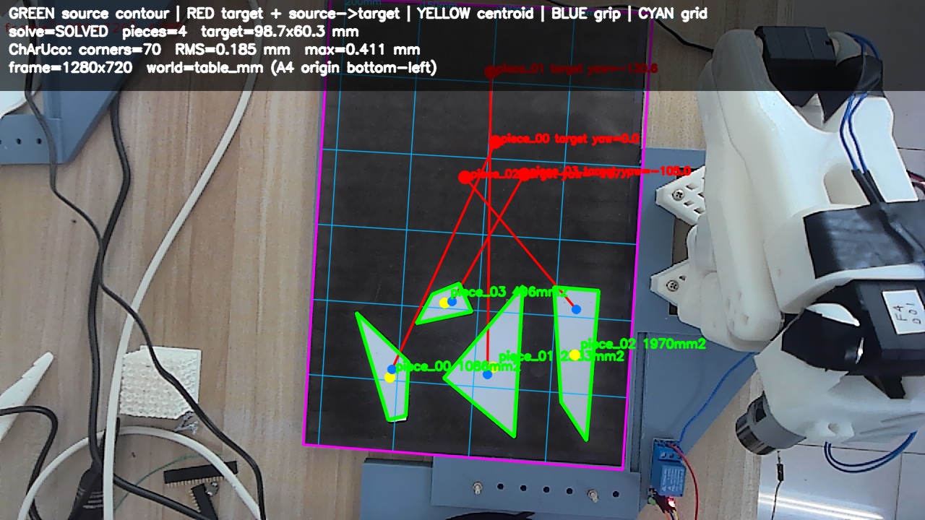
workspace/calibration/evidence/2026-08-01_green_retry/green_vision_solver_calibration_overlay.jpg
