kanuba0814/puzzle-arm/workspace/calibration/evidence/2026-08-01_motion_rewrite_test/camera_after_abort/rectified.jpg

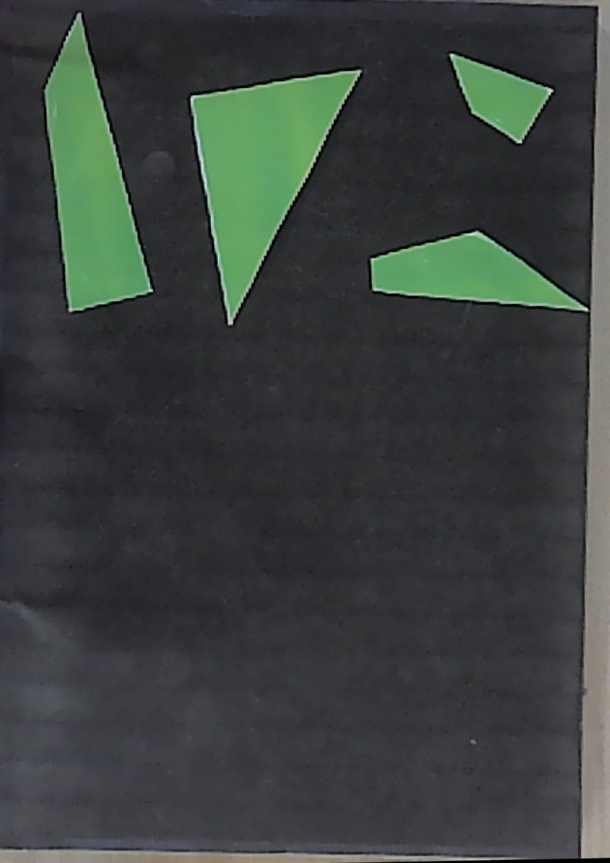
workspace/calibration/evidence/2026-08-01_motion_rewrite_test/camera_after_abort/rectified.jpg
