kanuba0814/puzzle-arm/workspace/calibration/evidence/2026-08-01_white_confirm/raw.jpg

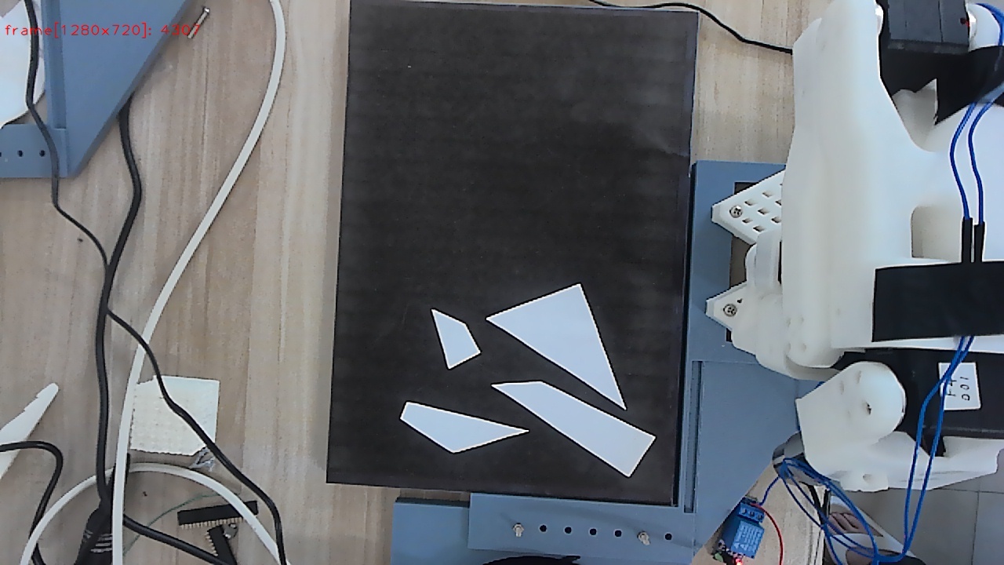
workspace/calibration/evidence/2026-08-01_white_confirm/raw.jpg
