kanuba0814/puzzle-arm/docs/11_运行状态机与故障恢复.md

# 11 运行状态机与故障恢复

## 状态

1. INIT
2. WAIT_START
3. SCAN
4. SOLVE
5. PLAN_PREGRASP
6. MOVE_PREGRASP
7. LOCAL_GRASP_ALIGN
8. MAGNET_ON
9. VERIFY_PICK
10. MOVE_PREPLACE
11. LOCAL_PLACE_ALIGN
12. RELEASE
13. VERIFY_PLACE
14. NEXT_PIECE
15. COMPLETE
16. RECOVERY
17. FAILED

## 核心规则

- 只有 Supervisor 可切换状态。
- 所有状态有最大持续时间。
- 进入任何低高度动作前检查目标、时间戳和视觉置信度。
- 失败后先停止和抬升至安全高度，再重新拍照。

## 抓取失败

判断：原位置仍检测到碎片，或吸头下无有效碎片。

处理：

1. 抬升至安全高度。
2. 重新拍照。
3. 重新计算最大内接圆抓取点。
4. 使用偏移候选或更慢下降重试。
5. 超过最大次数标记失败，不继续盲抓。

## 搬运掉落

- 立即停止横向动作并抬升。
- 重新扫描全部碎片。
- 废弃原有 PlacementPlan，重新求解。

## 释放失败

- 断电后执行顶出和小幅剥离动作。
- 若碎片仍随末端移动，回到目标位置再次释放。
- 禁止高速抖动造成碎片飞出 A4 区域。

## 放置偏差

- 小偏差：重新抓起做一次修正。
- 大偏差或影响后续块：重新扫描和重新求解。
- 已正确放置块也按实际位置更新，而不是锁定理想位置。

## ACT 异常

- 推理超时、NaN、动作越界或图像过期：立即退出 ACT。
- 使用确定性 IK 完成本阶段，或回到安全高度重新规划。
- ACT 异常不得导致全系统终止，除非安全无法保证。
