kanuba0814/puzzle-arm/workspace/src/robot_plugin/lerobot_robot_so101_5d/lerobot_robot_so101_5d/so101_5d.py

# pyright: reportMissingImports=false

from collections.abc import Mapping

from lerobot.cameras import make_cameras_from_configs
from lerobot.motors import Motor, MotorNormMode
from lerobot.motors.feetech import FeetechMotorsBus, OperatingMode
from lerobot.robots.robot import Robot
from lerobot.robots.so_follower.so_follower import SOFollower
from lerobot.types import RobotAction

from .config_so101_5d import SO101Follower5DConfig

JOINT_NAMES = (
    "shoulder_pan",
    "shoulder_lift",
    "elbow_flex",
    "wrist_flex",
    "wrist_roll",
)
JOINT_FEATURES = tuple(f"{joint_name}.pos" for joint_name in JOINT_NAMES)


class SO101Follower5D(SOFollower):
    """去掉 ID 6 夹爪后的 SO-101 五轴 follower。"""

    config_class = SO101Follower5DConfig
    name = "so101_follower_5d"

    def __init__(self, config: SO101Follower5DConfig):
        # 不调用 SOFollower.__init__，避免创建 ID 6 的 gripper。
        Robot.__init__(self, config)
        self.config = config
        if self.calibration and set(self.calibration) != set(JOINT_NAMES):
            missing = sorted(set(JOINT_NAMES) - set(self.calibration))
            extra = sorted(set(self.calibration) - set(JOINT_NAMES))
            raise ValueError(
                f"LeRobot 标定必须是当前单臂精确五轴； missing={missing}, extra={extra}"
            )
        norm_mode = (
            MotorNormMode.DEGREES
            if config.use_degrees
            else MotorNormMode.RANGE_M100_100
        )
        self.bus = FeetechMotorsBus(
            port=config.port,
            motors={
                joint_name: Motor(motor_id, "sts3215", norm_mode)
                for motor_id, joint_name in enumerate(JOINT_NAMES, start=1)
            },
            calibration=self.calibration,
        )
        self.cameras = make_cameras_from_configs(config.cameras)
        # Goal_Velocity 是舵机 SRAM 配置，不是每个位置路点都要重复写入的
        # 动作字段；缓存它可把一条路点的两次总线写请求降为一次。
        self._last_goal_velocity: int | None = None
        self._last_goal_velocity_by_joint: dict[str, int] = {}

    def connect_bumpless(
        self,
        *,
        p_coefficient: int = 16,
        acceleration: int = 10,
    ) -> dict[str, float]:
        """先把目标对齐当前位置，再使能力矩，避免连接瞬间跳变。"""
        if self.bus.is_connected:
            raise RuntimeError("机械臂总线已经连接")
        try:
            self.bus.connect()
            self._last_goal_velocity = None
            self._last_goal_velocity_by_joint = {}
            self.bus.disable_torque()
            if not self.is_calibrated:
                raise RuntimeError("LeRobot 五轴电机标定寄存器不一致")
            self.bus.configure_motors(
                return_delay_time=0,
                maximum_acceleration=acceleration,
                acceleration=acceleration,
            )
            for motor in JOINT_NAMES:
                self.bus.write("Operating_Mode", motor, OperatingMode.POSITION.value)
                self.bus.write("P_Coefficient", motor, p_coefficient)
                self.bus.write("I_Coefficient", motor, 0)
                self.bus.write("D_Coefficient", motor, 32)
                self.bus.write("Acceleration", motor, acceleration)
            present_raw = self.bus.sync_read(
                "Present_Position", normalize=False, num_retry=2
            )
            self.bus.sync_write(
                "Goal_Position", present_raw, normalize=False, num_retry=2
            )
            goal_raw = self.bus.sync_read("Goal_Position", normalize=False, num_retry=2)
            mismatch = {
                motor: int(goal_raw[motor]) - int(present_raw[motor])
                for motor in JOINT_NAMES
            }
            if any(abs(delta) > 1 for delta in mismatch.values()):
                raise RuntimeError(f"当前位置保持目标回读不一致: {mismatch}")
            self.bus.enable_torque(num_retry=2)
            for camera in self.cameras.values():
                camera.connect()
            present_deg = self.bus.sync_read(
                "Present_Position", normalize=True, num_retry=2
            )
            return {f"{motor}.pos": float(present_deg[motor]) for motor in JOINT_NAMES}
        except BaseException:
            if self.bus.is_connected:
                try:
                    self.bus.disable_torque(num_retry=2)
                finally:
                    self.bus.disconnect(disable_torque=True)
            raise

    def reconnect_lite(self) -> dict[str, float]:
        """USB 串口桥掉线后的轻量重连：不断力矩、不重配电机、不碰标定寄存器。

        与 connect_bumpless 的区别：舵机独立供电、寄存器状态在 USB 断开期间保持
        （USB 断开只影响 CH343 串口桥），因此重连不执行 disable_torque /
        configure_motors / enable_torque 循环，避免机械臂在空中瞬时掉力矩。

        流程：打开串口 → 校验冻结标定 → 读 Present_Position → 对齐
        Goal_Position=Present → 读回校验（<=1 LSB）→ 校验 Torque_Enable 五轴
        全 1（任一为 0 视为舵机掉电/未知状态，fail-closed 抛错）→ 返回实际角度。
        """
        if self.bus.is_connected:
            raise RuntimeError("机械臂总线已经连接")
        try:
            self.bus.connect()
            self._last_goal_velocity = None
            self._last_goal_velocity_by_joint = {}
            if not self.is_calibrated:
                raise RuntimeError("LeRobot 五轴电机标定寄存器不一致")
            present_raw = self.bus.sync_read(
                "Present_Position", normalize=False, num_retry=2
            )
            self.bus.sync_write(
                "Goal_Position", present_raw, normalize=False, num_retry=2
            )
            goal_raw = self.bus.sync_read("Goal_Position", normalize=False, num_retry=2)
            mismatch = {
                motor: int(goal_raw[motor]) - int(present_raw[motor])
                for motor in JOINT_NAMES
            }
            if any(abs(delta) > 1 for delta in mismatch.values()):
                raise RuntimeError(f"当前位置保持目标回读不一致: {mismatch}")
            torque_raw = self.bus.sync_read(
                "Torque_Enable", normalize=False, num_retry=2
            )
            torque_off = [motor for motor in JOINT_NAMES if int(torque_raw[motor]) == 0]
            if torque_off:
                raise RuntimeError(
                    f"重连时五轴扭矩未全部开启（{torque_off}），拒绝继续"
                )
            present_deg = self.bus.sync_read(
                "Present_Position", normalize=True, num_retry=2
            )
            return {f"{motor}.pos": float(present_deg[motor]) for motor in JOINT_NAMES}
        except BaseException:
            if self.bus.is_connected:
                try:
                    # 只断开串口；重连失败路径禁止再碰扭矩寄存器。
                    self.bus.disconnect(disable_torque=False)
                except BaseException:
                    pass
            raise

    def send_action(
        self,
        action: RobotAction,
        *,
        goal_velocity: int | None = None,
        goal_velocity_by_joint: Mapping[str, int] | None = None,
    ) -> RobotAction:
        """拒绝缺失、额外或六轴旧字段，再交由官方安全步长过滤发送。

        goal_velocity: 可选，所有关节的基础 Goal_Velocity。
        goal_velocity_by_joint: 可选的逐关节覆盖；用于只提高低负载 wrist_roll
        的速度，不能关闭位置反馈。速度配置变化时才重写 SRAM。
        """
        actual_keys = set(action)
        expected_keys = set(JOINT_FEATURES)
        if actual_keys != expected_keys:
            missing_keys = sorted(expected_keys - actual_keys)
            extra_keys = sorted(actual_keys - expected_keys)
            raise ValueError(
                "五轴动作字段必须精确匹配固定契约；"
                f" missing={missing_keys}, extra={extra_keys}"
            )
        if goal_velocity is not None:
            if isinstance(goal_velocity, bool) or not 0 <= int(goal_velocity) <= 32767:
                raise ValueError("goal_velocity 必须是 0..32767 的整数")
            velocity = int(goal_velocity)
            velocities = {motor: velocity for motor in JOINT_NAMES}
            if goal_velocity_by_joint is not None:
                unknown = set(goal_velocity_by_joint) - set(JOINT_NAMES)
                if unknown:
                    raise ValueError(f"速度覆盖包含未知关节: {sorted(unknown)}")
                for motor, override in goal_velocity_by_joint.items():
                    if isinstance(override, bool) or not 0 <= int(override) <= 32767:
                        raise ValueError(f"{motor} 的速度覆盖必须是 0..32767 的整数")
                    velocities[motor] = int(override)
            if velocities != self._last_goal_velocity_by_joint:
                self.bus.sync_write("Goal_Velocity", velocities, num_retry=2)
                self._last_goal_velocity_by_joint = velocities
                self._last_goal_velocity = velocity
        return super().send_action(action)
