kanuba0814/puzzle-arm/workspace/src/integration/_adapter_123.py

"""123 识别+求解算法到 workspace 契约的适配器。

将 Pi ~/puzzle (123项目) 的 vision.py + rect_assembly.py 核心算法
适配到 workspace/src 的 observe_pieces + solve_puzzle 接口，保持数据契约。

自动标定加载：
- 优先使用 workspace/calibration/ 下的正式标定文件（如有）；
- 回退到 pi_puzzle/homography.npy（Pi 现场标定）；
- 都没有则返回标定缺失错误。
"""

import hashlib
import time
from pathlib import Path

import cv2
import numpy as np

from vision._legacy_123_vision import PuzzleVision
from vision.generic_piece_observer import (
    MeasuredContour,
    PieceObservation,
    RectifiedFrame,
    VisionDiagnostics,
    VisionProfile,
    VisionResult,
)
from puzzle._legacy_123_assembly import AssemblySolver
from puzzle.discrete_layout import DiscreteLayoutError, plan_discrete_layout
from puzzle.solver import (
    PlacementPlan,
    Pose2,
    PuzzleOptions,
    PuzzleSolveResult,
    PuzzleSolveStatus,
    TargetRegion,
    WorkspaceState,
)


def _pick_point_table_mm(piece: object) -> tuple[float, float] | None:
    """读取正式 pick_point 字段，并兼容尚未迁移的 legacy grip_point。"""
    value = getattr(piece, "pick_point_table_mm", None)
    if value is None:
        value = getattr(piece, "grip_point_table_mm", None)
    if value is None:
        return None
    point = np.asarray(value, dtype=np.float64)
    if point.shape != (2,) or not np.isfinite(point).all():
        raise ValueError("pick_point_table_mm 必须是两个有限毫米坐标")
    return float(point[0]), float(point[1])


def _find_homography_file() -> Path | None:
    """查找可用的单应矩阵标定文件（workspace 优先，回退 legacy）。
    
    Pi 上路径：
    - /opt/epuzzle/workspace/calibration/*homography*.npy
    - /home/epuzzle/puzzle/homography.npy（legacy 123项目）
    
    宿主上路径：
    - workspace/calibration/*homography*.npy
    - pi_puzzle/homography.npy
    """
    workspace_root = Path(__file__).parent.parent.parent
    
    # 优先：workspace/calibration/ 下任何 homography 文件
    calib_dir = workspace_root / "calibration"
    if calib_dir.exists():
        matches = sorted(calib_dir.glob("*homography*.npy"))
        if matches:
            return matches[0]
    
    # 回退1：../pi_puzzle/homography.npy（宿主机镜像目录）
    pi_puzzle_path = workspace_root.parent / "pi_puzzle" / "homography.npy"
    if pi_puzzle_path.exists():
        return pi_puzzle_path
    
    # 回退2：/home/epuzzle/puzzle/homography.npy（Pi 上 legacy 123项目）
    legacy_pi = Path("/home/epuzzle/puzzle/homography.npy")
    if legacy_pi.exists():
        return legacy_pi
    
    return None


def observe_pieces_123(
    frame: RectifiedFrame, profile: VisionProfile
) -> VisionResult:
    """123 视觉检测适配器：detect_pieces_arbitrary → workspace VisionResult。

    输入：RectifiedFrame（已校正图 + px_per_mm + table_mm_size）
    输出：workspace 标准 VisionResult（含 PieceObservation 列表）
    """
    started_ns = time.monotonic_ns()

    # 加载单应矩阵
    homography_path = _find_homography_file()
    if homography_path is None:
        return VisionResult(
            observations=(),
            status="REJECTED",
            error_code="CALIBRATION_MISSING",
            profile=profile,
            profile_version=profile.profile_id,
            px_per_mm=frame.px_per_mm,
            source_image_sha256="",
            timestamp_ns=started_ns,
            processing_time_ms=0.0,
        )

    # 初始化 123 vision（无相机后端，帧由外部提供）
    vision = PuzzleVision(backend=None)
    vision.load_calibration(str(homography_path))

    # RectifiedFrame 已校正，构造伪 quad 覆盖整图，设置 mm 映射
    h_px, w_px = frame.image.shape[:2]
    table_w_mm, table_h_mm = frame.table_mm_size
    quad_px = np.array(
        [[0, h_px - 1], [w_px - 1, h_px - 1], [w_px - 1, 0], [0, 0]], dtype=np.float32
    )

    # 临时单应矩阵：px → table_mm（Y 轴翻转，原点左下）
    scale = frame.px_per_mm
    vision.homography = np.array(
        [[1 / scale, 0, 0], [0, -1 / scale, table_h_mm], [0, 0, 1]], dtype=np.float64
    )

    # 调用 123 检测
    bgr_frame = (
        frame.image
        if frame.image.ndim == 3
        else cv2.cvtColor(frame.image, cv2.COLOR_GRAY2BGR)
    )
    pieces_123 = vision.detect_pieces_arbitrary(
        frame=bgr_frame, quad=quad_px, flat_th=0.82
    )

    # 转换为 workspace PieceObservation
    observations = []
    image_hash = hashlib.sha256(frame.image.tobytes()).hexdigest()

    for p in pieces_123:
        vertices_mm = p["vertices"]
        contour_px = p.get("contour_px")

        if contour_px is not None:
            contour_points = tuple(
                (float(pt[0]), float(pt[1])) for pt in contour_px.reshape(-1, 2)
            )
        else:
            contour_points = tuple(
                (float(v[0] * scale), float((table_h_mm - v[1]) * scale))
                for v in vertices_mm
            )

        measured = MeasuredContour(frame="rectified_px", points=contour_points)
        polygon = tuple((float(v[0]), float(v[1])) for v in vertices_mm)
        grip_point = p.get("grip_point")
        pick_point = (
            (float(grip_point[0]), float(grip_point[1])) if grip_point else None
        )
        center = tuple(float(c) for c in p["centroid"])
        yaw = float(p.get("angle_deg", 0.0))
        equiv_yaws = (yaw,)

        diag = VisionDiagnostics(
            segmentation_stability=1.0,
            polygon_fit_residual_mm=0.5,
            pick_clearance_ok=None,
            rounded_corner_candidates=0,
            geometry_source="legacy_123_arbitrary",
            touches_frame_border=False,
        )

        obs = PieceObservation(
            piece_id=f"piece_{p['id']:02d}",
            timestamp_ns=started_ns,
            source_image_id=image_hash[:16],
            measured_contour=measured,
            polygon_table_mm=polygon,
            pick_point_table_mm=pick_point,
            pick_clearance_mm=None,
            center_table_mm=center,
            yaw_deg=yaw,
            equivalent_yaws_deg=equiv_yaws,
            confidence=0.85,
            diagnostics=diag,
        )
        observations.append(obs)

    elapsed_ms = (time.monotonic_ns() - started_ns) / 1_000_000.0
    status = "OK" if observations else "REJECTED"
    error_code = None if observations else "NO_PIECES_DETECTED"

    return VisionResult(
        observations=tuple(observations),
        status=status,
        error_code=error_code,
        profile=profile,
        profile_version=profile.profile_id,
        px_per_mm=frame.px_per_mm,
        source_image_sha256=image_hash,
        timestamp_ns=started_ns,
        processing_time_ms=elapsed_ms,
    )


def solve_puzzle_123(
    workspace: WorkspaceState,
    target_region: TargetRegion,
    options: PuzzleOptions,
) -> PuzzleSolveResult:
    """123 拼装求解适配器：AssemblySolver → workspace PuzzleSolveResult。"""
    started = time.monotonic_ns()
    pieces = tuple(sorted(workspace.pieces, key=lambda p: p.piece_id))

    if not 1 <= len(pieces) <= 4:
        return PuzzleSolveResult(
            status=PuzzleSolveStatus.NO_SOLUTION,
            error_code="PIECE_COUNT_OUT_OF_RANGE",
            inferred_target=None,
            placements=(),
            candidates_after_dedup=0,
            best_score=None,
            second_best_score=None,
            score_gap=None,
            score_breakdown={},
            texture_executed=False,
            solver_version="legacy_123_assembly",
            profile_version="",
            calibration_refs={},
            timing_ms={},
            expansions=0,
            pruned=0,
        )

    try:
        pick_points = tuple(_pick_point_table_mm(piece) for piece in pieces)
    except (TypeError, ValueError) as error:
        return PuzzleSolveResult(
            status=PuzzleSolveStatus.NO_SOLUTION,
            error_code="INVALID_PICK_POINT",
            inferred_target=None,
            placements=(),
            candidates_after_dedup=0,
            best_score=None,
            second_best_score=None,
            score_gap=None,
            score_breakdown={},
            texture_executed=False,
            solver_version="legacy_123_assembly+discrete-v1",
            profile_version="",
            calibration_refs={},
            timing_ms={"total_ms": (time.monotonic_ns() - started) / 1_000_000.0},
            expansions=0,
            pruned=0,
            diagnostics={"extra": {"pick_point_error": str(error)}},
        )

    # 拼图匹配始终使用视觉实测的原版几何；5 mm 间距只在严格解产生后
    # 通过每片平移加入，不改变 source/grip 坐标和求解器旋转。
    pieces_verts = [
        np.asarray(piece.polygon_table_mm, dtype=np.float64) for piece in pieces
    ]

    # 调用 123 求解器
    # fit_margin 补偿检测轮廓侵蚀；AssemblySolver 通过 getattr 读取，
    # 不是构造参数，所以实例化后再设置。
    solver = AssemblySolver(edge_tol=options.abs_tolerance_mm, verbose=False)
    solver.fit_margin = 0.15
    solution = solver.solve(pieces_verts)

    elapsed_ms = (time.monotonic_ns() - started) / 1_000_000.0

    if solution is None:
        return PuzzleSolveResult(
            status=PuzzleSolveStatus.NO_SOLUTION,
            error_code="ASSEMBLY_FAILED",
            inferred_target=None,
            placements=(),
            candidates_after_dedup=0,
            best_score=None,
            second_best_score=None,
            score_gap=None,
            score_breakdown={},
            texture_executed=False,
            solver_version="legacy_123_assembly",
            profile_version="",
            calibration_refs={},
            timing_ms={"total_ms": elapsed_ms},
            expansions=0,
            pruned=0,
        )

    # 123 求解在“碎片 0 为锚点”的原始散落坐标系内完成；离散布局模块
    # 只对 placed_verts 求每片平移，并在输出计划前验收所有片对净距。
    placed_verts = tuple(
        np.asarray(polygon, dtype=np.float64)
        for polygon in solution["placed_verts"]
    )
    rect_size = solution["rect_size"]
    try:
        discrete_layout = plan_discrete_layout(
            placed_verts,
            clearance_mm=options.placement_gap_mm,
            target_bounds_mm=(
                target_region.min_x_mm,
                target_region.min_y_mm,
                target_region.max_x_mm,
                target_region.max_y_mm,
            ),
        )
    except DiscreteLayoutError as error:
        return PuzzleSolveResult(
            status=PuzzleSolveStatus.NO_SOLUTION,
            error_code="DISCRETE_LAYOUT_FAILED",
            inferred_target=(float(rect_size[0]), float(rect_size[1])),
            placements=(),
            candidates_after_dedup=1,
            best_score=solution.get("score"),
            second_best_score=None,
            score_gap=None,
            score_breakdown={"assembly": float(solution.get("score", 0.0))},
            texture_executed=False,
            solver_version="legacy_123_assembly+discrete-v1",
            profile_version="",
            calibration_refs={},
            timing_ms={"total_ms": elapsed_ms},
            expansions=0,
            pruned=0,
            diagnostics={"extra": {"layout_error": str(error)}},
        )

    # 构造 PlacementPlan（per-piece）
    # 参考点语义：机械臂磁头吸住的是视觉给出的握点 grip_point（最大内切圆
    # 圆心），不是多边形质心。旋转时碎片绕握点转，因此 PICK/PLACE 的坐标
    # 必须用握点的变换位置。若用质心（早期版本），大旋转片会因握点-质心
    # 偏心被放大成 10mm+ 落位偏差（piece_01 实测偏 12mm，偏心 29.7mm）。
    placements = []
    for index, piece in enumerate(pieces):
        rotation, translation = solution["transforms"][index]
        grip = pick_points[index]
        source_reference = np.asarray(
            grip if grip is not None else piece.center_table_mm,
            dtype=np.float64,
        )
        layout_translation = np.asarray(
            discrete_layout.translations_mm[index], dtype=np.float64
        )
        # AssemblySolver 的变换直接作用于原始 table_mm 顶点；参考点必须使用
        # 同一个 R @ p + t，再加离散平移。禁止假设 center 等于顶点算术均值。
        target_grip = (
            rotation @ source_reference
            + np.asarray(translation, dtype=np.float64)
            + layout_translation
        )
        target_center_mm = target_grip
        delta_yaw_deg = float(
            np.degrees(np.arctan2(rotation[1, 0], rotation[0, 0]))
        )
        # 旋转基准约定（0° 基准，2026-08-01）：不测量碎片绝对朝向。
        # 相机拍下的初始位置一律视为 0°，旋转量直接采用求解器相对旋转
        # delta_yaw_deg（拼图只需碎片之间的相对方向）。
        # 机械臂执行端（run_assembly_4pieces.py）负责补偿自身 pan 变化，
        # 保证碎片相对桌面旋转 = Δpan + Δroll = Δyaw（模 360）。
        # 删除理由：质心→最远顶点几何朝向对轮廓噪声敏感，接近对称形状时
        # 会跳变 180°；且电磁吸头点接触下碎片绝对朝向无夹持约束，测量它
        # 对拼接结果没有意义。
        source_yaw = 0.0
        final_yaw = (delta_yaw_deg + 180.0) % 360.0 - 180.0

        source_pose = Pose2(
            frame="table_mm",
            center_mm=grip or piece.center_table_mm,
            yaw_deg=source_yaw,
        )
        target_pose = Pose2(
            frame="table_mm",
            center_mm=(float(target_center_mm[0]), float(target_center_mm[1])),
            yaw_deg=final_yaw,
        )

        plan = PlacementPlan(
            piece_id=piece.piece_id,
            order=index,
            source=source_pose,
            target=target_pose,
            geometry_score=float(solution.get("score", 0.0)),
            texture_score=None,
            texture_status="disabled",
            plan_confidence=0.6 if solution.get("approximate") else 0.9,
            source_timestamp_ns=piece.timestamp_ns,
            equivalent_yaws_deg=piece.equivalent_yaws_deg,
            solver_version="legacy_123_assembly+discrete-v1",
        )
        placements.append(plan)

    score = solution.get("score", 0.0)
    status = (
        PuzzleSolveStatus.AMBIGUOUS
        if solution.get("approximate", False)
        else PuzzleSolveStatus.SOLVED
    )

    return PuzzleSolveResult(
        status=status,
        error_code=None,
        inferred_target=(float(rect_size[0]), float(rect_size[1])),
        placements=tuple(placements),
        candidates_after_dedup=1,
        best_score=score,
        second_best_score=None,
        score_gap=None,
        score_breakdown={
            "assembly": score,
            "placement_gap_mm": options.placement_gap_mm,
            "minimum_pair_clearance_mm": float(
                discrete_layout.minimum_clearance_mm or 0.0
            ),
        },
        texture_executed=False,
        solver_version="legacy_123_assembly+discrete-v1",
        profile_version="",
        calibration_refs={},
        timing_ms={"total_ms": elapsed_ms},
        expansions=0,
        pruned=0,
        diagnostics={
            "extra": discrete_layout.as_diagnostics(
                tuple(piece.piece_id for piece in pieces),
                options.placement_gap_mm,
            )
        },
    )
