kanuba0814/puzzle-arm/pi_puzzle/workspace/tools/calibrate_single_arm.py

#!/usr/bin/env python3
# pyright: reportMissingImports=false

"""用机械端点计算中位的五轴 SO-101 follower 标定向导。

默认仅预检。实际流程只读取人工手掰位置并写入 Homing_Offset/范围；不会发送
Goal_Position。J1–J4 依次记录两个机械端点，中位 raw 由软件计算，不要求刻度或
目测中位；J5 由用户选择电缆安全的零向并保留完整一圈。
"""

from __future__ import annotations

import argparse
import hashlib
import json
import shutil
import statistics
import sys
import time
from pathlib import Path

from control.motor_calibration import ENCODER_MAX, HALF_TURN, center_motor_range
from lerobot.motors import MotorCalibration
from lerobot_robot_so101_5d import (
    JOINT_NAMES,
    SO101Follower5D,
    SO101Follower5DConfig,
)

CONFIRM_TEXT = "CALIBRATE-SINGLE-FOLLOWER-5D"
WRITE_CONFIRM_TEXT = "WRITE-CENTERED-CALIBRATION"
DEFAULT_PORT = Path("/dev/serial/by-id/usb-1a86_USB_Single_Serial_5AB9067408-if00")
DEFAULT_CALIBRATION_DIR = (
    Path.home() / ".cache/huggingface/lerobot/calibration/robots/so101_follower_5d"
)
ENDPOINT_JOINTS = JOINT_NAMES[:4]
JOINT_LABELS = {
    "shoulder_pan": "J1 底座旋转",
    "shoulder_lift": "J2 肩关节",
    "elbow_flex": "J3 肘关节",
    "wrist_flex": "J4 腕俯仰",
    "wrist_roll": "J5 腕旋转",
}


def build_parser() -> argparse.ArgumentParser:
    parser = argparse.ArgumentParser(
        description="由机械端点自动计算中位；单台原 follower 改装五轴"
    )
    parser.add_argument("--port", type=Path, default=DEFAULT_PORT)
    parser.add_argument("--robot-id", default="epuzzle-single-arm")
    parser.add_argument("--calibration-dir", type=Path, default=DEFAULT_CALIBRATION_DIR)
    parser.add_argument("--minimum-span-counts", type=int, default=500)
    parser.add_argument(
        "--execute",
        action="store_true",
        help="实际连接、释放力矩并记录端点；默认只预检",
    )
    parser.add_argument(
        "--replace-existing",
        action="store_true",
        help="备份并替换同 robot-id 的已有五轴标定",
    )
    parser.add_argument("--confirm", default="")
    return parser


def sha256_file(path: Path) -> str:
    digest = hashlib.sha256()
    try:
        with path.open("rb") as calibration_file:
            for block in iter(lambda: calibration_file.read(1024 * 1024), b""):
                digest.update(block)
    except OSError as exc:
        raise RuntimeError(f"无法读取标定文件 {path}: {exc}") from exc
    return digest.hexdigest()
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
