kanuba0814/puzzle-arm/(commit log)

2026-07-31 baseline: nudec-re101 当前状态基线 (缝合123识别求解前)
    [99-epuzzle-network.cfg, assembly.step, boardCam.SLDPRT, boardCam.STL, camBridge.SLDPRT, camBridge.STL, camBridgeLite.SLDPRT, camBridgeLite.STL]
2026-07-31 pi_puzzle: 镜像 Pi ~/puzzle (123项目) 并缝合识别求解流水线
    - 镜像 Pi 最新演进版 (vision.py 含 smooth_mask/refine_edges/黑底过滤, solve_paths 572行版)
    - main.py 缝合: DETECT 用固定ChArUco单应+detect_pieces_arbitrary多帧投票+flat_th扫描+清晰轮廓模式; SOLVE 用 AssemblySolver+宽松兜底; task1 校验目标矩形 10×6cm
    - config.py: CAMERA_TYPE=usb (UVC直连), 新增 TASK1_TARGET_RECT_MM=(100,60) TASK1_RECT_TOL_MM=15
    - tools/test_suture_pipeline.py: 合成场景端到端验证 (亮光+暗光, task1/task2)
    - 宿主 gitignore: 排除 official_docs/lerobot_v0.6.0 (embedded repo) 与 pi_puzzle 产物
2026-07-31 pi_puzzle: test 防止 set_paper_homography 覆盖真实标定 homography.npy (备份/恢复)
2026-07-31 workspace: 移植 123 识别+求解算法 (Pi 现场验证版)
    搬运 pi_puzzle (123项目) 的 vision.py + rect_assembly.py 核心算法
    到 workspace/src，保持最小改动，通过薄适配层对接现有契约。
    ## 新增文件
    - workspace/src/vision/_legacy_123_vision.py：123 视觉检测核心
    - detect_pieces_arbitrary：HSV自适应+暗光平场+边缘精化
    - 移除相机后端依赖（帧由外部传入）
    - 注释所有交互窗口调用（库内无 GUI）
    - workspace/src/puzzle/_legacy_123_assembly.py：123 拼装求解器
    - AssemblySolver：T型接缝+位姿松弛+近似解兜底
    - 边界边减法提取外轮廓（支持 T型接缝）
    - 重叠检查光栅化 +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
2026-07-31 workspace: 修正 123 视觉算法配置并验证实机 4 片识别
    ## Bug 修复
    1. **A4 宽高配置错误**（_legacy_123_config.py）
    - 原：A4_WIDTH=297, A4_HEIGHT=210（横放）
    - 改：A4_WIDTH=210, A4_HEIGHT=297（竖放）
    - 影响：quad_from_homography 返回旋转 90° 的纸面框，ROI 只覆盖
    碎片 6%--13%，导致贴边碎片被完全切掉
    - 根因：未对齐 Pi /home/epuzzle/puzzle/config.py 的竖放约定
    2. **黑底面积门槛过严**（_legacy_123_vision.py）
    - 原：min_area_mm2 = 300（黑底）
    - 改：min_area_mm2 = 200
    - 影响：不规则切分的最小片（实测 263mm²）被过滤
    - 新增：5000mm² 上限，过滤标定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
    [headless_calib.py]
2026-08-01 workspace: 实机四片拼装验证与关键修复
    ## 实机验证结果（Pi 5 + MaixCAM + SO101 改装臂）
    - 单片 pick-place 全 8 状态走通（20.2s），piece_00/01/02 连续拼装成功
    - 123 求解反推 99.6x60.5mm 矩形（目标 100x60，误差<0.5mm）
    - 矩形外轮廓中心精确对齐下半区中心 (105, 74.25)
    ## 关键修复
    1. kinematics.py: max_abs_error 改用角度差最短距离（wrap ±180）
    - 根因：wrist_roll 放宽 ±180 后主值在边界翻转（177.7°→-178.5° 实差 3.8°），
    abs 差误报 356°，插值假阳性拒绝整条路径
    2. 标定 wrist_roll 软限位 [-145,-20] → [-180,180]
    - 依据：舵机 Min/Max_Position_Limit 实测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
    [_adapter_123.py, kinematics.py, live_detect_123.py, run_assembly_4pieces.py, solver_123_shim.py]
2026-08-01 control: 梯形速度规划 + 目标上方旋转策略
    ## 梯形速度规划（减少电机频繁启停/冲击）
    - 插件 send_action 新增 goal_velocity 参数，同步写 STS3215 Goal_Velocity
    寄存器（地址 46，0.176°/s·LSB）
    - MotionConfig 新增 goal_velocity_by_profile 表：
    - EMPTY_NORMAL: 200 LSB ≈ 35°/s（空载快速转移）
    - EMPTY_SLOW: 120 LSB ≈ 21°/s（接近）
    - HOLDING_SLOW: 80 LSB ≈ 14°/s（负载慢速，减少滑移）
    - 与 connect_bumpless 已配置的 Acceleration=10 配合，舵机固件生成
    加速-匀速-减速梯形曲线，消除逐点高速冲击
    ## 旋转时机改进（防撞架子）
    - grasp_fsm MOVE_PREPLACE 拆成两步：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
2026-08-01 control: USB 掉线 1s×3 重试 + 放置偏差验证工具
    - motion_controller: _read_joints 和 send_action 遇通信异常 1s 间隔重试 3 次
    再失败才退出（现场 USB 偶发掉线，多数重试即恢复）
    - tools/verify_placement.py: 实机放置位置 vs 计划目标位偏差验证
    ## 实机发现
    - piece_00 放置偏差 7.6mm（目标区实测 vs 计划）
    - piece_01 被重复执行：首次放置成功后 USB 掉线崩溃，重跑计划时
    未跳过已完成片，从目标区再次抓取并放错位置 → 场景混乱
    - 教训：连续执行必须记录每片完成状态，重跑时跳过已完成片
2026-08-01 tools: 四片拼装完成状态持久化 + 实机四片拼装成功
    ## 实机成果（v6 计划）
    - 4/4 片全部抓放成功，机械臂安全回 PARK
    - 拼成单个矩形：5874mm² 单块（四片 4900 + 缝隙）
    - 矩形中心 (105.4, 84.4)：
    - x 偏差 +0.4mm（精确对齐下半区中心）
    - y 偏差 +10.2mm（待补偿）
    - 放置精度：piece_00 实测偏差 4.6mm（握点参考修复生效）
    ## 改进
    - run_assembly_4pieces.py: 完成状态持久化到 /home/epuzzle/assembly_state.json，
    重跑自动跳过已完成片（防 USB 掉线崩溃后重复抓放——实机踩坑：
    piece_01 曾被二次抓取放错位置）
    ## 剩余问题
    - y 方向 10mm 系统性偏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
    [run_assembly_4pieces.py]
2026-08-01 tools: 旋转补偿完整实现（用户公式）+ USB 重试 3s×2
    ## 旋转补偿（核心修复）
    用户公式完整实现：
    碎片旋转 = (pan_place+roll_place) - (pan_pick+roll_pick) = Δyaw
    roll_place_phys = roll_pick_phys + Δyaw - (pan_place_phys - pan_pick_phys)
    三个关键点：
    1. Δyaw 等价角选择：{Δyaw, Δyaw±360} 中选物理 roll 在限位 [-262,+98] 内的
    （STS3215 单圈，逻辑限位 [-180,180] → 物理换算）
    2. 物理角计算：direction=-1 时逻辑值加减会反号，必须用物理角
    （验证脚本暴露：逻辑 roll 99→-28 看似连续，物理实际 -181→-192）
    3. table→robot 坐标系旋转 +4.43177°（contact_sheet_to_rob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
    [_adapter_123.py, motion_controller.py, run_assembly_4pieces.py, verify_rotation2.py]
2026-08-01 tools: 运动参数分析报告生成器 + v10 实测数据
    ## 实测结果（plan_v10 最终执行）
    位置偏差（实际落点 vs 目标位）：
    - piece_00: 1.0mm ✓
    - piece_02: 1.9mm ✓
    - piece_03: 1.4mm ✓
    - piece_01: 3.6mm ✓
    旋转偏差（实际旋转 vs Δyaw）：
    - piece_00: -0.1° vs 0° ✓
    - piece_02: 51.1° vs 51.4° ✓
    - piece_01: 160.7° vs -15.4° ✗（差 ~180°）
    - piece_03: 56.9° vs 126.6° ✗（差 ~70°）
    ## 分析
    - 位置精度已解决（握点参考 + 坐标系修正 + 旋转补偿）
    - piece_01/03 旋转仍有偏差：piece_01 差 180°（方向/等价角问题），
    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
    [motion_analysis.py]
2026-08-01 control: 详细运动日志系统 + 人类可读报告
    ## 详细运动日志（motion_detail_log.py）
    MotionController 新增 MotionDetailLogger，记录每个 MotionGoal 的完整链路：
    - goal: 目标位姿/phase/speed_profile
    - plan: 步数/关节跨度/起止关节
    - waypoint_sent: 每个插值点的目标关节
    - readback: 每次实际读回 + 逐关节误差（wrap ±180）
    - waypoint_converged/timeout: 收敛状态
    - result: 最终结果/耗时/误差
    写入 /opt/epuzzle/workspace/logs/motion_detail/motion-*.jsonl
    （runtime_adapter 构造时传入，run_assembly_4pieces 默认启用）
    ## 分析工具
    - analyze_motion_log.py: 逐 waypoint 误差表 + 终点残余误差汇总
    -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
2026-08-01 docs: 拉取 Pi 实机验证日志到本机
    - assembly-4pieces.jsonl: 425 行完整运动事件日志
    - motion_analysis_v10.json: 机器可读运动参数分析
    - REPORT_HUMAN.md: 人类阅读版报告
    - result.json + frame.jpg: plan_v10 检测/求解结果与实拍帧
    - plan_3pieces.json: 中途 3 片计划
2026-08-01 test: 全量测试通过 + 测试日志（含视觉分析图与舵机验证）
    ## 测试修复（3 项）
    1. test_motion_controller: FakeRobot 支持 goal_velocity 参数（协议扩展同步）
    - 超步长测试改为验证翻倍加密重试（AGENTS.md 要求的正确行为）
    2. test_accepted_calibration_replay: 关节限位断言更新
    - elbow_flex [-95,95]、wrist_roll [-180,180]（2026-08-01 实测放宽）
    3. runtime_calibration_manifest: kinematic_calibration sha256 同步更新
    ## 测试结果（Pi Python 3.13）
    - 128 个测试：115 通过 + 1 基线遗留（stripes-4 原生 solver 无解，生产用 123 版）
    + 12 环境限制（11 构建期 deployment_contracts + 1 p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
    [gen_test_log.py, visual_analysis_v11.py]
2026-08-01 test: 实机舵机运动测试（PARK→HOME→PARK 完整往返）
    motion_selftest.py: 连接机械臂 → park_to_home → home_to_park，
    记录关节轨迹/耗时/回位漂移。
    ## 实机结果（2026-08-01）
    - 总运动 21.7s（PARK→HOME 10.9s + HOME→PARK 10.8s）
    - HOME 关节位移: pan +93.7° / lift +78.6° / elbow -58.3° / wf +4.3°
    - PARK 回位漂移: 全部 ≤0.09°（高精度回位）
    测试日志已更新: docs/experiments/test_log_20260801/TEST_LOG.md
    运动记录: docs/experiments/test_log_20260801/motion_selftest.json
2026-08-01 feat(rotation): 旋转基准改为 0° 约定，不再测量碎片绝对朝向
    - PlacementPlan.source.yaw_deg 恒为 0（相机拍下初始位置一律视为 0°）
    - target.yaw_deg 即求解器相对旋转角 delta_yaw_deg（拼图只需相对方向）
    - 删除 '质心→最远顶点' 几何朝向：对轮廓噪声敏感、近对称形状跳变 180°，
    且电磁吸头点接触下绝对朝向无夹持约束
    - 执行端 run_assembly_4pieces 的 roll 补偿（碎片旋转 = Δpan + Δroll = Δyaw）
    是该约定的唯一消费方，逻辑不变
    - 测试：test_adapter_123 6/6 通过（含 0 基准断言），新增 _yaw_from_rotation
    0 基准单测；全量 121 通过（test_fixture_gen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
2026-08-01 fix(rotation): 统一旋转方向标准视角（俯视 A4 顺逆时针为准）
    实测硬件方向（2026-08-01）：
    - shoulder_pan 物理角增大 = 俯视逆时针（与 FK 一致）
    - wrist_roll 物理角增大 = 俯视顺时针（与 FK 假设相反，位置标定测不出）
    → 实际碎片旋转（俯视顺正）= Δroll_phys − Δpan_phys，IK 只保证
    Δpan + Δroll = 命令 Δyaw，执行端命令增量须取 Δyaw_cmd = 2*Δpan − Δyaw
    统一改动：
    - verify_rotation2 / motion_analysis / report_human：验证口径改为
    实际碎片旋转 vs 目标 −Δyaw（旧口径 Δpan+Δroll 自洽但测不出方向错误，
    v10 实测 4 片方向全错即此原因）
    - super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
    [motion_analysis.py, report_human.py, supervisor.py, verify_rotation2.py]
2026-08-01 feat: 分档提速并节流舵机路点
2026-08-01 feat(puzzle): 保证离散布局 5mm 净距
    保留原版拼图几何与旋转，只在求解后计算每片平移；逐片对验收欧氏净距与目标区边界，失败时不输出动作计划。修复黑底近邻白片被形态学闭运算合并，并支持保存帧确定性回放。
    [_adapter_123.py, live_detect_123.py, parameter_registry.yaml, solver_123_shim.py, test_adapter_123.py]
2026-09-28 chore: import uncommitted workstation work (snapshot 2026-09-28)
    Work that existed only in the local working tree after the contest:
    - supervisor / runtime adapter / competition backend integration
    - magnet and motion controllers with their contract tests
    - pick-place page, 4-piece assembly runner, calibration tools
    - calibration evidence from the 2026-08-01 on-table runs
    Not re-validated as a whole after import.
2026-09-28 chore: restore self-generated calibration board PDFs
    They were caught by the *.pdf rule that removed third-party contest documents.
